young-whites/microcurrent-beauty-device-v10/docs/项目需求文档.md

# DJM-V10 微电流美容仪 - 项目需求文档

> **版本**: V4.1  
> **日期**: 2026-08-01  
> **适用平台**: STM32F103RCT6 / RT-Thread v5.1.0 / STM32 HAL

---

## 一、文档变更记录

| 版本 | 日期 | 作者 | 主要改动 |
|---|---|---|---|
| V1.0 | 2026-06-12 | — | 初始版本，NTC 温度传感器参考表从通讯协议文档迁入 |
| V2.0 | 2026-06-17 | — | 基于源码分析大幅扩充：新增硬件平台、软件架构、通信协议、功能模块、波形系统、安全机制、数据模型、接口定义、非功能需求 |
| V2.1 | 2026-07-08 | — | 同步代码变更：新增 ntc_sensor/temp_pid/nnc6521_waveform_config 模块，更新文件结构，移除已实现的 TODO 项，更新温度控制和波形切换状态 |
| V2.2 | 2026-07-09 | — | 修正加热控制引脚：小手柄 PC10（非 PC12），大手柄 PC11 |
| V3.0 | 2026-07-09 | — | 新增电源管理系统、BSP 驱动层（LED/KEY/BEEP/HARD）、macTask 任务层，重构系统架构与全局标志位 |
| V3.1 | 2026-07-09 | — | 拆分 protocol.c 为 protocol.c（协议驱动）+ protocol_act.c（动作处理），更新接口定义与目录结构 |
| V3.2 | 2026-07-09 | — | 手柄切换改为互斥模式：切换时清零其他手柄参数，关闭所有输出 |
| V3.3 | 2026-07-13 | — | 电源控制逻辑重构：按键改为短按开机/短按关机请求（去掉2s/4s长按），关机需上位机确认（10s超时不关机）；54V boost与治疗启停联动；加热器/水泵协议→硬件联动；LED_Name_Green→LED_Name_Start |
| V3.5 | 2026-07-14 | — | 新增温度周期上报功能（0x0B）、PID 参数自整定功能（0x0C）；温度编码改为 temp*10 int16 大端序 |
| V3.6 | 2026-07-14 | — | 新增「电刺激模块完整流程」和「温控模块完整流程」章节，含初始化、启动、运行、停止全流程图及寄存器说明 |
| V3.7 | 2026-07-14 | — | 泵控制改为 DAC7311 调压控制（0~5V），新增泵控完整流程、DAC7311 驱动规格、VOFA+ PID 调试输出说明 |
| V3.9 | 2026-07-23 | — | 温度控制从直接温度值改为百分比(0~100)，映射20~41°C；电流档位映射表线性化 |
| V4.0 | 2026-07-31 | — | 微电流输出改为全局功能：电流控制(0x02)删除 handle_id 参数；手柄切换(0x01)保留电流/波形参数；手柄功能矩阵更新；电流档位范围从 0~80 改为 0~10（查表获取实际 μA）；NNC6521 仅使用 CHIP_2 CH0 作为全局微电流输出；54V boost 使用 LGS6302EP-2 (PB1) 作为全局电流供电 |
| V4.1 | 2026-08-01 | — | 明确电流输出全局行为：切换手柄时电流/波形输出不停止（仅受开始/暂停治疗控制）；档位=0 时停止波形输出；A/B/C 加热与泵控互斥规则不变 |

---

## 二、项目概要

- **项目名称**: DJM-V10 微电流美容仪
- **项目路径**: `I:\Github-young-whites\microcurrent-beauty-device-v10`
- **代码路径**: `I:\Github-young-whites\microcurrent-beauty-device-v10\workItem-djm-v10-LTS`
- **设备地址**: `0x6066`（高字节 0x60，低字节 0x66）
- **固件版本**: V1.0（主版本 0x01，次版本 0x00）
- **功能概述**: 一款支持 3 个手柄的微电流美容仪，通过 Android 设备控制，支持 9 种微电流波形、温度加热、泵驱动等功能

---

## 三、硬件平台

### 3.1 MCU 规格

| 参数 | 值 |
|---|-----|
| 芯片型号 | STM32F103RCT6 |
| 内核 | ARM Cortex-M3 |
| 封装 | LQFP64 |
| 主频 | 72MHz（HSE + PLL x9） |
| Flash | 256KB |
| RAM | 48KB |
| 开发工具链 | GCC（STM32CubeIDE / Makefile） |
| HAL 库版本 | STM32Cube FW_F1 V1.8.7 |

### 3.2 时钟配置

| 时钟域 | 频率 |
|---|---|
| SYSCLK | 72 MHz |
| AHB (HCLK) | 72 MHz |
| APB1 | 36 MHz（HCLK/2） |
| APB2 | 72 MHz |
| APB1 Timer | 72 MHz |
| APB2 Timer | 72 MHz |
| ADC | 12 MHz（APB2/6） |

### 3.3 外设分配

| 外设 | 功能 | 引脚 |
|---|---|---|
| USART1 | Android 设备通信（9600bps, 8N1） | PA9(TX) / PA10(RX) |
| USART2 | Debug 调试日志（115200bps, 8N1） | PA2(TX) / PA3(RX) |
| ADC1_CH10 | 大手柄 NTC 温度采集 | PC0 |
| ADC1_CH11 | 小手柄 NTC 温度采集 | PC1 |
| GPIO Output | 蜂鸣器（BEEP） | PA7 |
| GPIO Output | 小手柄加热控制 | PC10 |
| GPIO Output | 大手柄加热控制 | PC11 |

### 3.4 NNC6521 双芯片引脚映射

本项目使用两颗 NNC6521 微电流刺激芯片，通过软件 SPI（GPIO Bit-Bang）驱动。

| 功能 | Chip 1（NNC6521_1） | Chip 2（NNC6521_2） |
|---|---|---|
| MOSI | PC9 | PB13 |
| CSN | PC8 | PB12 |
| SCLK | PC7 | PB11 |
| MISO | PA8 | PB14 |
| CHIP_EN | PA12 | PC6 |
| INTB（中断） | PA11 | PB15 |

**SPI 时序**: CPOL=0, CPHA=0, MSB First  
**写协议**: 4 字节 `[addr, cmd(0x80/0xC0), data, 0x00]`  
**读协议**: 3 字节 `[addr, cmd(0x00/0x40), dummy]` → 返回数据  
**cmd 含义**: `0x80` = 普通寄存器写, `0xC0` = 波形寄存器写, `0x00` = 普通寄存器读, `0x40` = 波形寄存器读  
**位操作时序**: MOSI 建立后 4x NOP (~55ns)，SCLK 高电平 8x NOP，SCLK 低电平 4x NOP  
**CHIP_EN 复位**: 低电平 ≥1ms → 高电平 ≥5ms

---

## 四、软件架构

### 4.1 RT-Thread 内核配置

| 配置项 | 值 |
|---|-----|
| RT-Thread 版本 | v5.1.0 (0x50100) |
| 线程优先级范围 | 32 级 |
| 系统 Tick 频率 | 1000 Hz（1ms） |
| 最大线程名长度 | 8 字符 |
| 内存管理 | 小内存管理（small_mem） |
| IPC 机制 | 信号量、互斥量、事件、邮箱、消息队列 |
| 设备框架 | 串口驱动（Serial V1） |
| 终端 Shell | MSH（FinSH） |
| idle 线程栈 | 256 字节 |
| timer 线程栈 | 512 字节，优先级 4 |

### 4.2 模块层次结构

```
┌──────────────────────────────────────────────────┐
│                   main.c                          │
│  HAL_Init → SystemClock_Config → MX_GPIO_Init    │
│  → MX_USART1/2_Init → MX_ADC1_Init               │
├──────────────────────────────────────────────────┤
│              macSYS（系统层）                      │
│  bsp_sys.h      → 全局头文件聚合                   │
│  bsp_typedef.h  → 全局数据结构（Record, Flag）     │
│  rtt_system_work → 10ms 周期定时器框架             │
├──────────────────────────────────────────────────┤
│              macBSP（驱动层）                       │
│  protocol.h/.c          → UART 协议帧收发与解码    │
│  protocol_act.h/.c      → 命令分发与动作处理       │
│  nnc6521.h              → NNC6521 驱动 API 声明    │
│  nnc6521_reg.h          → NNC6521 寄存器定义       │
│  nnc6521_spi.c          → 软件 SPI 驱动            │
│  nnc6521_drv.c          → NNC6521 高级驱动         │
│  nnc6521_waveform.c     → 预定义波形数据           │
│  nnc6521_waveform_config → 9 种波形配置与应用      │
│  ntc_sensor.h/.c        → NTC 温度采集与转换       │
│  temp_pid.h/.c          → PID 温度控制器           │
├──────────────────────────────────────────────────┤
│         RT-Thread Kernel + HAL Library             │
└──────────────────────────────────────────────────┘
```

### 4.3 线程与定时器

| 名称 | 类型 | 优先级 | 栈大小 | 周期 | 功能 |
|---|---|---|---|---|---|
| main | 线程 | 10 | 2048 | — | CubeMX 主循环 + 模块初始化 |
| power_task | 线程 | 15 | 512 | 20ms | 电源管理状态机（开机/关机） |
| proto_decode | 线程 | 10 | 2048 | — | UART1 协议解码线程 |
| LED_Thread | 线程 | 9 | 4096 | 10ms | LED 驱动扫描（呼吸/闪烁） |
| tshell (FinSH) | 线程 | 20 | 4096 | — | MSH 调试终端 |
| sysTimer | 软件定时器 | 4 | — | 1ms | 系统定时器：分频触发 1ms/10ms/50ms/500ms/1s 回调 |
| keyTimer | 软件定时器 | — | — | 10ms | 按键扫描定时器（消抖+事件检测） |
| beepTimer | 软件定时器 | — | — | 1ms | 蜂鸣器驱动定时器（鸣叫模式） |
| proto_rx_sem | 信号量 | — | — | — | UART1 接收中断唤醒解码线程 |

### 4.4 自动初始化

| 模块 | 初始化函数 | 触发级别 | 说明 |
|---|---|---|---|
| 系统定时器 | `sysTimer_Init()` | `INIT_APP_EXPORT` | 1ms 周期定时器 |
| 协议模块 | `protocol_init()` | `INIT_APP_EXPORT` | UART1 + 解码线程 |
| 按键定时器 | `keyTimer_Init()` | `INIT_APP_EXPORT` | 10ms 按键扫描 |
| 蜂鸣器定时器 | `beepTimer_Init()` | `INIT_APP_EXPORT` | 1ms 蜂鸣器驱动 |
| LED 线程 | `LED_Thread_Init()` | `INIT_APP_EXPORT` | 10ms LED 扫描 |
| 电源管理 | `power_task_init()` | `main()` 手动调用 | 在 NNC6521 初始化之后 |

---

## 五、通信协议

### 5.1 帧格式

```
+--------+--------+------+--------+--------+------+-------+------+-------+-------+
| HEAD1  | HEAD2  | LEN  | ADDR_H | ADDR_L | TYPE | STATE | FUNC | PARAMS| CRC16 |
| 0x55   | 0xAA   | var  | 0x60   | 0x66   | var  | var   | var  | var   | 2B    |
+--------+--------+------+--------+--------+------+-------+------+-------+-------+
```

| 字段 | 长度 | 说明 |
|---|---|---|
| HEAD1 | 1B | 固定 0x55 |
| HEAD2 | 1B | 固定 0xAA |
| LEN | 1B | 从 LEN 字段本身到 PARAMS 末尾的字节数（不含 HEAD1/HEAD2，不含 CRC） |
| ADDR_H | 1B | 设备地址高字节（0x60） |
| ADDR_L | 1B | 设备地址低字节（0x66） |
| TYPE | 1B | 帧类型：0x44=动作命令，0x45=参数查询 |
| STATE | 1B | 帧状态：0x02=主机请求(ASK)，0x01=设备应答(ACK) |
| FUNC | 1B | 功能码（0x01~0x0A） |
| PARAMS | NB | 功能参数（长度由 LEN 决定） |
| CRC16 | 2B | CRC16-MODBUS，计算范围为 LEN ~ PARAMS 末尾 |

### 5.2 CRC16-MODBUS 算法

- 初始值: `0xFFFF`
- 多项式: `0xA001`（反转）
- 计算范围: LEN 字段到 PARAMS 最后一个字节

### 5.3 解码状态机

```
IDLE → HEAD2 → LENGTH → ADDR_H → ADDR_L → PAYLOAD → CRC_H → CRC_L
  ↑                                                             │
  └─────────────────── 校验失败 / 正常完成 ──────────────────────┘
```

### 5.4 串口缓冲区配置

| 参数 | 值 |
|---|-----|
| 接收环形缓冲区 | 512 字节 |
| 发送缓冲区 | 64 字节 |
| 最大帧长度 | 64 字节 |
| 命令解码缓冲区 | 32 字节 |
| UART 接收缓冲区 | 1024 字节（rt_device buf） |

---

## 六、功能需求（分模块）

### 6.1 手柄切换模块（功能码 0x01）

**功能描述**: 切换当前活动手柄。

| 手柄 ID | 手柄名称 | 功能 |
|---|---|---|
| 0x0A | 手柄 A | 仅加热（微电流为全局功能） |
| 0x0B | 手柄 B | 仅加热（微电流为全局功能） |
| 0x0C | 手柄 C | 仅泵（微电流为全局功能） |
| — | 全局 | 微电流输出，上电即存在，所有界面可调 |

**请求参数**:
| 字段 | 长度 | 说明 |
|---|---|---|
| handle_id | 1B | 目标手柄 ID（0x0A/0x0B/0x0C） |

**应答参数**:
| 字段 | 长度 | 说明 |
|---|---|---|
| handle_id | 1B | 已切换到的手柄 ID |

**行为**:
1. **电流/波形输出不停止**：切换手柄不影响微电流输出，电流和波形为全局功能，仅受开始/暂停治疗（0x05）和档位=0 控制
2. 关闭所有加热输出（大手柄/小手柄）
3. 关闭气泵
4. 仅清零手柄的加热/泵参数（目标温度、泵转速），**保留**电流值和波形参数（电流/波形为全局功能）
5. 重置手柄的 PID 温控目标为 0
6. 更新全局 `current_handle` 字段，`is_running` 置 0
7. 校验 handle_id 合法性，非法则返回错误码 0x01
8. 微电流 boost (PB1) 为全局供电，切换手柄时不停止微电流输出（由治疗启停控制）
9. 关闭所有加热器和气泵硬件（加热和泵控为手柄独立功能，互斥）

### 6.2 电流控制模块（功能码 0x02）

**功能描述**: 设置微电流输出档位（全局功能，与手柄无关）。

**请求参数**:
| 字段 | 长度 | 说明 |
|---|---|---|
| current_level | 1B | 电流档位（0~10，0=关闭，查表获取实际 μA） |

**应答参数**:
| 字段 | 长度 | 说明 |
|---|---|---|
| current_level | 1B | 设置的档位值 |

**行为**:
1. 保存到全局 `current_level` 字段
2. 立即更新 NNC6521 输出
3. 固件 clamp 逻辑：若档位 < 波形最小电流，输出波形最小电流；若档位 > 波形最大电流，输出波形最大电流
4. **全局功能**：切换手柄时保留不清零
5. **档位=0 时停止波形输出**：current_level=0 时禁用 AWG，等效于暂停电流输出

### 6.3 温度控制模块（功能码 0x03）

**功能描述**: 设置手柄加热目标温度，通过 PID 算法自动调节加热功率。

**请求参数**:
| 字段 | 长度 | 说明 |
|---|---|---|
| temperature | 1B | 温度百分比（0~100，0=关闭加热，1~100=百分比，映射到 20~41℃） |
| handle_id | 1B | 目标手柄 ID（仅支持 0x0A 和 0x0B） |

**应答参数**:
| 字段 | 长度 | 说明 |
|---|---|---|
| temperature | 1B | 设置的温度百分比值 |
| handle_id | 1B | 目标手柄 ID |

**手柄-温控映射**:
| 手柄 | PID 实例 | 加热器 | 说明 |
|---|---|---|---|
| A (0x0A) | TEMP_PID_SMALL | 小手柄加热器 (PC10) | 小手柄温控 |
| B (0x0B) | TEMP_PID_LARGE | 大手柄加热器 (PC11) | 大手柄温控 |
| C (0x0C) | 无 | 无 | 不支持加热，返回错误 |

**行为**:
1. 温度百分比范围限制: 0~100（0=关闭，1~100=百分比，映射到 20~41℃）
2. 映射公式：`temp = 20.0 + (percent - 1) × 21.0 / 99.0`
2. 仅手柄 A 和 B 支持加热（手柄 C 返回错误）
3. 温度=0 时关闭加热，>0 时启用 PID 控温
4. **温控互斥**: 设置一个手柄的温度时，自动关闭另一个手柄的 PID 控制器
5. 调用 `temp_pid_set_target()` 设置目标温度，PID 控制器自动调节加热占空比
6. 温控完整流程:
   ```
   上位机发温度指令 → handle_temp_ctrl() → temp_pid_set_target(ch, 映射后的温度)
                                                 ↓
   10ms 定时器 → ntc_sensor_update()（ADC 读取 + 滤波 + 查表 → 温度值）
              → temp_pid_tick()（每 100ms：PID 计算 → 软件 PWM → GPIO 控制）
   ```
7. 安全保护:
   - 过热 45°C 强制关断
   - 传感器故障检测（连续 10 次异常）
   - 积分抗饱和（I_MAX=80, I_MIN=-10）
   - 死区 0.3°C（避免继电器抖动）
   - 超温保护（超过目标 1°C 强制输出 0，积分衰减 5%）

### 6.4 泵控制模块（功能码 0x04）

**功能描述**: 通过 DAC7311 调压控制手柄 C 的泵转速。

**请求参数**:
| 字段 | 长度 | 说明 |
|---|---|---|
| speed | 1B | 泵转速百分比（0~100，0=停止） |

**应答参数**:
| 字段 | 长度 | 说明 |
|---|---|---|
| speed | 1B | 设置的转速百分比 |

**硬件接口**:
| 组件 | 说明 |
|---|---|
| DAC7311 | 14-bit SPI DAC，输出 0~5V |
| PB7 | DAC7311_SYNC（片选，低电平有效） |
| PB8 | DAC7311_SCLK（时钟） |
| PB9 | DAC7311_DIN（数据） |

**DAC7311 驱动规格**:
- 分辨率：14-bit（0~16383，满量程 0x3FFF）
- 输出电压：VOUT = VREF × D / 16384（VREF = VDD = 5V）
- SPI 协议：Mode 0（CPOL=0, CPHA=0），16-bit 帧，MSB 先传
- 帧格式：[M1 M0 D13 D12 ... D1 D0 R R]，M=00 表示正常工作
- 帧组装：frame = (mode << 14) | (value << 2)

**泵控电压区间**:
| 电压区间 | 功能 | 说明 |
|---|---|---|
| 0.0V ~ 0.5V | 死区 | 泵不转 |
| 0.6V ~ 4.5V | 调速区间 | 线性调速 |
| 4.6V ~ 5.0V | 满载恒速区间 | 泵全速运行 |

**上位机百分比 → 电压映射**:
| 上位机指令 | 输出电压 | 说明 |
|---|---|---|
| 0% | 0.0V | 关泵 |
| 1%~90% | 0.6V ~ 4.5V | 调速区间（线性插值） |
| 91%~100% | 4.6V ~ 5.0V | 满载恒速区间（线性插值） |

**行为**:
1. 泵仅适用于手柄 C（索引 2）
2. 转速范围: 0~100%
3. 通过 DAC7311 输出模拟电压控制泵转速
4. 收到泵速命令后联动硬件：`dac7311_set_pump_speed(speed)`
5. 速度=0 时输出 0V（泵停止）
6. 切手柄或关机时自动关闭泵：`dac7311_set_pump_speed(0)`

**泵控完整流程**:
````
上位机发泵速指令 [0x04, 50]（50%）
        ↓
handle_pump_ctrl()
   - 校验 speed ≤ 100
   - 保存 pump_speed = 50
   - dac7311_set_pump_speed(50)
     → 50% 在 1%~90% 区间（调速区间）
     → ratio = (50-1)/(90-1) = 0.551
     → V = 0.6 + 0.551 × (4.5-0.6) = 2.75V
     → D = 2.75/5.0 × 16383 = 9010
     → SPI 帧：(0x00<<14) | (9010<<2) = 0x8C88
   - 返回 ACK [0x32]
        ↓
切手柄 / 关机
   → dac7311_set_pump_speed(0) → 输出 0V → 泵停止
```

### 6.5 开始/暂停模块（功能码 0x05）

**功能描述**: 控制治疗过程的开始和暂停。

**请求参数**:
| 字段 | 长度 | 说明 |
|------|------|------|
| action | 1B | 0x00=暂停，0x01=开始 |

**应答参数**:
| 字段 | 长度 | 说明 |
|------|------|------|
| action | 1B | 执行的动作 |

**行为**:
- **开始 (0x01)**:
  1. 使能对应手柄的 54V boost（Handle A/B → PB0, Handle C → PB1）
  2. 延时 10ms 等待 boost 稳定（软启动）
  3. 设置 `is_running = 1`
  4. 调用 `handle_apply_output()` 按当前全局电流值输出波形
- **暂停 (0x00)**:
  1. 调用 `handle_stop_output()` 停止 NNC6521 波形输出
  2. 关闭对应手柄的 54V boost
  3. 设置 `is_running = 0`

### 6.6 OTA 升级模块（功能码 0x06）

**功能描述**: 远程固件升级（**预留功能，当前未实现**）。

- 收到请求后返回 ACK
- 实际升级流程待后续开发

### 6.7 老化模式模块（功能码 0x07）

**功能描述**: 工厂老化测试模式。

**请求参数**:
| 字段 | 长度 | 说明 |
|------|------|------|
| action | 1B | 0x00=退出老化，0x01=进入老化 |

**应答参数**:
| 字段 | 长度 | 说明 |
|------|------|------|
| action | 1B | 执行的动作 |

**行为**:
1. 进入老化模式: 停止当前治疗，设置 `aging_mode = 1`
2. 退出老化模式: 设置 `aging_mode = 0`
3. **TODO**: 实际老化测试序列尚未实现

### 6.8 版本读取模块（功能码 0x08）

**功能描述**: 读取固件版本号。

**请求参数**: 无

**应答参数**:
| 字段 | 长度 | 说明 |
|------|------|------|
| version_major | 1B | 主版本号（当前 0x01） |
| version_minor | 1B | 次版本号（当前 0x00） |

### 6.9 波形选择模块（功能码 0x09）

**功能描述**: 切换微电流波形类型。

**请求参数**:
| 字段 | 长度 | 说明 |
|------|------|------|
| waveform_id | 1B | 波形 ID（1~9） |

**应答参数**:
| 字段 | 长度 | 说明 |
|------|------|------|
| waveform_id | 1B | 已选择的波形 ID |

**行为**:
1. 波形 ID 范围: 1~9，超出返回错误码 0x01
2. 波形切换为全局功能，无手柄绑定
3. 若当前正在运行治疗（is_running=1），切换波形后立即应用新波形到 NNC6521
4. 若当前未运行（is_running=0），仅保存波形 ID，下次开始治疗时生效
5. 调用 `waveform_apply()` 将波形配置写入 NNC6521 芯片

### 6.10 关机请求/确认模块（功能码 0x0A）

**功能描述**: 设备向上位机发送关机请求，等待上位机确认或拒绝。

**设备→上位机（关机请求）**:
| 字段 | 长度 | 说明 |
|------|------|------|
| para[0] | 1B | 0x00（固定，表示关机请求） |

**上位机→设备（确认/拒绝）**:
| 字段 | 长度 | 说明 |
|------|------|------|
| para[0] | 1B | 0x01=确认关机，0x00=拒绝关机 |

**行为**:
1. 设备在 ON 状态下短按电源按钮，发送关机请求（state=ACK, para=0x00）
2. 上位机收到后弹窗让用户选择
3. 选择"是"：上位机发送确认帧（state=ASK, para=0x01），设备执行完整关机序列
4. 选择"否"：上位机发送拒绝帧（state=ASK, para=0x00），设备回到 ON 状态
5. 10s 超时未收到回复：设备自动回到 ON 状态，不关机
6. 开机不需要请求，短按直接开机

### 6.11 温度周期上报模块（功能码 0x0B）

**功能描述**: 设备周期性向上位机上报当前手柄温度。

**帧方向**: 设备→上位机（主动上报，无需上位机请求）

**帧格式**:
| 字段 | 值 | 说明 |
|------|-----|------|
| HEAD | 55 AA | 帧头 |
| LEN | 0x06 | 长度 |
| ADDR | 60 66 | 设备地址 |
| TYPE | 0x01 | 设备应答 |
| STATE | 0x01 | ACK |
| FUNC | 0x0B | 温度上报 |
| handle_id | 1B | 当前活动手柄 ID |
| temp_high | 1B | 温度高字节（temp×10 的 int16 大端序） |
| temp_low | 1B | 温度低字节 |
| CRC16 | 2B | CRC16-MODBUS |

**温度编码**: `temp_encoded = (int16_t)(temperature × 10)`，大端序拆分为 2 字节
- 示例：37.5°C → 375 → 0x0177 → temp_high=0x01, temp_low=0x77
- 范围：-3276.8°C ~ +3276.7°C

**行为**:
1. 治疗开始时启动 2 秒周期定时器
2. 治疗暂停、切换手柄、关机时停止定时器
3. 仅在 is_running=1 时上报
4. NTC 映射：Handle A → NTC_CH_SMALL (PC1)，Handle B → NTC_CH_LARGE (PC0)
5. Handle C 无温度传感器，不上报

### 6.12 PID 参数自整定模块（功能码 0x0C）

**功能描述**: 通过继电反馈法自动整定 PID 参数。

**请求参数**:
| 字段 | 长度 | 说明 |
|------|------|------|
| target_temp | 1B | 目标温度（0~41°C） |

**应答参数（启动时）**:
| 字段 | 长度 | 说明 |
|------|------|------|
| status | 1B | 0x00 = 自整定已启动 |
| kp~kd | 6B | 全部为 0（尚未计算） |

**应答参数（完成时）**:
| 字段 | 长度 | 说明 |
|------|------|------|
| status | 1B | 0x01 = 自整定完成 |
| kp_high | 1B | Kp 高字节（int16×100 大端序） |
| kp_low | 1B | Kp 低字节 |
| ki_high | 1B | Ki 高字节 |
| ki_low | 1B | Ki 低字节 |
| kd_high | 1B | Kd 高字节 |
| kd_low | 1B | Kd 低字节 |

**应答参数（错误时）**:
| 字段 | 长度 | 说明 |
|------|------|------|
| status | 1B | 0x02 = 自整定失败 |
| params | 6B | 全部为 0 |

**算法原理**:
1. 继电反馈法（Relay Feedback）：bang-bang 控制产生等幅振荡
2. 加热器以 100% 加热至 target + 2°C，然后以 0% 降温至 target - 2°C
3. 重复 6 个完整周期
4. 测量振荡周期 Tu 和幅度 Au
5. Ziegler-Nichols 公式：Ku = 4d/(π×a)，Kp=0.6Ku，Ki=2Kp/Tu，Kd=Kp×Tu/8

**安全保护**:
- 过热 45°C 强制中止
- 超时 20 分钟自动中止
- 自整定过程中 PID 安全检查仍然生效

**行为**:
1. 收到命令后启动自整定流程
2. 自整定期间 PID 切换为 bang-bang 控制模式
3. 完成后自动应用新的 PID 参数
4. 通过协议通知上位机结果

---

## 七、波形系统

### 7.1 预定义波形列表

| ID | 名称 | 电流范围 | 频率 | 脉宽 | 波形类型 | 描述 |
|----|------|---------|------|------|---------|------|
| 1 | 劲感律动 | 0~10 档位 | 50 Hz | 300 μs | 对称方波 | 强力对称双相方波 |
| 2 | 活力律动 | 0~10 档位 | 50 Hz (burst 10 Hz) | 300 μs | 突发训练 | 突发脉冲串 |
| 3 | 轻柔律动 | 0~10 档位 | 35 Hz | 300 μs | 对称方波 | 温和对称双相方波 |
| 4 | 深润柔护 | 0~10 档位 | 40~50 Hz | 4 kHz 载波 | 平衡方波 | 4kHz载波深层柔护 |
| 5 | 包裹柔护 | 0~10 档位 | 30~40 Hz | 2~4 kHz | 正弦波 | 2~4kHz正弦波包裹 |
| 6 | 脉动柔护 | 0~10 档位 | 2~10 Hz | 4 kHz 载波 | 平衡正弦 | 4kHz载波脉动柔护 |
| 7 | 平顺舒缓 | 0~10 档位 | 80~100 Hz | 400 μs | 三角波 | 平衡三角波舒缓 |
| 8 | 胀感舒缓 | 0~10 档位 | 5 Hz | 450 μs | 低频正弦 | 低频正弦波舒缓 |
| 9 | 静谧收尾 | 0~10 档位 | 10 Hz | 低频正弦 | 正弦波 | 低频正弦波收尾 |

### 7.2 电流映射规则

电流档位范围 0~10（0=关闭），固件自动 clamp 到各波形的有效电流范围：

```
if current_level < min_current: actual_current = min_current
if current_level > max_current: actual_current = max_current
else: actual_current = current_level
```

| 波形 ID | min_current | max_current |
|---------|------------|------------|
| 1 | 0 | 10 |
| 2 | 0 | 10 |
| 3 | 0 | 10 |
| 4 | 0 | 10 |
| 5 | 0 | 10 |
| 6 | 0 | 10 |
| 7 | 0 | 10 |
| 8 | 0 | 10 |
| 9 | 0 | 10 |

### 7.3 波形生成方式

NNC6521 支持三种波形生成方式：

1. **预加载波形 (Preloaded)**: 芯片内置的正弦/脉冲/三角波，通过寄存器选择
2. **自定义波形 (Customized SPI)**: 通过 SPI 写入归一化浮点数组，由芯片 DAC 输出
3. **幅度调制 (Amplitude Modulation)**: 包络线 + 载波的调制输出

### 7.4 波形数据采样点

| 数据类型 | 采样点数 | 用途 |
|---------|---------|------|
| `normalized_sine_waveform_16` | 16 | 低精度正弦 |
| `normalized_sine_waveform_64` | 64 | 标准正弦（含半波拆分） |
| `normalized_sine_waveform_128` | 128 | 高精度正弦（含半波拆分） |
| `normalized_triangle_waveform_64` | 64 | 标准三角波（含半波拆分） |
| `normalized_triangle_waveform_128` | 128 | 高精度三角波（含半波拆分） |
| `normalized_pulse_waveform_128` | 128 | 脉冲波 |
| `normalized_user_waveform_128` | 128 | 自定义用户波形（指数衰减包络） |

### 7.5 波形点数选择规则

| 波形 ID | 采样点数 | 说明 |
|---------|---------|------|
| 4, 5, 6 | 128 | 高频/复杂波形使用更多采样点 |
| 其他 | 64 | 标准波形 |

---

## 八、手柄系统

### 8.1 手柄配置

| 手柄 | ID | 功能 | ADC 通道 | 加热控制引脚 | 泵控制 |
|------|----|------|---------|------------|--------|
| 手柄 A | 0x0A | 仅加热 | CH10 (PC0) | PC11 | — |
| 手柄 B | 0x0B | 仅加热 | CH11 (PC1) | PC10 | — |
| 手柄 C | 0x0C | 仅泵 | — | — | 通过 DAC7311 |
| — | — | 微电流（全局） | — | — | — |

> **注意**：微电流输出为全局功能（仅使用 NNC6521-2 CHIP_2 CH0 通道），上电即存在，所有手柄界面均可控制。54V boost 使用 LGS6302EP-2 (PB1)。切换手柄时仅清零加热/泵参数，保留电流和波形参数。

### 8.1.1 NNC6521 通道映射

| 手柄 | NNC6521 芯片 | 输出通道 | 54V Boost | 说明 |
|------|-------------|----------|-----------|------|
| 全局 | CHIP_2 | CH0 | PB1 (LGS6302EP-2) | 全局微电流输出，上电即存在 |
| A | — | — | — | 仅加热功能 |
| B | — | — | — | 仅加热功能 |
| C | — | — | — | 仅泵功能 |

- 仅使用 NNC6521-2 (CHIP_2) 的 CH0 通道作为全局微电流输出
- 不与任何手柄绑定，上电即初始化，随时可用
- 54V boost 使用 LGS6302EP-2 (PB1)，原为手柄 C 接口，现改为全局电流输出供电
- 电流输出时自动使能 boost（由治疗开始/暂停控制），切换手柄时 boost 不关闭

### 8.2 手柄参数结构

每个手柄独立维护以下参数：

```c
typedef struct {
    uint8_t temperature;        // 温度百分比 (0~100, 0=关闭, 1~100映射到20~41℃)
    uint8_t pump_speed;         // 泵转速 (0~100%)
} handle_params_t;
```

### 8.3 默认状态

- 默认活动手柄: 手柄 A
- 默认波形: Waveform 1 (Power Smooth)
- 所有手柄温度/泵参数默认为 0
- 电流档位默认为 0（全局变量）

---

## 九、电源管理系统

### 9.1 硬件接口

| 功能 | GPIO | 说明 |
|------|------|------|
| 12V 系统电源 | PA4 | 高电平使能，低电平关闭 |
| 电源按钮 | PA5 | 默认高电平，按下低电平（低有效） |
| 系统指示灯 | PA6 | 高电平亮，低电平灭（Start LED） |
| 蜂鸣器 | PA7 | 高电平响，低电平停 |
| 54V 升压 1 | PB0 | LGS6302EP-1 使能（高有效）（预留，不再用于微电流输出） |
| 54V 升压 2 | PB1 | LGS6302EP-2 使能（高有效），全局微电流输出供电 |
| 气泵 | PB10 | 高电平使能，低电平关闭 |
| 小手柄加热 | PC10 | PID 软件 PWM 输出 |
| 大手柄加热 | PC11 | PID 软件 PWM 输出 |

### 9.2 电源状态机

```
┌──────────┐  Flag.power_boot_request=1  ┌──────────┐
│  OFF     │ ─────────────────────────→  │ BOOTING  │
│ (待机)   │                             │ (开机中)  │
└──────────┘                             └────┬─────┘
     ↑                                        │ power_boot_sequence()
     │ power_do_shutdown()                    ↓
     │                                  ┌──────────┐
┌──────────┐  Flag.power_shutdown_      │   ON     │
│ SHUTTING │ ←  confirmed=1 ────────── │ (运行中)  │
│  DOWN    │                            └────┬─────┘
└──────────┘                                 │ Flag.power_shutdown_request=1
     ↑                                       ↓
     │                               ┌──────────────┐
     └──── confirmed=1 ──────────── │ WAIT_CONFIRM  │
                                     │ (等待确认)    │
                                     └──────┬───────┘
                                            │ denied=1 或 10s超时
                                            └───→ 回到 ON
```

### 9.3 开机流程

触发条件：`KEY_Scan()` 检测到 `KEY_Evt_Press` 事件（系统处于 OFF 状态）→ 设置 `Flag.power_boot_request = 1`

执行序列（`power_boot_sequence()`）：
1. `LED_On(LED_Name_Start)` — PA6 指示灯常亮
2. `BEEP_SetCycleDuty(1000, 1000)` + `BEEP_Blink(1, 0, 0)` — PA7 蜂鸣器响 1s（非阻塞）
3. `bsp_power_enable(1)` — PA4 12V 系统电源使能
4. **不使能 54V 升压**（仅在电刺激输出时开启）
5. 状态切换为 `POWER_STATE_ON`

### 9.4 关机流程

触发条件：`KEY_Scan()` 检测到 `KEY_Evt_Press` 事件（系统处于 ON 状态）→ 设置 `Flag.power_shutdown_request = 1`

执行序列：
1. 发送关机请求帧（func=0x0A, para=0x00）给上位机
2. 状态切换为 `POWER_STATE_WAIT_CONFIRM`
3. 等待上位机回复：
   - 收到确认（para=0x01）→ `Flag.power_shutdown_confirmed = 1` → 执行关机
   - 收到拒绝（para=0x00）→ `Flag.power_shutdown_denied = 1` → 回到 ON 状态
   - 10s 超时无回复 → 自动回到 ON 状态，不关机
4. 确认后执行关机序列（`power_do_shutdown()`）：
   a. `protocol_stop_waveform()` — 停止所有波形输出
   b. `bsp_heater_large_set(0)` + `bsp_heater_small_set(0)` — 关闭加热
   c. `bsp_pump_set(0)` — 关闭气泵
   d. `bsp_boost_1_enable(0)` + `bsp_boost_2_enable(0)` — 关闭 54V 升压
   e. `bsp_power_enable(0)` — 关闭 12V 电源
   f. `BEEP_Blink(1, 0, 0)` + 延时 1s — 蜂鸣器响一声
   g. `LED_Off(LED_Name_Start)` — 关闭指示灯
   h. 状态切换为 `POWER_STATE_OFF`

**注意**：
- 开机不需要上位机确认，短按直接开机
- 关机必须上位机确认，单片机不会自行关机
- 5s 超时强制关机已移除
- 4s 长按强制关机已移除

### 9.5 关机请求/确认协议

| 方向 | 帧内容 | 说明 |
|------|--------|------|
| 设备→上位机 | `55 AA 06 60 66 44 01 0A 00 [crcH] [crcL]` | 关机请求（func=0x0A, state=ACK, para=0x00） |
| 上位机→设备 | `55 AA 06 60 66 44 02 0A 01 [crcH] [crcL]` | 关机确认（func=0x0A, state=ASK, para=0x01） |
| 上位机→设备 | `55 AA 06 60 66 44 02 0A 00 [crcH] [crcL]` | 关机拒绝（func=0x0A, state=ASK, para=0x00） |

---

## 十、温度控制系统

### 10.1 NTC 温度传感器规格

| 参数 | 值 |
|------|-----|
| 标称电阻 | 100kΩ @ 25℃ |
| B 值 | 3950K（25/50℃） |
| 电阻精度 | ±1% |
| B 值精度 | ±1% |

### 10.2 ADC 采集方式

使用 RT-Thread ADC 设备框架（`rt_adc_read`），替代 HAL ADC 直接调用。

| 通道 | 引脚 | 用途 |
|------|------|------|
| ADC1_CH10 | PC0 | 小手柄 NTC 温度（TEMP_PID_SMALL） |
| ADC1_CH11 | PC1 | 大手柄 NTC 温度（TEMP_PID_LARGE） |

### 10.3 温度转换方法

采用**查表法 + 线性插值**（`NTC_USE_LOOKUP_TABLE=1`）：
- 176 点查找表，覆盖 -50°C ~ 125°C，步进 1°C
- ADC 值 → 分压公式算电阻 → 二分查找 → 线性插值 → 温度值
- 8 点滑动平均滤波消除 ADC 噪声
- 备选：B 参数公式（Steinhart-Hart 简化版），通过 `NTC_USE_LOOKUP_TABLE=0` 切换

### 10.4 PID 控温算法

**PID 参数**:
| 参数 | 值 | 说明 |
|------|-----|------|
| Kp | 8.0 | 比例增益 |
| Ki | 0.15 | 积分增益（每 100ms） |
| Kd | 3.0 | 微分增益 |
| 控制周期 | 100ms | PID 计算频率 |
| PWM 周期 | 1000ms | 10 个控制周期 |
| 死区 | 0.3°C | 避免继电器抖动 |
| 过热保护 | 45°C | 强制关断 |
| 积分限幅 | -10 ~ +80 | 抗饱和 |

**PID 公式（位置式 + 微分先行）**:
```
error = target - current
P = Kp × error
I += Ki × error  (抗饱和钳位)
D = Kd × (prev_measurement - current)  (微分先行避免设定值突变)
output = P + I + D  (钳位 0~100%)
```

**软件 PWM**:
- output=60% → duty=6/10
- tick 0~5: 加热器 ON
- tick 6~9: 加热器 OFF
- 周期 = 1000ms

### 10.5 温控完整流程

```
上位机发温度指令 [温度=37, 手柄=0x0A]
        ↓
① handle_temp_ctrl()
   - 校验：温度 ≤41，手柄有效，C 手柄拒绝
   - 互斥：关闭另一个手柄的 PID
   - 调用 temp_pid_set_target(A, 37.0)
        ↓
② temp_pid_set_target()
   - 钳位范围 0~41°C
   - 目标变化 >2°C 时重置积分项
   - enabled = 1
   - 目标=0 时直接关加热器
        ↓
③ 10ms 定时器循环调用：
   ┌─ ntc_sensor_update()
   │   - ADC 读取 CH10/CH11
   │   - 8 点滑动平均滤波
   │   - 查表 + 线性插值 → 温度值
   │
   └─ temp_pid_tick()
       └─ 每 100ms（10 次分频）：
           ├─ pid_compute()
           │   - 读当前温度
           │   - 安全检查（过热/传感器故障）
           │   - error = 目标 - 当前
           │   - |error| < 0.3°C → 死区，不调节
           │   - P = Kp × error
           │   - I += Ki × error（抗饱和 ±80）
           │   - D = Kd × (上次温度 - 当前温度)
           │   - 输出 = P + I + D，钳位 0~100
           │   - 超温 >1°C → 输出=0，积分衰减 5%
           │
           └─ pwm_update()
               - output=60% → duty=6/10
               - tick 0~5: 加热器 ON
               - tick 6~9: 加热器 OFF
               - 周期 = 1000ms
```

### 10.6 安全保护机制

| 保护功能 | 阈值 | 动作 |
|----------|------|------|
| 过热保护 | 45°C | 强制关断加热器，禁用 PID |
| 传感器故障 | 连续 10 次异常 | 关断加热器，禁用 PID |
| 积分抗饱和 | I_MAX=80, I_MIN=-10 | 防止积分项过大 |
| 死区 | 0.3°C | 避免在目标附近抖动 |
| 超温保护 | 超过目标 1°C | 输出=0，积分衰减 5% |
| 传感器范围 | -30°C ~ 100°C | 超出范围视为故障 |

### 10.7 加热控制引脚

| 手柄 | PID 实例 | 控制引脚 | GPIO |
|------|----------|---------|------|
| 手柄 A | TEMP_PID_SMALL | 小手柄加热 | PC10 |
| 手柄 B | TEMP_PID_LARGE | 大手柄加热 | PC11 |

### 10.8 初始化序列

```c
MX_ADC1_Init();          // CubeMX ADC 硬件初始化
ntc_sensor_init();       // NTC 传感器模块初始化（RT-Thread ADC 框架）
temp_pid_init();         // PID 控温模块初始化
```

---

## 十一、NNC6521 驱动层

### 11.1 芯片初始化流程

```
1. nnc6521_gpio_init()         → 初始化所有 GPIO 引脚
2. nnc6521_init(chip_id)       → 上电序列:
   a. CHIP_EN = LOW（复位）
   b. 延时 ~10ms
   c. CHIP_EN = HIGH（使能）
   d. 延时 ~10ms
   e. 写 PMU 寄存器: 复位波形发生器
   f. 配置时钟: PCLK 分频 = 1（2MHz）
   g. 全局驱动使能
```

### 11.2 波形发生器配置流程

```
1. 禁用目标通道 AWG
2. 使能模拟通道 (ANA_ENABLE_REG)
3. 写入配置寄存器组:
   - 采样点数 (POINT_CONFIG)
   - 配置寄存器 (CONFIG_REG0): rest/negative/silent/sourceB/multi_electrode/continue
   - 静默时间 (SILENT_CLK): 24-bit
   - 正半波间隔 (HALF_WAVE_CLK_PNT): 16-bit
   - 负半波间隔 (NEG_HALF_WAVE_CLK_PNT): 16-bit
   - 驱动电流寄存器 2 (DRIVE_REG_CTRL2)
   - 死区时间 (REST_CLK): 16-bit
   - 中断配置 (INT_NUM_WAVE, INT_REG01~03)
4. 若为 SPI 波形:
   a. 通过 OTP 校准数据计算电流
   b. 生成缩放波形数组 (16-bit → 8-bit)
   c. 逐点写入波形数据到 Waveform RAM
5. 配置交替模式寄存器
6. 使能 AWG
```

### 11.3 电流校准系统

- 校准数据存储在 NNC6521 OTP 内存中
- 25 个校准点（范围 3~25）
- CH1 校准基地址: `0x00`
- CH2 校准基地址: `0x32`
- 校准流程: 读取 OTP Dref → 计算 Ival = (Ireq × 1000) / Dref → 限制最大 4096

### 11.4 安全检测

#### 11.4.1 导联脱落检测 (LOD - Lead-Off Detection)

- 检测模式: 高电平检测
- 检测通道: CH1 + CH2 同时（LO_ALL）
- 寄存器组: `0x30~0x3B`（LEAD_OFF_xxx）
- 中断使能位: `LEAD_OFF_INT.lead_off_int_en`
- 配置参数: 阈值（16-bit）、延迟、目标值

#### 11.4.2 短路检测 (SCD - Short-Circuit Detection)

- 双通道独立检测
- 通过 DAC 阈值比较器实现
- 寄存器组: `ANA_INT_SIMx_xxx`, `ANA_INT_CHx_INT_NUMBER`
- 中断清零: 写 `ANA_INTR_SIM_CL = 0x03`

---

## 十二、全局数据模型

### 12.1 设备全局状态

```c
typedef struct {
    uint8_t current_handle;             // 当前活动手柄 (HANDLE_A/B/C)
    uint8_t waveform_id;                // 当前波形选择 (1~9)
    uint8_t current_level;              // 电流档位 (0~10, 0=关闭, 全局功能，查表获取 μA)
    uint8_t is_running;                 // 治疗运行标志 (0=暂停, 1=运行)
    uint8_t aging_mode;                 // 工厂老化模式标志
    handle_params_t handle[3];          // 手柄 A/B/C 参数 (索引 0/1/2)
} device_state_t;
```

### 12.2 错误码定义

| 错误码 | 名称 | 说明 |
|--------|------|------|
| 0x00 | ERR_OK | 成功 |
| 0x01 | ERR_PARAM | 参数错误 |
| 0x02 | ERR_UNSUPPORTED | 不支持的功能码 |
| 0x03 | ERR_BUSY | 设备忙 |
| 0xFF | ERR_UNKNOWN | 未知错误 |

### 12.3 系统记录结构

```c
typedef struct {
    rt_uint8_t   Empty;           // 空值
    rt_uint16_t  kprintf_cnt;     // kprintf 打印序列号
    rt_uint32_t  ulog_cnt;        // ulog 打印序列号
} RecordStruct;
```

### 12.4 系统标志结构

```c
typedef struct {
    /* Legacy flags */
    rt_uint8_t   air_rate_set;           // 潮气达标率设置标志

    /* Power management flags (set by KEY_Scan, read by power_task) */
    volatile rt_uint8_t   power_boot_request;       // 1 = 按键短按触发开机
    volatile rt_uint8_t   power_shutdown_request;   // 1 = 短按请求关机（ON状态下）
    volatile rt_uint8_t   power_shutdown_confirmed; // 1 = 上位机确认关机
    volatile rt_uint8_t   power_shutdown_denied;    // 1 = 上位机拒绝关机
} FlagStruct;
```

**标志位数据流**:
```
bsp_key.c KEY_Scan()  →  Flag.power_boot_request = 1（OFF状态下短按）
                        Flag.power_shutdown_request = 1（ON状态下短按）

power_task.c          ←  轮询 Flag.power_xxx → 执行开机/发送关机请求

protocol_act.c        →  Flag.power_shutdown_confirmed = 1（收到上位机确认 para=0x01）
                        Flag.power_shutdown_denied = 1（收到上位机拒绝 para=0x00）
```

---

## 十三、接口定义

### 13.1 协议模块接口（protocol.c — 纯协议驱动）

| 函数 | 说明 |
|------|------|
| `int protocol_init(void)` | 初始化 UART1 协议模块（硬件 + 线程 + 信号量） |
| `uint16_t protocol_crc16_modbus(const uint8_t *data, uint8_t len)` | CRC16-MODBUS 计算 |
| `void protocol_send_ack(uint8_t func, const uint8_t *params, uint8_t param_len)` | 发送 ACK 应答帧 |
| `void protocol_send_error(uint8_t func, uint8_t err_code)` | 发送错误应答帧 |
| `int protocol_handle_index(uint8_t handle_id)` | 手柄 ID → 索引转换 (0x0A→0, 0x0B→1, 0x0C→2) |
| `void protocol_update_current_output(void)` | 更新全局 NNC6521 电流输出（无手柄参数） |

### 13.2 协议动作模块接口（protocol_act.c — 命令处理与动作）

| 函数 | 说明 |
|------|------|
| `void protocol_dispatch(uint8_t *buf, uint8_t cmd_len)` | 帧分发：根据 func 路由到对应处理函数 |
| `void protocol_update_current_output(void)` | 更新全局 NNC6521 电流输出 |
| `void protocol_start_waveform(void)` | 启动波形输出 |
| `void protocol_stop_waveform(void)` | 停止波形输出 |
| `uint16_t protocol_clamp_current(uint8_t waveform_id, uint8_t current_level)` | 电流档位 clamp 到波形范围 |

### 13.3 NNC6521 驱动接口

| 函数 | 说明 |
|------|------|
| `void nnc6521_gpio_init(void)` | 初始化双芯片所有 GPIO |
| `void nnc6521_init(uint8_t chip_id)` | 芯片上电初始化序列 |
| `void nnc6521_spi_write(uint8_t chip_id, uint8_t addr, uint8_t data, uint8_t is_wave)` | SPI 写寄存器 |
| `uint8_t nnc6521_spi_read(uint8_t chip_id, uint8_t addr, uint8_t is_wave)` | SPI 读寄存器 |
| `uint8_t nnc6521_spi_otp_read(uint8_t chip_id, uint8_t addr)` | 读 OTP 内存 |
| `void nnc6521_awg_enable_disable(uint8_t chip_id, uint8_t AWG_ChannelNum, uint8_t Enable_Disable)` | 波形发生器使能/禁用 |
| `void nnc6521_preloaded_waveform(...)` | 预加载波形输出 |
| `void nnc6521_customized_waveform(...)` | 自定义波形输出 |
| `void nnc6521_amplitude_modulation(...)` | 幅度调制输出 |
| `void nnc6521_lod_init(...)` | 导联脱落检测初始化 |
| `void nnc6521_scd_init(...)` | 短路检测初始化 |
| `void nnc6521_clear_lod_int(uint8_t chip_id)` | 清除 LOD 中断标志 |
| `void nnc6521_clear_scd_int(uint8_t chip_id)` | 清除 SCD 中断标志 |
| `void nnc6521_wavegen_config(...)` | 波形发生器寄存器配置 |
| `void nnc6521_customized_amplitude(...)` | 更新波形幅度（中断上下文用） |
| `void nnc6521_customized_amplitude_addr(...)` | 更新指定地址范围的波形幅度 |

### 13.4 便捷宏

| 宏 | 说明 |
|-----|------|
| `nnc6521_write_reg(cid, addr, data)` | 写普通寄存器 |
| `nnc6521_read_reg(cid, addr)` | 读普通寄存器 |
| `nnc6521_write_wave_reg(cid, addr, data)` | 写波形寄存器 |
| `nnc6521_read_wave_reg(cid, addr)` | 读波形寄存器 |

---

## 十四、NTC 温度传感器参考表

### 14.1 温度-电阻对照表

| 温度(℃) | Rmax(kΩ) | Rnor(kΩ) | Rmin(kΩ) |
|---------|----------|----------|----------|
| -40 | 3588.69 | 3429.74 | 3277.51 |
| -35 | 2566.88 | 2461.35 | 2359.91 |
| -30 | 1858.69 | 1787.98 | 1719.78 |
| -25 | 1361.53 | 1313.78 | 1267.57 |
| -20 | 1008.27 | 975.80 | 944.29 |
| -15 | 754.38 | 732.19 | 710.58 |
| -10 | 569.93 | 554.70 | 539.83 |
| -5 | 434.55 | 424.08 | 413.82 |
| 0 | 334.23 | 327.02 | 319.94 |
| 5 | 259.19 | 254.24 | 249.36 |
| 10 | 202.58 | 199.20 | 195.85 |
| 15 | 159.52 | 157.23 | 154.95 |
| 20 | 126.50 | 124.97 | 123.45 |
| 25 | 101.00 | 100.00 | 99.00 |
| 30 | 81.51 | 80.53 | 79.55 |
| 35 | 66.18 | 65.24 | 64.31 |
| 37 | 60.98 | 60.07 | 59.17 |
| 40 | 54.04 | 53.16 | 52.30 |
| 41 | 51.92 | 51.07 | 50.22 |
| 45 | 44.36 | 43.56 | 42.77 |
| 50 | 36.62 | 35.88 | 35.16 |
| 55 | 30.37 | 29.71 | 29.06 |
| 60 | 25.32 | 24.72 | 24.13 |
| 65 | 21.20 | 20.66 | 20.13 |
| 70 | 17.83 | 17.35 | 16.87 |
| 75 | 15.06 | 14.63 | 14.20 |
| 80 | 12.77 | 12.38 | 12.01 |
| 85 | 10.87 | 10.53 | 10.19 |
| 90 | 9.29 | 8.98 | 8.68 |
| 95 | 7.97 | 7.69 | 7.42 |
| 100 | 6.86 | 6.61 | 6.37 |
| 105 | 5.92 | 5.70 | 5.48 |
| 110 | 5.13 | 4.93 | 4.74 |
| 115 | 4.46 | 4.28 | 4.11 |
| 120 | 3.89 | 3.73 | 3.57 |
| 125 | 3.40 | 3.25 | 3.11 |
| 130 | 2.98 | 2.85 | 2.72 |
| 135 | 2.62 | 2.50 | 2.39 |
| 140 | 2.31 | 2.20 | 2.10 |
| 145 | 2.04 | 1.95 | 1.85 |
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

---

## 十五、非功能需求

### 15.1 实时性要求

| 指标 | 要求 |
|------|------|
| 系统 Tick 分辨率 | 1 ms |
| 协议解码延迟 | < 10 ms（从接收完整帧到发送应答） |
| 波形切换响应 | < 50 ms |
| 定时器回调精度 | 1 ms（sysTimer） |

### 15.2 可靠性要求

| 指标 | 要求 |
|------|------|
| 串口 CRC 校验 | 每帧强制 CRC16-MODBUS 校验 |
| 环形缓冲区保护 | 互斥量保护，防止并发读写竞争 |
| 发送互斥 | 临界区 + 互斥量双重保护，防止帧交错 |
| 异常恢复 | 解码状态机在任何非法字节时自动回到 IDLE 状态 |

### 15.3 内存使用

| 区域 | 大小 |
|------|------|
| idle 线程栈 | 256 字节 |
| timer 线程栈 | 512 字节 |
| main 线程栈 | 2048 字节 |
| proto_decode 线程栈 | 2048 字节 |
| tshell 线程栈 | 4096 字节 |
| UART RX 环形缓冲区 | 512 字节 |
| UART TX 缓冲区 | 64 字节 |
| 命令解码缓冲区 | 32 字节 |
| Heap 大小 | 0x200 (512B, 由 CubeMX 配置) |

### 15.4 安全性要求

| 措施 | 说明 |
|------|------|
| 导联脱落检测 (LOD) | NNC6521 硬件支持，检测手柄电极脱落 |
| 短路检测 (SCD) | NNC6521 硬件支持，检测输出短路 |
| 温度上限保护 | 加热温度限制在 41℃ 以下 |
| 电流档位限制 | 0~10（全局），clamp 到波形范围，无越界风险 |
| 波形切换安全 | 全局功能，运行中切换立即生效，未运行时保存待生效；切换手柄不影响电流输出 |

---

## 十五-A、电刺激模块完整流程

### 启动初始化（main.c）

```c
MX_GPIO_Init();                    // CubeMX GPIO 初始化
MX_ADC1_Init();                    // ADC 硬件初始化
ntc_sensor_init();                 // NTC 传感器（RT-Thread ADC 框架）
temp_pid_init();                   // PID 控温模块
nnc6521_gpio_init();               // NNC6521 SPI 引脚初始化
nnc6521_init(NNC6521_CHIP_1);      // 芯片 1：CHIP_EN 复位 → PMU → 时钟 → 全局驱动
nnc6521_init(NNC6521_CHIP_2);      // 芯片 2：同上
nnc6521_analog_enable(CHIP_2, CH0); // 使能全局微电流输出通道（VDAC+COMP+DRIVER）
power_task_init();                 // 电源管理任务
```

### 治疗启动流程

```
上位机发切换手柄指令 [0x01, 0x0B]（切换到手柄 B）
        ↓
① handle_switch(0x0B)
   - 电流/波形输出不停止（全局功能，仅受治疗启停和档位控制）
   - 关闭所有加热器（PID 重置）
   - 关闭气泵
   - 仅清零手柄的加热/泵参数（温度、泵速），保留电流和波形参数
   - current_handle = 0x0B, is_running = 0
   - 返回 ACK
        ↓
上位机电流控制指令 [0x02, 0x05]（设置档位 5）
        ↓
② handle_current_ctrl(5)
   - 钳位到波形范围（如波形1: 0~10 → 5）
   - 保存 current_level = 5（全局）
   - 立即更新 NNC6521 输出
   - waveform_apply(CHIP_2, CH0, waveform_id, 5)
   - 返回 ACK
        ↓
上位机选择波形指令 [0x09, 0x03]（选择波形 3）
        ↓
③ handle_waveform_sel(3)
   - 更新 waveform_id = 3
   - 按新波形范围重算 current_percent
   - 如果正在运行：直接调用 handle_apply_output() 更新波形
   - 返回 ACK
        ↓
上位机开始治疗指令 [0x05, 0x01]
        ↓
④ handle_start_pause(1)
   - 使能 54V boost（全局电流输出 → boost_2 PB1）
   - 延时 10ms 等待 boost 稳定
   - is_running = 1
   - handle_apply_output(handle_idx=1)
     → waveform_apply(CHIP_2, CH0, 3, current_level)
       → nnc6521_wavegen_config()：禁用 AWG → 配置寄存器 → 使能 AWG
   - 启动温度上报定时器（2s 周期）
   - 返回 ACK
        ↓
治疗运行中...
   - NNC6521 持续输出波形
   - 10ms 定时器：NTC 温度采集 + PID 控温
   - 2s 定时器：温度上报
        ↓
上位机暂停治疗指令 [0x05, 0x00]
        ↓
⑤ handle_start_pause(0)
   - 禁用 AWG
   - 关闭 54V boost
   - is_running = 0
   - 停止温度上报定时器
   - 返回 ACK
```

### 电刺激模块关键寄存器

| 寄存器 | 地址 | 功能 | 初始化值 |
|--------|------|------|----------|
| PMU_REG | 0x01 | 电源管理（复位/睡眠） | 0x00（正常模式） |
| CLK_CTRL | 0x02 | PCLK 分频 | 0x00（÷1, 2MHz） |
| WAVEGEN_GLOBAL | 0x03 | 全局驱动使能 | 0x01（使能） |
| ANA_ENABLE_REG_1 | 0x41 | CH1 模拟前端使能 | |=0x1F（VDAC+COMP+IDAC+CSAMP+AMP） |
| ANA_ENABLE_REG_2 | 0x42 | CH2 模拟前端使能 | |=0x1F（同上） |
| WG_DRV_CTRL_REG0 | +0x01 | 波形发生器控制 | enable_wavegen=1, waveform_select=类型 |
| WG_DRV_CONFIG_REG0 | +0x00 | 波形配置 | rest/negative/silent/sourceB/multi/continue |

---

## 十五-B、温控模块完整流程

### 启动初始化（main.c）

```c
MX_ADC1_Init();         // CubeMX ADC1 硬件初始化（CH10 PC0, CH11 PC1）
ntc_sensor_init();       // NTC 传感器模块初始化
                         //   → rt_device_find("adc1")
                         //   → rt_adc_enable(ch10)
                         //   → rt_adc_enable(ch11)
                         //   → 清零滤波缓冲区
temp_pid_init();         // PID 控温模块初始化
                         //   → Kp=8.0, Ki=0.15, Kd=3.0
                         //   → 清零所有 PID 状态
                         //   → 关闭所有加热器
```

### 温控完整流程

```
上位机发温度指令 [0x03, 0x25, 0x0A]（设置 37°C，手柄 A）
        ↓
① handle_temp_ctrl()
   - 校验：温度 ≤41，手柄有效，C 手柄拒绝
   - 互斥：关闭手柄 B 的 PID（temp_pid_set_target(B, 0)）
   - 调用 temp_pid_set_target(SMALL, 37.0)
        ↓
② temp_pid_set_target()
   - 钳位 0~41°C
   - 目标变化 >2°C → 重置积分项
   - enabled = 1
   - 目标=0 → 直接关加热器
        ↓
③ 10ms 定时器循环（sysTimer 回调）
   ┌─ ntc_sensor_update()
   │   - rt_adc_read(adc_dev, CH10) → 大手柄 NTC 原始值
   │   - rt_adc_read(adc_dev, CH11) → 小手柄 NTC 原始值
   │   - 8 点滑动平均滤波
   │   - 查表 + 线性插值 → 温度值
   │
   └─ temp_pid_tick()
       └─ 每 100ms（10 次分频）：
           ├─ pid_compute()
           │   - 读当前温度
           │   - 安全检查（过热 45°C/传感器故障）
           │   - error = 37.0 - 当前温度
           │   - |error| < 0.3°C → 死区，不调节
           │   - P = 8.0 × error
           │   - I += 0.15 × error（抗饱和 -10~+80）
           │   - D = 3.0 × (上次温度 - 当前温度)
           │   - 输出 = P + I + D（钳位 0~100）
           │   - 超温 >1°C → 输出=0，积分衰减 5%
           │
           └─ pwm_update()
               - output=60% → duty=6/10
               - tick 0~5: 加热器 ON (PC10)
               - tick 6~9: 加热器 OFF
               - 周期 = 1000ms
```

### 温度上报流程

```
治疗开始 → handle_start_pause(1)
        ↓
protocol_temp_report_start(handle_id)
   → 创建 2s 周期定时器
   → 启动定时器
        ↓
每 2 秒触发回调 temp_report_timer_cb()
   → 读取当前手柄温度
   → 编码：temp × 10 → int16 → 大端序拆分
   → 构建帧：55 AA 06 60 66 44 01 0B [handle] [tempH] [tempL] [CRC]
   → 通过 UART1 发送
        ↓
治疗暂停/切手柄/关机 → protocol_temp_report_stop()
   → 停止定时器
```

### PID 自整定流程

```
上位机发自整定指令 [0x0C, 0x25]（目标 37°C）
        ↓
① handle_pid_autotune()
   → temp_pid_autotune_start(pid_idx, 37.0)
   → 关闭正常 PID 控制
   → 初始化自整定状态
   → 立即开启加热器（100%）
   → 返回启动 ACK [0x00, 0,0,0,0,0,0]
        ↓
② temp_pid_tick() 中处理自整定逻辑
   ┌─ 温度上升至 37 + 2 = 39°C
   │   → 关闭加热器（0%）
   │   → 记录高温峰值
   │
   └─ 温度下降至 37 - 2 = 35°C
       → 开启加热器（100%）
       → 记录低温谷值
       → 记录周期时间
       → cycle_count++
        ↓
③ 达到 6 个周期
   → 计算平均周期 Tu = period_sum / 6
   → 计算振荡幅度 a = (temp_high - temp_low) / 2
   → Ku = 4 × 50 / (π × a)
   → Kp = 0.6 × Ku
   → Ki = 2 × Kp / Tu（per-second → per-100ms 转换）
   → Kd = Kp × Tu / 8
   → 应用新参数
   → 恢复正常 PID 模式
   → 返回完成 ACK [0x01, kpH, kpL, kiH, kiL, kdH, kdL]
        ↓
异常处理
   - 超温 45°C → 强制中止，返回 [0x02, ...]
   - 超时 20 分钟 → 自动中止，返回 [0x02, ...]
```

### 手柄-温控映射

| 手柄 | PID 实例 | NTC 通道 | 加热器引脚 | Boost |
|------|----------|----------|-----------|-------|
| A (0x0A) | TEMP_PID_SMALL | CH11 (PC1) | PC10 | PB0 |
| B (0x0B) | TEMP_PID_LARGE | CH10 (PC0) | PC11 | PB0 |
| C (0x0C) | 无 | 无 | 无 | PB1 |

**温控互斥**：同一时间只有一个手柄的 PID 可以运行。

---

## 十六、TODO 待实现项

以下功能在代码中标记为 `TODO`，尚未实现：

| 位置 | 功能 | 说明 |
|------|------|------|
| `protocol_act.c` | OTA 升级序列 | 远程固件升级完整流程（预留，收到请求仅返回 ACK） |
| `protocol_act.c` | 老化测试序列 | 进入老化模式后的自动测试逻辑（预留，仅切换标志位） |

---

## 十七、目录结构

```
workItem-djm-v10/
├── applications/
│   ├── main.c                          # 主入口（模块初始化 + power_task_init）
│   ├── macBSP/                         # 板级驱动层
│   │   ├── Inc/
│   │   │   ├── bsp_hard.h              # GPIO 硬件抽象层头文件
│   │   │   ├── bsp_led.h               # LED 驱动头文件
│   │   │   ├── bsp_key.h               # 按键驱动头文件
│   │   │   ├── bsp_beep.h              # 蜂鸣器驱动头文件
│   │   │   ├── protocol.h              # 协议驱动头文件（帧格式、常量、结构体）
│   │   │   ├── protocol_act.h           # 协议动作头文件（命令分发、波形控制）
│   │   │   ├── nnc6521.h               # NNC6521 驱动头文件
│   │   │   ├── nnc6521_reg.h           # NNC6521 寄存器定义
│   │   │   ├── nnc6521_waveform_config.h # 波形配置头文件
│   │   │   ├── ntc_sensor.h            # NTC 温度传感器头文件
│   │   │   └── temp_pid.h              # PID 温控头文件
│   │   └── Src/
│   │       ├── bsp_hard.c              # GPIO 操作封装（电源/升压/泵/加热）
│   │       ├── bsp_led.c               # LED 驱动（On/Off/Toggle/Grad/Blink）
│   │       ├── bsp_key.c               # 按键驱动（消抖/短按事件 + KEY_Scan分发开机/关机请求）
│   │       ├── bsp_beep.c              # 蜂鸣器驱动（On/Off/Blink 模式）
│   │       ├── protocol.c              # 协议驱动（UART、CRC、帧收发、解码）
│   │       ├── protocol_act.c           # 协议动作（命令处理、波形控制、帧分发）
│   │       ├── nnc6521_drv.c           # NNC6521 高级驱动
│   │       ├── nnc6521_spi.c           # 软件 SPI 驱动
│   │       ├── nnc6521_waveform.c      # 预定义波形数据
│   │       ├── nnc6521_waveform_config.c # 波形配置与 waveform_apply()
│   │       ├── ntc_sensor.c            # NTC 温度采集与转换
│   │       └── temp_pid.c              # PID 温度控制算法
│   ├── macSYS/                         # 系统层
│   │   ├── Inc/
│   │   │   ├── bsp_sys.h               # 全局头文件聚合
│   │   │   ├── bsp_typedef.h           # 全局数据结构（Record, Flag）
│   │   │   ├── macSYS.h                # 兼容头文件
│   │   │   └── rtt_system_work.h       # 系统定时器接口
│   │   └── Src/
│   │       ├── bsp_sys.c               # 系统源文件
│   │       ├── bsp_typedef.c           # 全局变量初始化
│   │       └── rtt_system_work.c       # 10ms 周期定时器框架
│   └── macTask/                        # 任务层
│       ├── Inc/
│       │   └── power_task.h            # 电源管理任务头文件
│       └── Src/
│           └── power_task.c            # 电源管理状态机（开机/关机流程）
├── cubemx/                             # STM32CubeMX 工程
│   ├── cubemx.ioc                      # CubeMX 配置文件
│   ├── Inc/
│   │   └── main.h                      # GPIO 引脚定义
│   ├── Src/                            # HAL 初始化代码
│   └── Drivers/                        # HAL 库 & CMSIS
├── rtconfig.h                          # RT-Thread 内核配置
└── docs/
    └── 项目需求文档.md                   # 本文档
```

---

*—— Clerk 检索完毕*
