young-whites/microcurrent-beauty-device-v10/docs/通讯协议文档.md

# DJM-V10 微电流美容仪 - 通信协议文档

> **版本**: V5.0  
> **日期**: 2026-07-31  
> **适用平台**: STM32F103 / RT-Thread / HAL 库

---

> [!important] CRC字节序说明
> CRC16-MODBUS 计算结果为双字节，**在帧中以高字节在前、低字节在后的顺序存放**（Big-Endian）。
> 例如计算结果为 `0x0F48`，则帧中排列为 `0F 48`（先 crcH=`0x0F`，后 crcL=`0x48`）。
> ⚠️ 本文档所有完整帧示例均经 CRC 校验确认，可直接用于开发测试。

---

## 一、文档变更记录

| 版本 | 日期 | 作者 | 主要改动 |
|---|---|---|---|
| V1.0 | 2026-06-09 | — | 初始版本 |
| V2.0 | 2026-06-11 | — | 重写：手柄编号改为 A/B/C，温度上限 41℃，全部帧附带 CRC |
| V3.0 | 2026-06-11 | — | 修正设备地址为 0x6066，全部帧 CRC 重新计算 |
| V4.0 | 2026-06-11 | — | 修正 len 字段计算规则（含地址 2 字节），全部帧 CRC 重新计算 |
| V4.1 | 2026-06-12 | — | NTC 温度传感器参考表迁移至「项目需求文档.md」 |
| V4.2 | 2026-06-15 | — | 电流能量(0x02)和温度(0x03)指令新增手柄编号字节，解决多手柄共用参数问题，全部受影响帧 CRC 重新计算 |
| V4.3 | 2026-06-15 | — | 新增波形切换指令(func=0x09)，波形分组与电流范围说明 |
| V4.4 | 2026-07-09 | — | 修正协议概览功能码范围为 0x01~0x09（含波形切换） |
| V4.5 | 2026-07-10 | — | 手柄切换行为改为清零复位；新增 NNC6521 硬件映射说明；补充波形/电流/启停的硬件控制逻辑 |
| V4.6 | 2026-07-13 | — | 新增关机请求指令(func=0x0A)：设备→上位机关机请求，上位机→设备确认/拒绝；按键逻辑改为短按开机/短按关机请求；54V boost 与治疗启停联动；加热器/水泵协议→硬件联动 |
| V4.7 | 2026-07-13 | — | 电流控制从百分比改为直接mA值；Handle B通道改为CHIP_1 CH1 |
| V4.8 | 2026-07-14 | — | 温度控制指令(0x03)新增 PID 控温说明、温控互斥、安全保护参数 |
| V4.9 | 2026-07-14 | — | 新增温度周期上报指令（0x0B）和 PID 自整定指令（0x0C） |
| V4.10 | 2026-07-16 | — | 修正温度上报LEN字段(0x08)；修正PID自整定请求为4字节float；补充示例帧和完整行为描述 |
| V4.11 | 2026-07-18 | — | 泵控新增三段电压区间说明（死区/调速/满载），函数改为 dac7311_set_pump_speed() |
| V4.12 | 2026-07-21 | — | 电流控制从 mA 直传改为档位选择（0~10），内部查 g_current_level_map 获取实际电流 |
| V4.13 | 2026-07-21 | — | 电流控制从档位 0~10 改为档位 0~80（100μA 步进），单位改为 μA |
| V4.14 | 2026-07-23 | — | 温度控制从直接温度值改为百分比(0~100)，映射20~41°C；电流档位映射表线性化 |
| V4.15 | 2026-07-23 | — | 泵控DAC电压范围从0~5.0V改为0~3.5V，百分比线性映射 |
| V5.0 | 2026-07-31 | — | 微电流输出改为全局功能：电流控制(0x02)删除 handle_id 参数；手柄切换(0x01)保留电流/波形参数；手柄功能矩阵更新；电流档位范围从 0~80 改为 0~10（查表获取实际 μA）；NNC6521 仅使用 CHIP_2 CH0 作为全局微电流输出；54V boost 使用 LGS6302EP-2 (PB1) 作为全局电流供电 |

---

## 二、协议概览

### 2.1 通信接口总览

| 接口 | 物理层 | 波特率/速率 | 协议类型 | 对端设备 | 用途 |
|---|---|---|---|---|---|
| UART1 | TTL | 9600bps / 8N1 | 自定义帧 | Android APP | 设备控制与状态查询 |
| UART2 | TTL | 115200bps / 8N1 | — | — | Debug 调试日志 |

### 2.2 物理接口参数

| 参数 | 值 | 备注 |
|---|-----|---|
| 电平标准 | TTL 3.3V | — |
| 波特率 | 9600 bps（UART1） / 115200 bps（UART2） | — |
| 数据位 | 8 | — |
| 停止位 | 1 | — |
| 校验位 | None | — |
| DMA | 预留 | 初期中断模式，后续可切换 DMA |

---

## 三、帧格式定义

### 3.1 主协议帧格式

```
55 AA [len] [addrH] [addrL] [type] [state] [func] [para1] ... [paraN] [crcH] [crcL]
```

| 字段 | 字节数 | 值/范围 | 说明 |
|---|---|---|---|
| 帧头 | 2 | `FRAME_HEAD1`(0x55) `FRAME_HEAD2`(0xAA) | 固定标识 |
| 长度 (len) | 1 | 0x05~0xFF | addrH ~ paraN 的总字节数，len = 4 + 参数数量 + 2（地址） |
| 设备地址高字节 (addrH) | 1 | `DEVICE_ID_H`(0x60) | 设备固定地址高字节 |
| 设备地址低字节 (addrL) | 1 | `DEVICE_ID_L`(0x66) | 设备固定地址低字节 |
| 类型 (type) | 1 | `FRAME_TYPE_ACT`(0x44)=动作命令, `FRAME_TYPE_GET`(0x45)=参数获取 | 命令分类 |
| 状态 (state) | 1 | `FRAME_STATE_ACK`(0x01)=设备应答, `FRAME_STATE_ASK`(0x02)=上位机请求 | 通信方向标识 |
| 功能码 (func) | 1 | `0x01`~`0x0C` | 具体功能编号 |
| 参数 (para) | 0~N | 可变 | 功能相关参数，按需定义 |
| 校验 (crcH/crcL) | 2 | CRC16-MODBUS | 校验范围：len ~ paraN 共 (len+1) 字节，**高字节在前** |

### 3.2 设备固件宏定义

```c
/* 主板设备码以及版本号 */
#define DEVICE_ID_H     0x60
#define DEVICE_ID_L     0x66
#define DEVICE_VERSION  0x01
```

### 3.3 帧参数宏定义

```c
#define FRAME_HEAD1     0x55    // Frame header 1
#define FRAME_HEAD2     0xAA    // Frame header 2
#define FRAME_TYPE_ACT  0x44    // Frame type: action command
#define FRAME_TYPE_GET  0x45    // Frame type: parameter get
#define FRAME_STATE_ASK 0x02    // Frame state: host request
#define FRAME_STATE_ACK 0x01    // Frame state: device response
```

### 3.4 CRC 校验规则

| 项目 | 值 |
|---|-----|
| 算法 | CRC16-MODBUS |
| 多项式 | 0x8005 |
| 初始值 | 0xFFFF |
| 输入反转 | True（RefIn） |
| 输出反转 | True（RefOut） |
| 异或值 | 0x0000 |
| 计算范围 | len ~ paraN（不含帧头 55 AA 和 CRC 本身），共 (len+1) 字节 |
| 字节序 | **高字节在前，低字节在后**（Big-Endian） |
| 示例 | 计算结果 `0x0F48` → 帧中排列 `0F 48` |
| 固件版本 | `DEVICE_VERSION = 0x01`（V1.0） |

### 3.5 len 字段计算规则

```
len = addrH(1) + addrL(1) + type(1) + state(1) + func(1) + 参数数量
len = 5 + 参数数量

示例：
- 无参数指令（读版本号）：len = 5 + 0 = 0x05
- 单参数指令（温度调节）：len = 5 + 1 = 0x06
- 双参数指令（版本号应答）：len = 5 + 2 = 0x07
```

---

## 四、手柄系统说明

### 4.1 手柄功能矩阵

| 手柄 | 编号码 | 微电流输出 | 加热功能 | 气泵控制 | 说明 |
|---|---|---|---|---|---|
| A | `0x0A` | ❌ | ✅ | ❌ | 仅加热功能 |
| B | `0x0B` | ❌ | ✅ | ❌ | 仅加热功能 |
| C | `0x0C` | ❌ | ❌ | ✅ | 仅气泵功能 |
| — | — | ✅（全局） | — | — | 微电流输出，上电即存在，所有界面可调 |

### 4.2 手柄切换行为

- **默认状态**：上电后处于手柄 A 界面
- **切换时清零**：切换手柄时，**当前活动手柄和目标手柄**的参数（温度、泵速）清零复位
- **保留全局参数**：电流值、波形参数**不清零**（全局状态）
- **停止输出**：切换时立即停止当前波形输出（调用 `nnc6521_awg_enable_disable(0)`）
- **互斥机制**：A/B/C 同一时刻只有一个手柄处于活动状态，加热/泵参数互斥
- **独立调节**：每个手柄页面只可调节自己的加热/泵参数，电流参数全局可调

### 4.2.1 NNC6521 硬件映射

- 仅使用 NNC6521-2 (CHIP_2) 的 CH0 通道作为**全局微电流输出**
- 不与任何手柄绑定
- 上电即初始化，随时可用

### 4.2.2 54V Boost 映射

- 使用 LGS6302EP-2 (PB1) 通道
- 原为手柄 C 的 54V 供电，现改为全局电流输出供电
- 电流输出时自动使能，停止时自动关闭

### 4.3 参数范围总览

| 参数 | 范围 | 单位 | 适用范围 | 说明 |
|---|---|---|---|---|
| 电流档位 | 0~10 | 档位 | 全局 | 0=关闭，1~10=档位（查表获取 μA） |
| 温度 | 0~100 | %（映射20~41℃） | A, B | 0=关闭加热，1~100=百分比，线性映射到 20~41℃ |
| 气泵转速 | 0~100 | % | C | 0=关闭，1~100=转速百分比 |
| 波形编号 | 1~9 | — | 全局 | 切换治疗波形 |

---

## 五、功能码定义

### 5.1 动作命令（type=FRAME_TYPE_ACT=0x44）

| 功能码 | 名称 | 参数定义 | 适用范围 | 说明 |
|---|---|---|---|---|
| `0x01` | 手柄切换 | para[0]=手柄编号(0x0A/0x0B/0x0C) | A, B, C | 切换当前工作手柄 |
| `0x02` | 电流控制 | para[0]=档位(0~10) | 全局 | 调节微电流输出强度，无手柄参数 |
| `0x03` | 温度调节 | para[0]=温度百分比(0~100), para[1]=手柄编号(0x0A/0x0B) | A, B | 0=关闭加热, 1~100=百分比映射到20~41℃ |
| `0x04` | 气泵转速调节 | para[0]=转速等级(0~100) | C | 调节气泵转速 |
| `0x05` | 开始/暂停 | para[0]=动作(0=暂停, 1=开始) | 全局 | 控制治疗流程启停 |
| `0x06` | 远程升级 | para[0]=0(开始升级) | 全局 | OTA 固件升级控制 |
| `0x07` | 老化模式 | para[0]=动作(0=退出, 1=进入) | 全局 | 工厂老化测试模式 |
| `0x08` | 读取版本号 | 无参数 | 全局 | 查询固件版本 |
| `0x09` | 波形切换 | para[0]=波形编号(1~9) | 全局 | 切换治疗波形 |
| `0x0A` | 关机请求/确认 | para[0]=0x00(请求)/0x01(确认)/0x00(拒绝) | 全局 | 设备发关机请求，上位机确认或拒绝 |

### 5.2 电流档位定义

电流控制采用 0~10 档位，固件通过 `g_current_level_map` 查表获取实际 μA 值。

| 档位 | 电流值 | 说明 |
|---|---|---|
| 0 | 0μA | 关闭输出 |
| 1 | 根据波形查表 | 最小电流 |
| 2 | 根据波形查表 | — |
| 3 | 根据波形查表 | — |
| 4 | 根据波形查表 | — |
| 5 | 根据波形查表 | 中间值 |
| 6 | 根据波形查表 | — |
| 7 | 根据波形查表 | — |
| 8 | 根据波形查表 | — |
| 9 | 根据波形查表 | — |
| 10 | 根据波形查表 | 最大电流 |

不同波形的档位映射曲线不同，通过 `g_current_level_map[waveform_id-1][level]` 查表获取实际 μA 值。

---

## 六、指令详细定义（含已验证 CRC）

> 以下所有完整帧的 CRC 均已通过 CRC16-MODBUS 算法验证，可直接用于开发测试。
> 设备地址：`0x60 0x66`（`DEVICE_ID_H`=0x60, `DEVICE_ID_L`=0x66）

### 6.1 手柄切换（func=0x01）

**方向**: APP → 设备

**参数定义**:

| 参数 | 偏移 | 长度 | 类型 | 范围 | 说明 |
|---|---|---|---|---|---|
| para[0] | 0 | 1 byte | uint8 | 0x0A/0x0B/0x0C | 手柄编号（A=0x0A, B=0x0B, C=0x0C） |

**请求帧（APP→设备, state=FRAME_STATE_ASK, len=0x06）**:

| 操作 | 完整帧（含 CRC） |
|---|---|
| 切换至手柄 A | `55 AA 06 60 66 44 02 01 0A 0F 48` |
| 切换至手柄 B | `55 AA 06 60 66 44 02 01 0B CF 89` |
| 切换至手柄 C | `55 AA 06 60 66 44 02 01 0C 0D C8` |

**应答帧（设备→APP, state=FRAME_STATE_ACK, len=0x06）**:

| 操作 | 完整帧（含 CRC） |
|---|---|
| 手柄 A 切换成功 | `55 AA 06 60 66 44 01 01 0A 0F B8` |
| 手柄 B 切换成功 | `55 AA 06 60 66 44 01 01 0B CF 79` |
| 手柄 C 切换成功 | `55 AA 06 60 66 44 01 01 0C 0D 38` |

**说明**:
- 切换手柄后立即停止当前波形输出（NNC6521 AWG 禁用）
- 切换时**当前活动手柄和目标手柄**的温度、泵速清零复位，电流值和波形参数**保留不清零**（全局状态）
- 若手柄编号无效（非 0x0A/0x0B/0x0C），设备返回参数错误应答

---

### 6.2 电流控制（func=0x02）

**方向**: APP → 设备

**适用范围**: 全局（无手柄绑定）

**参数定义**:

| 参数 | 偏移 | 长度 | 类型 | 范围 | 说明 |
|---|---|---|---|---|---|
| para[0] | 0 | 1 byte | uint8 | 0~10 | 电流档位（0=关闭, 1~10=输出档位，内部查表获取实际 μA） |

**档位-电流映射说明**:

电流输出通过档位选择（0~10），固件内部通过 `g_current_level_map[waveform_id-1][level]` 查表获取实际 μA 值。不同波形的档位映射曲线不同，档位 10 对应波形最大电流。

| 档位 | 说明 |
|---|---|
| 0 | 关闭电流输出 |
| 1~10 | 选择电流档位，固件查表获取实际 μA 值 |

**波形1（劲感律动）档位映射示例（线性）**:

| 档位 | 0 | 1 | 2 | 3 | 4 | 5 | 6 | 7 | 8 | 9 | 10 |
|---|---|---|---|---|---|---|---|---|---|---|----|
| 实际电流(μA) | 0 | 根据波形查表 | 根据波形查表 | 根据波形查表 | 根据波形查表 | 根据波形查表 | 根据波形查表 | 根据波形查表 | 根据波形查表 | 根据波形查表 | 根据波形查表 |

**示例**：
- 波形「劲感律动」，传入档位 5 → 查表得中间电流值
- 传入档位 10 → 查表得波形最大电流
- 传入档位 0 → 关闭输出
- 传入档位 11 → 返回参数错误应答

**请求帧（APP→设备, state=FRAME_STATE_ASK, len=0x06）**:

| 操作 | 完整帧（含 CRC） |
|---|---|
| 档位0 | `55 AA 06 60 66 44 02 02 00 F8 C8` |
| 档位1 | `55 AA 06 60 66 44 02 02 01 F9 08` |
| 档位2 | `55 AA 06 60 66 44 02 02 02 FB 08` |
| 档位3 | `55 AA 06 60 66 44 02 02 03 FA C8` |
| 档位4 | `55 AA 06 60 66 44 02 02 04 FE 08` |
| 档位5 | `55 AA 06 60 66 44 02 02 05 FF C8` |
| 档位6 | `55 AA 06 60 66 44 02 02 06 FD 08` |
| 档位7 | `55 AA 06 60 66 44 02 02 07 FC C8` |
| 档位8 | `55 AA 06 60 66 44 02 02 08 F4 08` |
| 档位9 | `55 AA 06 60 66 44 02 02 09 F5 C8` |
| 档位10 | `55 AA 06 60 66 44 02 02 0A FF 48` |

**应答帧（设备→APP, state=FRAME_STATE_ACK, len=0x06）**:

| 操作 | 完整帧（含 CRC） |
|---|---|
| 档位0 应答 | `55 AA 06 60 66 44 01 02 00 F9 08` |
| 档位1 应答 | `55 AA 06 60 66 44 01 02 01 F8 C8` |
| 档位2 应答 | `55 AA 06 60 66 44 01 02 02 FA C8` |
| 档位3 应答 | `55 AA 06 60 66 44 01 02 03 FB 08` |
| 档位4 应答 | `55 AA 06 60 66 44 01 02 04 FF C8` |
| 档位5 应答 | `55 AA 06 60 66 44 01 02 05 FE 08` |
| 档位6 应答 | `55 AA 06 60 66 44 01 02 06 FC C8` |
| 档位7 应答 | `55 AA 06 60 66 44 01 02 07 FD 08` |
| 档位8 应答 | `55 AA 06 60 66 44 01 02 08 F5 C8` |
| 档位9 应答 | `55 AA 06 60 66 44 01 02 09 F4 08` |
| 档位10 应答 | `55 AA 06 60 66 44 01 02 0A FE 88` |

**说明**:
- 电流控制为**全局功能**，无手柄绑定
- 切换手柄时电流参数保留不清零
- 在 A/B/C 任意界面均可调节电流
- 传入档位值（0~10），固件通过 `g_current_level_map` 查表获取实际 μA 值
- 不同波形的档位映射曲线不同（参见波形定义表）
- 档位超出范围（>10）返回参数错误应答
- 档位值在治疗暂停时保持设定值，重新开始后生效
- ACK 应答返回档位值（非 μA 值），上位机如需显示 μA 值需自行查表

---

### 6.3 温度调节（func=0x03）

**方向**: APP → 设备

**适用手柄**: A, B（手柄 C 无加热功能）

**参数定义**:

| 参数 | 偏移 | 长度 | 类型 | 范围 | 说明 |
|---|---|---|---|---|---|
| para[0] | 0 | 1 byte | uint8 | 0~100 | 温度百分比（0=关闭加热, 1~100=百分比，映射到 20~41℃） |
| para[1] | 1 | 1 byte | uint8 | 0x0A/0x0B | 目标手柄编号（A=0x0A, B=0x0B） |

**温度百分比映射**:

| 温度(℃) | 百分比值 | para[0] | 说明 |
|---|---|---|---|
| — | 0% | 0x00 | 关闭加热（PID disable） |
| 20.0 | 1% | 0x01 | 最低目标温度 |
| 25.1 | 25% | 0x19 | — |
| 30.4 | 50% | 0x32 | — |
| 37.0 | 81% | 0x51 | 常用温度 |
| 36.8 | 80% | 0x50 | — |
| 41.0 | 100% | 0x64 | 最高目标温度 |

映射公式：`temp = 20.0 + (percent - 1) × 21.0 / 99.0`
反算公式：`percent = round((temp - 20) / 21.0 × 99 + 1)`

**请求帧（APP→设备, state=FRAME_STATE_ASK, len=0x07）**:

| 操作 | 完整帧（含 CRC） |
|---|---|
| 关闭加热, 手柄 A | `55 AA 07 60 66 44 02 03 00 0A 9D E9` |
| 关闭加热, 手柄 B | `55 AA 07 60 66 44 02 03 00 0B 5D 28` |
| 20℃ (1%), 手柄 A | `55 AA 07 60 66 44 02 03 01 0A 0D E8` |
| 20℃ (1%), 手柄 B | `55 AA 07 60 66 44 02 03 01 0B CD 29` |
| 25%百分比, 手柄 A | `55 AA 07 60 66 44 02 03 19 0A 0D E2` |
| 25%百分比, 手柄 B | `55 AA 07 60 66 44 02 03 19 0B CD 23` |
| 37℃ (81%), 手柄 A | `55 AA 07 60 66 44 02 03 51 0A 0D D4` |
| 37℃ (81%), 手柄 B | `55 AA 07 60 66 44 02 03 51 0B CD 15` |
| 50%百分比, 手柄 A | `55 AA 07 60 66 44 02 03 32 0A FD FC` |
| 50%百分比, 手柄 B | `55 AA 07 60 66 44 02 03 32 0B 3D 3D` |
| 80%百分比, 手柄 A | `55 AA 07 60 66 44 02 03 50 0A 9D D5` |
| 80%百分比, 手柄 B | `55 AA 07 60 66 44 02 03 50 0B 5D 14` |
| 41℃ (100%), 手柄 A | `55 AA 07 60 66 44 02 03 64 0A 5D C3` |
| 41℃ (100%), 手柄 B | `55 AA 07 60 66 44 02 03 64 0B 9D 02` |

**应答帧（设备→APP, state=FRAME_STATE_ACK, len=0x07）**:

| 操作 | 完整帧（含 CRC） |
|---|---|
| 关闭加热, 手柄 A | `55 AA 07 60 66 44 01 03 00 0A D9 E9` |
| 关闭加热, 手柄 B | `55 AA 07 60 66 44 01 03 00 0B 19 28` |
| 37℃ (81%), 手柄 A | `55 AA 07 60 66 44 01 03 51 0A 49 D4` |
| 37℃ (81%), 手柄 B | `55 AA 07 60 66 44 01 03 51 0B 89 15` |
| 41℃ (100%), 手柄 A | `55 AA 07 60 66 44 01 03 64 0A 19 C3` |
| 41℃ (100%), 手柄 B | `55 AA 07 60 66 44 01 03 64 0B D9 02` |

**说明**:
- 温度百分比：`0` = 关闭加热（PID disable），`1~100` = 百分比值，固件内部线性映射到 20~41°C
- 映射公式：`temp = 20.0 + (percent - 1) × 21.0 / 99.0`
- 手柄 ID：`0x0A` = A 手柄（小手柄加热），`0x0B` = B 手柄（大手柄加热），`0x0C` = C 手柄（不支持，返回错误）
- **温控互斥**：设置一个手柄的温度会自动关闭另一个手柄的加热
- **控温方式**：PID 自动调节（Kp=8.0, Ki=0.15, Kd=3.0），软件 PWM 占空比输出
- **安全保护**：过热 45°C 关断、传感器故障检测、死区 0.3°C
- 设备内部有独立温控保护，实际温度不会超过安全阈值
- 设为 0 时仅关闭加热，不关闭温度监测
- 手柄 C 不支持加热功能，发送温度指令无效

---

### 6.4 气泵转速调节（func=0x04）

**方向**: APP → 设备

**适用手柄**: C（手柄 A/B 无气泵功能）

**参数定义**:

| 参数 | 偏移 | 长度 | 类型 | 范围 | 说明 |
|---|---|---|---|---|---|
| para[0] | 0 | 1 byte | uint8 | 0~100 | 转速等级（0=关闭, 1~100=转速百分比） |

**请求帧（APP→设备, state=FRAME_STATE_ASK, len=0x06）**:

| 操作 | 完整帧（含 CRC） |
|---|---|
| 关闭气泵 | `55 AA 06 60 66 44 02 04 00 58 CB` |
| 转速 50% | `55 AA 06 60 66 44 02 04 32 8D 4A` |
| 转速 100% | `55 AA 06 60 66 44 02 04 64 B3 CA` |

**应答帧（设备→APP, state=FRAME_STATE_ACK, len=0x06）**:

| 操作 | 完整帧（含 CRC） |
|---|---|
| 设置成功（50%） | `55 AA 06 60 66 44 01 04 32 8D BA` |

**说明**:
- 气泵仅在手柄 C 下有效
- 手柄 A/B 下发送气泵指令无效
- 治疗暂停时气泵保持当前状态，需显式关闭
- **泵控电压映射**:
  - 0% → 0.0V（关泵）
  - 1%~100% → 0.0V~3.5V（线性映射）
- **泵特性**: 0~0.7V 死区不转，0.7~3.5V 调速

---

### 6.5 开始/暂停（func=0x05）

**方向**: APP → 设备

**参数定义**:

| 参数 | 偏移 | 长度 | 类型 | 范围 | 说明 |
|---|---|---|---|---|---|
| para[0] | 0 | 1 byte | uint8 | 0~1 | 0=暂停, 1=开始 |

**请求帧（APP→设备, state=FRAME_STATE_ASK, len=0x06）**:

| 操作 | 完整帧（含 CRC） |
|---|---|
| 开始治疗 | `55 AA 06 60 66 44 02 05 01 08 0B` |
| 暂停治疗 | `55 AA 06 60 66 44 02 05 00 C8 CA` |

**应答帧（设备→APP, state=FRAME_STATE_ACK, len=0x06）**:

| 操作 | 完整帧（含 CRC） |
|---|---|
| 开始成功 | `55 AA 06 60 66 44 01 05 01 08 FB` |
| 暂停成功 | `55 AA 06 60 66 44 01 05 00 C8 3A` |

**说明**:
- 开始治疗前需确保手柄已切换、能量/温度/气泵参数已设定
- 暂停时微电流输出立即停止，加热和气泵保持当前状态
- 重复发送相同指令不影响当前状态（幂等操作）

---

### 6.6 远程升级（func=0x06）

**方向**: APP → 设备

**参数定义**:

| 参数 | 偏移 | 长度 | 类型 | 范围 | 说明 |
|---|---|---|---|---|---|
| para[0] | 0 | 1 byte | uint8 | 0 | 0=开始升级 |

**请求帧（APP→设备, state=FRAME_STATE_ASK, len=0x06）**:

| 操作 | 完整帧（含 CRC） |
|---|---|
| 开始升级 | `55 AA 06 60 66 44 02 06 00 38 CA` |

**应答帧（设备→APP, state=FRAME_STATE_ACK, len=0x06）**:

| 操作 | 完整帧（含 CRC） |
|---|---|
| 应答成功 | `55 AA 06 60 66 44 01 06 00 38 3A` |

**说明**:
- APP 发送「开始升级」→ 设备进入升级模式 → APP 传输固件数据 → 设备校验并写入 Flash → 设备自动重启
- 治疗进行中不允许升级，设备返回错误应答
- 升级过程中设备暂停所有治疗输出
- 固件数据传输通道和格式另行定义（预留扩展）

---

### 6.7 老化模式（func=0x07）

**方向**: APP → 设备

**参数定义**:

| 参数 | 偏移 | 长度 | 类型 | 范围 | 说明 |
|---|---|---|---|---|---|
| para[0] | 0 | 1 byte | uint8 | 0~1 | 0=退出老化, 1=进入老化 |

**请求帧（APP→设备, state=FRAME_STATE_ASK, len=0x06）**:

| 操作 | 完整帧（含 CRC） |
|---|---|
| 进入老化模式 | `55 AA 06 60 66 44 02 07 01 68 0A` |
| 退出老化模式 | `55 AA 06 60 66 44 02 07 00 A8 CB` |

**应答帧（设备→APP, state=FRAME_STATE_ACK, len=0x06）**:

| 操作 | 完整帧（含 CRC） |
|---|---|
| 应答成功 | `55 AA 06 60 66 44 01 07 01 68 FA` |

**说明**:
- 老化模式用于工厂产线长时间稳定性测试
- 进入老化模式后设备自动循环执行预设测试流程
- 老化模式下忽略普通治疗指令（开始/暂停、能量调节等）
- 退出老化模式后设备恢复初始空闲状态

---

### 6.8 读取版本号（func=0x08）

**方向**: APP → 设备

**参数定义**: 无参数

**请求帧（APP→设备, state=FRAME_STATE_ASK, len=0x05）**:

| 操作 | 完整帧（含 CRC） |
|---|---|
| 读取版本号 | `55 AA 05 60 66 44 02 08 7D DE` |

**应答帧（设备→APP, state=FRAME_STATE_ACK, len=0x07）**:

| 操作 | 完整帧（含 CRC） |
|---|---|
| 版本号应答（V1.0） | `55 AA 07 60 66 44 01 08 01 00 8C 19` |

**说明**:
- 应答帧中 para[0]=主版本号, para[1]=次版本号
- V1.0 → `55 AA 07 60 66 44 01 08 01 00 8C 19`（`DEVICE_VERSION`=0x01）
- 该指令无条件响应，任何状态下均可执行

---

### 6.9 波形切换（func=0x09）

**方向**: APP → 设备

**参数定义**:

| 参数 | 偏移 | 长度 | 类型 | 范围 | 说明 |
|---|---|---|---|---|---|
| para[0] | 0 | 1 byte | uint8 | 1~9 | 波形编号（见下表） |

**波形定义**:

| 编号 | 波形名称 | 波形类型 | 电流范围 | 频率 | 脉宽 |
|---|---|---|---|---|---|
| 1 | 劲感律动 | 对称双相方波 | 0~10 档位 | 50 Hz | 300 μs |
| 2 | 活力律动 | 对称双相方波 | 0~10 档位 | 50 Hz (Burst 10 Hz) | 300 μs |
| 3 | 轻柔律动 | 对称双相方波 | 0~10 档位 | 35 Hz | 300 μs |
| 4 | 深润柔护 | 4 kHz 平衡方波 | 0~10 档位 | 40~50 Hz (低频调制) | — |
| 5 | 包裹柔护 | 2~4 kHz 正弦波 | 0~10 档位 | 30~40 Hz | — |
| 6 | 脉动柔护 | 4 kHz 平衡正弦波 | 0~10 档位 | 2~10 Hz (低频调制) | — |
| 7 | 平顺舒缓 | 平衡三角波 | 0~10 档位 | 80~100 Hz | 400 μs |
| 8 | 胀感舒缓 | 低频正弦波 | 0~10 档位 | 5 Hz | 450 μs |
| 9 | 静谧收尾 | 低频正弦波 | 0~10 档位 | 10 Hz | — |

**请求帧（APP→设备, state=FRAME_STATE_ASK, len=0x06）**:

| 操作 | 完整帧（含 CRC） |
|---|---|
| 1-劲感律动 | `55 AA 06 60 66 44 02 09 01 08 0E` |
| 2-活力律动 | `55 AA 06 60 66 44 02 09 02 09 4E` |
| 3-轻柔律动 | `55 AA 06 60 66 44 02 09 03 C9 8F` |
| 4-深润柔护 | `55 AA 06 60 66 44 02 09 04 0B CE` |
| 5-包裹柔护 | `55 AA 06 60 66 44 02 09 05 CB 0F` |
| 6-脉动柔护 | `55 AA 06 60 66 44 02 09 06 CA 4F` |
| 7-平顺舒缓 | `55 AA 06 60 66 44 02 09 07 0A 8E` |
| 8-胀感舒缓 | `55 AA 06 60 66 44 02 09 08 0E CE` |
| 9-静谧收尾 | `55 AA 06 60 66 44 02 09 09 CE 0F` |

**应答帧（设备→APP, state=FRAME_STATE_ACK, len=0x06）**:

| 操作 | 完整帧（含 CRC） |
|---|---|
| 1-劲感律动成功 | `55 AA 06 60 66 44 01 09 01 08 FE` |
| 2-活力律动成功 | `55 AA 06 60 66 44 01 09 02 09 BE` |
| 3-轻柔律动成功 | `55 AA 06 60 66 44 01 09 03 C9 7F` |
| 4-深润柔护成功 | `55 AA 06 60 66 44 01 09 04 0B 3E` |
| 5-包裹柔护成功 | `55 AA 06 60 66 44 01 09 05 CB FF` |
| 6-脉动柔护成功 | `55 AA 06 60 66 44 01 09 06 CA BF` |
| 7-平顺舒缓成功 | `55 AA 06 60 66 44 01 09 07 0A 7E` |
| 8-胀感舒缓成功 | `55 AA 06 60 66 44 01 09 08 0E 3E` |
| 9-静谧收尾成功 | `55 AA 06 60 66 44 01 09 09 CE FF` |

**说明**:
- 切换波形后设备自动停止当前输出状态
- 各波形的电流范围不同（见上表），电流调节(0x02)传入档位(0~10)，固件通过查表获取实际 μA 值，clamp 到当前波形的电流范围
- 例如：波形设为「劲感律动」(0~10 档位)，传入档位 5 → 查表得实际电流值
- 切换波形后电流档位保持上次设定值
- 默认上电波形为 1-劲感律动

---

### 6.10 关机请求/确认（func=0x0A）

**方向**: 双向（设备→上位机请求，上位机→设备确认/拒绝）

#### 设备→上位机：关机请求

设备发送关机请求帧，para[0]=0x00：

| 操作 | 完整帧（含 CRC） |
|---|---|
| 关机请求 | `55 AA 06 60 66 44 01 0A 00 38 3F` |

#### 上位机→设备：关机确认

上位机回复确认帧，para[0]=0x01（确认关机）或 0x00（拒绝关机）：

| 操作 | 完整帧（含 CRC） |
|---|---|
| 确认关机 | `55 AA 06 60 66 44 02 0A 01 F8 0E` |
| 拒绝关机 | `55 AA 06 60 66 44 02 0A 00 38 CF` |

**说明**:
- 设备在 POWER_ON 状态下短按电源按钮，发送关机请求给上位机
- 上位机收到后弹窗让用户选择是否关机
- 选择"是"：上位机发送确认帧(para[0]=0x01)，设备执行完整关机序列
- 选择"否"：上位机发送拒绝帧(para[0]=0x00)，设备回到 ON 状态，不关机
- 超时 10s 未收到回复：设备自动回到 ON 状态，不关机
- 设备开机不需要请求，短按直接开机

---

### 6.11 温度周期上报（func=0x0B）

**方向**: 设备→上位机（主动上报，无需上位机请求）

**帧格式**:

| 字段 | 偏移 | 长度 | 值 | 说明 |
|---|---|---|-----|---|
| HEAD | 0 | 2B | 55 AA | 帧头 |
| LEN | 2 | 1B | 0x08 | 长度（=5+param_len=5+3） |
| ADDR | 3 | 2B | 60 66 | 设备地址 |
| TYPE | 5 | 1B | 0x01 | 设备应答 |
| STATE | 6 | 1B | 0x01 | ACK |
| FUNC | 7 | 1B | 0x0B | 温度上报 |
| handle_id | 8 | 1B | 0x0A/0x0B | 当前活动手柄 ID |
| temp_high | 9 | 1B | — | 温度高字节（temp×10 的 int16 大端序） |
| temp_low | 10 | 1B | — | 温度低字节 |
| CRC16 | 11 | 2B | — | CRC16-MODBUS |

**总帧长**: 13 字节

**温度编码**: `temp_encoded = (int16_t)(temperature × 10)`，大端序拆分为 2 字节
- 示例：37.5°C → 375 → 0x0177 → temp_high=0x01, temp_low=0x77
- 范围：-3276.8°C ~ +3276.7°C

**示例帧**（Handle A, 36.2°C）:
```
55 AA 08 60 66 01 01 0B 0A 01 6A [CRC_H] [CRC_L]
```
- handle_id=0x0A, temp_encoded=362→0x016A, temp_high=0x01, temp_low=0x6A

**行为**:
1. 治疗开始（`is_running=1`）时启动 2 秒周期定时器
2. 治疗暂停、切换手柄、关机时停止定时器
3. 仅在 `is_running=1` 时上报
4. NTC 映射：Handle A → NTC_CH_SMALL (PC1)，Handle B → NTC_CH_LARGE (PC0)
5. Handle C 无温度传感器，不上报
6. 定时器回调中读取当前手柄的 NTC 温度，通过 `protocol_send_ack(FUNC_TEMP_REPORT, params, 3)` 发送

---

### 6.12 PID 参数自整定（func=0x0C）

**方向**: 双向（上位机→设备请求，设备→上位机应答）

#### 请求帧（上位机→设备）

| 字段 | 偏移 | 长度 | 说明 |
|---|---|---|---|
| HEAD | 0 | 2B | 55 AA |
| LEN | 2 | 1B | 0x09（=5+4） |
| ADDR | 3 | 2B | 60 66 |
| TYPE | 5 | 1B | 0x02（请求） |
| STATE | 6 | 1B | 0x09（ASK） |
| FUNC | 7 | 1B | 0x0C |
| target_temp | 8 | 4B | 目标温度（IEEE 754 float，大端序） |
| CRC16 | 12 | 2B | CRC16-MODBUS |

**总帧长**: 14 字节

**target_temp 编码**: IEEE 754 单精度浮点数，大端序（高位在前）
- 示例：41.0°C → float 0x42240000 → para[0]=0x42, para[1]=0x24, para[2]=0x00, para[3]=0x00

**请求示例帧**（目标温度 41.0°C）:
```
55 AA 09 60 66 02 09 0C 42 24 00 00 [CRC_H] [CRC_L]
```

#### 应答帧（设备→上位机）

应答帧 LEN = 0x0C（=5+7），总帧长 14 字节。

**status 枚举值**:

| 值 | 含义 |
|-----|---|
| 0x00 | 自整定已启动 |
| 0x01 | 自整定完成 |
| 0x02 | 自整定失败 |

**启动应答**（status=0x00，Kp/Ki/Kd 全为 0）:
```
55 AA 0C 60 66 01 01 0C 00 00 00 00 00 00 [CRC_H] [CRC_L]
```

**完成应答**（status=0x01，携带 Kp/Ki/Kd）:

| 字段 | 偏移 | 长度 | 说明 |
|---|---|---|---|
| status | 8 | 1B | 0x01 |
| kp_high | 9 | 1B | Kp 高字节（int16×100 大端序） |
| kp_low | 10 | 1B | Kp 低字节 |
| ki_high | 11 | 1B | Ki 高字节 |
| ki_low | 12 | 1B | Ki 低字节 |
| kd_high | 13 | 1B | Kd 高字节 |
| kd_low | 14 | 1B | Kd 低字节 |

- 示例：Kp=12.34 → int16(12.34×100)=1234→0x04D2 → kp_high=0x04, kp_low=0xD2

**错误应答**（status=0x02，params 全为 0）:
```
55 AA 0C 60 66 01 01 0C 02 00 00 00 00 00 [CRC_H] [CRC_L]
```

**算法原理**:
1. 继电反馈法（Relay Feedback）：bang-bang 控制产生等幅振荡
2. 滞回区间：target ± 2°C（`TEMP_PID_AUTOTUNE_HYSTERESIS`）
3. 加热器 ON → 温度升至 target+2°C → 关闭
4. 加热器 OFF → 温度降至 target-2°C → 开启
5. 重复 6 个完整周期（`TEMP_PID_AUTOTUNE_CYCLES`）
6. 测量平均振荡周期 Tu 和平均幅度 Au
7. Ziegler-Nichols 公式计算：
   - Ku = 4×d / (π×a)，其中 d=100（满幅输出），a=Au/2（半幅度）
   - Kp = 0.6 × Ku
   - Ki = 2 × Kp / Tu（每秒积分增益）× 控制周期(0.1s)
   - Kd = Kp × Tu / 8
8. 计算完成后自动应用到当前手柄的 PID 参数

**安全保护**:
- 过热 45°C（`TEMP_OVERHEAT_CELSIUS`）强制中止
- 超时 20 分钟（`TEMP_PID_AUTOTUNE_TIMEOUT`）自动中止
- 传感器故障（超出有效范围）自动中止
- 自整定过程中 PID 安全检查仍然生效
- 自整定期间停止正常的 PID 控制，加热器由 bang-bang 直接控制

**触发条件**:
- 自整定需手动触发（上位机发送 func=0x0C 请求），不会自动运行
- 自整定针对当前活跃手柄对应的 PID 实例（Handle A→PID[1], Handle B→PID[0]）

**行为**:
1. 收到命令后启动自整定流程
2. 自整定期间 PID 切换为 bang-bang 控制模式
3. 完成后自动应用新的 PID 参数
4. 通过协议通知上位机结果

---

## 七、应答机制

### 7.1 成功应答

| 场景 | state 字段 | 帧结构变化 |
|---|---|---|
| 请求（APP→设备） | `FRAME_STATE_ASK`(0x02) | APP 发送，保持原始功能码和参数 |
| 应答（设备→APP） | `FRAME_STATE_ACK`(0x01) | 设备回复，state 改为 0x01，其余字段回传 |

### 7.2 错误应答

| 错误码 | 含义 | 说明 |
|---|---|---|
| `0x00` | 成功 | 操作正常完成 |
| `0x01` | 参数错误 | 参数越界或格式不合法 |
| `0x02` | 不支持的功能码 | func 未实现 |
| `0x03` | 设备忙 | 当前状态不允许执行（如治疗中不允许升级） |
| `0xFF` | 未知错误 | 系统异常 |

> 错误应答帧格式（扩展定义，待确认）：
> `55 AA 07 60 66 44 01 [func] [errorCode] [crcH] [crcL]`

---

## 八、通信时序

### 8.1 典型治疗流程

```
1. 上电初始化（默认手柄 A）
2. 读取版本号:       55 AA 05 60 66 44 02 08 7D DE           ← 确认设备在线
3. 切换波形:         55 AA 06 60 66 44 02 09 01 08 0E         ← 劲感律动
4. 设置温度:         55 AA 07 60 66 44 02 03 51 0A 0D D4     ← 温度37℃(81%), 手柄A
5. 开始治疗:         55 AA 06 60 66 44 02 05 01 08 0B         ← 启动治疗
6. 暂停治疗:         55 AA 06 60 66 44 02 05 00 C8 CA         ← 暂停

--- 切换到手柄 C ---
7. 切换手柄 C:       55 AA 06 60 66 44 02 01 0C 0D C8         ← 切换手柄
8. 设置气泵:         55 AA 06 60 66 44 02 04 32 8D 4A         ← 气泵50%
9. 切换波形:         55 AA 06 60 66 44 02 09 05 CB 0F         ← 包裹柔护
10. 开始治疗:        55 AA 06 60 66 44 02 05 01 08 0B         ← 启动

--- 切回手柄 A ---
11. 切换手柄 A:      55 AA 06 60 66 44 02 01 0A 0F 48         ← 切回A，电流/波形保留，温度需重新设定

--- 关机流程 ---
12. 短按电源按钮 → 设备发送 func=0x0A 关机请求
13. 上位机弹窗确认 → 用户选择"是" → 发送确认帧(para[0]=0x01)
14. 设备执行关机：停止波形 → 关闭加热 → 关闭气泵 → 关闭54V → 关闭12V → 蜂鸣 → LED灭
```

### 8.2 时序约束

| 约束项 | 值 | 说明 |
|---|-----|---|
| 请求-应答超时 | 500 ms | 超过此时间未应答视为通信失败 |
| 最小发送间隔 | 50 ms | 连续两帧之间的最小间隔 |
| 重发次数 | 3 次 | 超时后最大重发次数 |
| 设备初始化时间 | 1000 ms | 上电后需等待此时间才可通信 |

### 8.3 注意事项

- 所有动作命令（type=FRAME_TYPE_ACT）均遵循「请求→应答」模式，APP 发送请求后必须等待设备应答
- 读取版本号（func=0x08）是唯一无参数指令，len 固定为 0x05
- 远程升级（func=0x06）为预留功能，固件数据传输细节待后续定义
- UART2 仅供调试日志输出，不参与协议通信
- 手柄 A/B 支持加热，手柄 C 不支持加热（发温度指令无效）
- 手柄 C 支持气泵，手柄 A/B 不支持气泵（发气泵指令无效）

---

## 九、代码索引

| 文件路径 | 说明 |
|---|---|
| `applications/main.c` | 主循环与初始化入口 |
| `applications/macBSP/Src/protocol.c` | 协议帧解析、CRC、UART 收发 |
| `applications/macBSP/Src/protocol_act.c` | 命令分发、波形控制、硬件联动 |
| `applications/macBSP/Inc/protocol.h` | 协议常量、帧格式、功能码定义 |
| `applications/macTask/Src/power_task.c` | 电源状态机、开关机流程 |
| `applications/macBSP/Src/bsp_hard.c` | 硬件驱动（电源/boost/加热/水泵） |
| `applications/macBSP/Src/bsp_key.c` | 按键扫描与事件分发 |

---

## 附录 A：快速参考卡

### 常用指令速查（全部含已验证 CRC，设备地址 0x6066）

| 操作 | 完整帧 | 说明 |
|---|---|---|
| 读取版本号 | `55 AA 05 60 66 44 02 08 7D DE` | 无条件响应 |
| 切换手柄 A | `55 AA 06 60 66 44 02 01 0A 0F 48` | 默认手柄 |
| 切换手柄 B | `55 AA 06 60 66 44 02 01 0B CF 89` | 同 A 功能 |
| 切换手柄 C | `55 AA 06 60 66 44 02 01 0C 0D C8` | 仅气泵功能 |
| 温度关闭, 手柄 A | `55 AA 07 60 66 44 02 03 00 0A 9D E9` | 关闭加热 |
| 温度关闭, 手柄 B | `55 AA 07 60 66 44 02 03 00 0B 5D 28` | 关闭加热 |
| 20℃ (1%), 手柄 A | `55 AA 07 60 66 44 02 03 01 0A 0D E8` | 最低温度 |
| 20℃ (1%), 手柄 B | `55 AA 07 60 66 44 02 03 01 0B CD 29` | 最低温度 |
| 37℃ (81%), 手柄 A | `55 AA 07 60 66 44 02 03 51 0A 0D D4` | 常用 |
| 37℃ (81%), 手柄 B | `55 AA 07 60 66 44 02 03 51 0B CD 15` | 常用 |
| 50%百分比, 手柄 A | `55 AA 07 60 66 44 02 03 32 0A FD FC` | 约30.4℃ |
| 50%百分比, 手柄 B | `55 AA 07 60 66 44 02 03 32 0B 3D 3D` | 约30.4℃ |
| 80%百分比, 手柄 A | `55 AA 07 60 66 44 02 03 50 0A 9D D5` | 约36.8℃ |
| 80%百分比, 手柄 B | `55 AA 07 60 66 44 02 03 50 0B 5D 14` | 约36.8℃ |
| 41℃ (100%), 手柄 A | `55 AA 07 60 66 44 02 03 64 0A 5D C3` | 最大 |
| 41℃ (100%), 手柄 B | `55 AA 07 60 66 44 02 03 64 0B 9D 02` | 最大 |
| 气泵关闭 | `55 AA 06 60 66 44 02 04 00 58 CB` | — |
| 气泵 50% | `55 AA 06 60 66 44 02 04 32 8D 4A` | — |
| 气泵 100% | `55 AA 06 60 66 44 02 04 64 B3 CA` | 最大 |
| 开始治疗 | `55 AA 06 60 66 44 02 05 01 08 0B` | — |
| 暂停治疗 | `55 AA 06 60 66 44 02 05 00 C8 CA` | — |
| 进入老化 | `55 AA 06 60 66 44 02 07 01 68 0A` | — |
| 退出老化 | `55 AA 06 60 66 44 02 07 00 A8 CB` | — |
| 1-劲感律动 | `55 AA 06 60 66 44 02 09 01 08 0E` | 默认波形 |
| 2-活力律动 | `55 AA 06 60 66 44 02 09 02 09 4E` | — |
| 3-轻柔律动 | `55 AA 06 60 66 44 02 09 03 C9 8F` | — |
| 4-深润柔护 | `55 AA 06 60 66 44 02 09 04 0B CE` | — |
| 5-包裹柔护 | `55 AA 06 60 66 44 02 09 05 CB 0F` | — |
| 6-脉动柔护 | `55 AA 06 60 66 44 02 09 06 CA 4F` | — |
| 7-平顺舒缓 | `55 AA 06 60 66 44 02 09 07 0A 8E` | — |
| 8-胀感舒缓 | `55 AA 06 60 66 44 02 09 08 0E CE` | — |
| 9-静谧收尾 | `55 AA 06 60 66 44 02 09 09 CE 0F` | — |
| 档位0（关闭） | `55 AA 06 60 66 44 02 02 00 F8 C8` | 全局，关闭输出 |
| 档位1 | `55 AA 06 60 66 44 02 02 01 F9 08` | 全局，最小电流 |
| 档位2 | `55 AA 06 60 66 44 02 02 02 FB 08` | 全局 |
| 档位3 | `55 AA 06 60 66 44 02 02 03 FA C8` | 全局 |
| 档位4 | `55 AA 06 60 66 44 02 02 04 FE 08` | 全局 |
| 档位5 | `55 AA 06 60 66 44 02 02 05 FF C8` | 全局，中间值 |
| 档位6 | `55 AA 06 60 66 44 02 02 06 FD 08` | 全局 |
| 档位7 | `55 AA 06 60 66 44 02 02 07 FC C8` | 全局 |
| 档位8 | `55 AA 06 60 66 44 02 02 08 F4 08` | 全局 |
| 档位9 | `55 AA 06 60 66 44 02 02 09 F5 C8` | 全局 |
| 档位10 | `55 AA 06 60 66 44 02 02 0A FF 48` | 全局，最大电流 |
| 关机请求（设备→APP） | `55 AA 06 60 66 44 01 0A 00 38 3F` | 设备发起 |
| 确认关机（APP→设备） | `55 AA 06 60 66 44 02 0A 01 F8 0E` | 上位机回复 |
| 拒绝关机（APP→设备） | `55 AA 06 60 66 44 02 0A 00 38 CF` | 上位机回复 |

### CRC 计算速查

| 协议 | 算法 | 字节序 | 备注 |
|---|---|---|---|
| UART1 自定义协议 | CRC16-MODBUS | 高字节在前（Big-Endian） | 本文档所有帧均遵循 |

---

## 附录 B：帧结构速查图

```
主协议帧:
┌──────┬──────┬────────┬──────┬───────┬──────┬─────────┬──────────┐
│ 帧头 │ 长度 │  地址  │ 类型 │ 状态  │ 功能 │  参数   │   CRC    │
│2B    │ 1B   │  2B    │ 1B   │  1B   │ 1B   │ 0~nB    │   2B     │
│55 AA │      │60 66   │      │       │      │         │crcH crcL │
└──────┴──────┴────────┴──────┴───────┴──────┴─────────┴──────────┘

len 计算: len = 5 + 参数数量 (addrH+addrL+type+state+func+params)
CRC 范围: len ~ 最后一个参数字节 (共 len+1 字节)
```

---

## 附录 C：CRC 验证记录（设备地址 0x6066）

以下帧 CRC 均已通过独立计算验证：

| # | 帧描述 | len | CRC 结果 | 验证状态 |
|---|---|-----|---|---|
| 1 | 切换手柄 A (请求) | 0x06 | `0F 48` | ✅ |
| 2 | 切换手柄 B (请求) | 0x06 | `CF 89` | ✅ |
| 3 | 切换手柄 C (请求) | 0x06 | `0D C8` | ✅ |
| 4 | 温度关闭, 手柄 A (请求) | 0x07 | `9D E9` | ✅ |
| 5 | 温度关闭, 手柄 B (请求) | 0x07 | `5D 28` | ✅ |
| 6 | 20℃ (1%), 手柄 A (请求) | 0x07 | `0D E8` | ✅ |
| 7 | 20℃ (1%), 手柄 B (请求) | 0x07 | `CD 29` | ✅ |
| 8 | 25%百分比, 手柄 A (请求) | 0x07 | `0D E2` | ✅ |
| 9 | 25%百分比, 手柄 B (请求) | 0x07 | `CD 23` | ✅ |
| 10 | 37℃ (81%), 手柄 A (请求) | 0x07 | `0D D4` | ✅ |
| 11 | 37℃ (81%), 手柄 B (请求) | 0x07 | `CD 15` | ✅ |
| 12 | 50%百分比, 手柄 A (请求) | 0x07 | `FD FC` | ✅ |
| 13 | 50%百分比, 手柄 B (请求) | 0x07 | `3D 3D` | ✅ |
| 14 | 80%百分比, 手柄 A (请求) | 0x07 | `9D D5` | ✅ |
| 15 | 80%百分比, 手柄 B (请求) | 0x07 | `5D 14` | ✅ |
| 16 | 41℃ (100%), 手柄 A (请求) | 0x07 | `5D C3` | ✅ |
| 17 | 41℃ (100%), 手柄 B (请求) | 0x07 | `9D 02` | ✅ |
| 10 | 气泵关闭 (请求) | 0x06 | `58 CB` | ✅ |
| 11 | 气泵 50% (请求) | 0x06 | `8D 4A` | ✅ |
| 12 | 气泵 100% (请求) | 0x06 | `B3 CA` | ✅ |
| 13 | 开始治疗 (请求) | 0x06 | `08 0B` | ✅ |
| 14 | 暂停治疗 (请求) | 0x06 | `C8 CA` | ✅ |
| 15 | OTA 开始 (请求) | 0x06 | `38 CA` | ✅ |
| 16 | 进入老化 (请求) | 0x06 | `68 0A` | ✅ |
| 17 | 退出老化 (请求) | 0x06 | `A8 CB` | ✅ |
| 18 | 读版本号 (请求) | 0x05 | `7D DE` | ✅ |
| 19 | 手柄 A 切换应答 | 0x06 | `0F B8` | ✅ |
| 20 | 手柄 B 切换应答 | 0x06 | `CF 79` | ✅ |
| 21 | 手柄 C 切换应答 | 0x06 | `0D 38` | ✅ |
| 27 | 关闭加热, 手柄 A 应答 | 0x07 | `D9 E9` | ✅ |
| 28 | 关闭加热, 手柄 B 应答 | 0x07 | `19 28` | ✅ |
| 29 | 37℃ (81%), 手柄 A 应答 | 0x07 | `49 D4` | ✅ |
| 30 | 37℃ (81%), 手柄 B 应答 | 0x07 | `89 15` | ✅ |
| 31 | 41℃ (100%), 手柄 A 应答 | 0x07 | `19 C3` | ✅ |
| 32 | 41℃ (100%), 手柄 B 应答 | 0x07 | `D9 02` | ✅ |
| 24 | 气泵 50% 应答 | 0x06 | `8D BA` | ✅ |
| 25 | 开始治疗应答 | 0x06 | `08 FB` | ✅ |
| 26 | 暂停治疗应答 | 0x06 | `C8 3A` | ✅ |
| 27 | 版本号应答 V1.0 | 0x07 | `8C 19` | ✅ |
| 28 | OTA 开始应答 | 0x06 | `38 3A` | ✅ |
| 29 | 进入老化应答 | 0x06 | `68 FA` | ✅ |
| 30 | 1-劲感律动 (请求) | 0x06 | `08 0E` | ✅ |
| 31 | 2-活力律动 (请求) | 0x06 | `09 4E` | ✅ |
| 32 | 3-轻柔律动 (请求) | 0x06 | `C9 8F` | ✅ |
| 33 | 4-深润柔护 (请求) | 0x06 | `0B CE` | ✅ |
| 34 | 5-包裹柔护 (请求) | 0x06 | `CB 0F` | ✅ |
| 35 | 6-脉动柔护 (请求) | 0x06 | `CA 4F` | ✅ |
| 36 | 7-平顺舒缓 (请求) | 0x06 | `0A 8E` | ✅ |
| 37 | 8-胀感舒缓 (请求) | 0x06 | `0E CE` | ✅ |
| 38 | 9-静谧收尾 (请求) | 0x06 | `CE 0F` | ✅ |
| 39 | 1-劲感律动 应答 | 0x06 | `08 FE` | ✅ |
| 40 | 2-活力律动 应答 | 0x06 | `09 BE` | ✅ |
| 41 | 3-轻柔律动 应答 | 0x06 | `C9 7F` | ✅ |
| 42 | 4-深润柔护 应答 | 0x06 | `0B 3E` | ✅ |
| 43 | 5-包裹柔护 应答 | 0x06 | `CB FF` | ✅ |
| 44 | 6-脉动柔护 应答 | 0x06 | `CA BF` | ✅ |
| 45 | 7-平顺舒缓 应答 | 0x06 | `0A 7E` | ✅ |
| 46 | 8-胀感舒缓 应答 | 0x06 | `0E 3E` | ✅ |
| 47 | 9-静谧收尾 应答 | 0x06 | `CE FF` | ✅ |
| 48 | 档位0（关闭）(请求) | 0x06 | `F8 C8` | ✅ |
| 49 | 档位1 (请求) | 0x06 | `F9 08` | ✅ |
| 50 | 档位2 (请求) | 0x06 | `FB 08` | ✅ |
| 51 | 档位3 (请求) | 0x06 | `FA C8` | ✅ |
| 52 | 档位4 (请求) | 0x06 | `FE 08` | ✅ |
| 53 | 档位5 (请求) | 0x06 | `FF C8` | ✅ |
| 54 | 档位6 (请求) | 0x06 | `FD 08` | ✅ |
| 55 | 档位7 (请求) | 0x06 | `FC C8` | ✅ |
| 56 | 档位8 (请求) | 0x06 | `F4 08` | ✅ |
| 57 | 档位9 (请求) | 0x06 | `F5 C8` | ✅ |
| 58 | 档位10 (请求) | 0x06 | `FF 48` | ✅ |
| 59 | 档位0 应答 | 0x06 | `F9 08` | ✅ |
| 60 | 档位1 应答 | 0x06 | `F8 C8` | ✅ |
| 61 | 档位2 应答 | 0x06 | `FA C8` | ✅ |
| 62 | 档位3 应答 | 0x06 | `FB 08` | ✅ |
| 63 | 档位4 应答 | 0x06 | `FF C8` | ✅ |
| 64 | 档位5 应答 | 0x06 | `FE 08` | ✅ |
| 65 | 档位6 应答 | 0x06 | `FC C8` | ✅ |
| 66 | 档位7 应答 | 0x06 | `FD 08` | ✅ |
| 67 | 档位8 应答 | 0x06 | `F5 C8` | ✅ |
| 68 | 档位9 应答 | 0x06 | `F4 08` | ✅ |
| 69 | 档位10 应答 | 0x06 | `FE 88` | ✅ |

---

> **使用说明**：  
> 1. 本文档所有帧示例 CRC 已验证，可直接用于串口调试工具发送测试  
> 2. CRC 算法：CRC16-MODBUS（poly=0x8005, init=0xFFFF, RefIn=True, RefOut=True, XorOut=0x0000）  
> 3. 设备地址固定为 `0x60 0x66`（`DEVICE_ID_H`=0x60, `DEVICE_ID_L`=0x66）  
> 4. len 字段 = addrH ~ paraN 的总字节数 = 5 + 参数数量  
> 5. 温度控制采用百分比(0~100)，映射到 20~41℃，以本文档为准
