young-whites/microcurrent-beauty-device-v10/docs/我的项目概要.md

项目路径：I:\Github-young-whites\microcurrent-beauty-device-v10
项目代码路径：I:\Github-young-whites\microcurrent-beauty-device-v10\workItem-djm-v10-LTS
文件保存路径：I:\Github-young-whites\microcurrent-beauty-device-v10\docs

通讯协议：参照K:\WorkItem-djm-GL-01_Ver1.0这个路径下的通讯协议的格式和框架搭建本项目的通讯框架
指令包括：
1. 手柄切换指令:            0x01
2. 电流能量调节指令:        0x02
3. 温度调节指令：           0x03
4. 气泵转速调节指令：       0x04
5. 开始暂停指令：           0x05
6. 远程升级指令：           0x06
7. 老化模式指令：           0x07
8. 读取版本号指令：         0x08
9. 波形切换指令：           0x09
10. 关机请求/确认指令:      0x0A

/* 主板设备码以及版本号 */
#define DEVICE_ID_H     0x60
#define DEVICE_ID_L     0x66
#define DEVICE_VERSION  0x01
#define       FRAME_HEAD1                                        (0x55)      // 帧头1
#define       FRAME_HEAD2                                        (0xAA)      // 帧头2
#define       FRAME_TYPE_ACT                                     (0x44)      // 帧类型:动作命令
#define       FRAME_TYPE_GET                                     (0x45)      // 帧类型:参数获取
#define       FRAME_STATE_ASK                                    (0x02)      // 帧状态:上位请求
#define       FRAME_STATE_ACK                                    (0x01)      // 帧状态:下位应答

一共有3个手柄，区分为 A、B、C 三个手柄，其中 A手柄 具有的功能是 加热和微电流输出，B手柄同A手柄的功能，C手柄有微电流和泵控制的功能。
此处在协议层要进行区分： 也就是说 
切换成A手柄的指令：55 AA 06 60 66 44 02 01 0A 0F 48
切换成B手柄的指令：55 AA 06 60 66 44 02 01 0B CF 89
切换成C手柄的指令：55 AA 06 60 66 44 02 01 0C 0D C8

默认状态下处于手柄A的界面下，此时可以调节电流能量值，范围是(0~100)，以及温度调节
三个手柄的功能是互斥的，当切换到某手柄时，其他两个手柄的功能全部停止，相关参数清零。
例如：切换到手柄B时，手柄A和C的输出停止，电流/温度/泵参数全部清零。
切换回某手柄时，需要重新设置参数。手柄的温度调节采用百分比(0~100)，映射到20~41摄氏度。

NTC温度传感器的B值表是：

Resistance         100k Ohms at 25deg. C
Resistance Tolerance     + / -1%
B Value             3950K at 25/50 deg. C
B Value Tolerance         + / - 1%

Temp.
(deg. C)	Rmax
(k Ohms)	Rnor
(k Ohms)	Rmin
(k Ohms)

深圳市伟恒电子有限公司							
R25=100KΩ 精度:±1%                    B25/50=3950K 精度:±1%							
温度(℃)		电阻(KΩ)		温度(℃)		电阻(KΩ)	
	最小值	中心值	最大值		最小值	中心值	最大值
-50	6809.250 	6878.030 	6946.810 	38	57.019 	57.595 	58.171 
-49	6346.504 	6410.610 	6474.716 	39	54.744 	55.297 	55.850 
-48	5917.517 	5977.290 	6037.063 	40	52.573 	53.104 	53.635 
-47	5519.715 	5575.470 	5631.225 	41	50.500 	51.010 	51.520 
-46	5150.703 	5202.730 	5254.757 	42	48.519 	49.009 	49.499 
-45	4808.272 	4856.840 	4905.408 	43	46.627 	47.098 	47.569 
-44	4490.402 	4535.760 	4581.118 	44	44.819 	45.272 	45.725 
-43	4195.234 	4237.610 	4279.986 	45	43.091 	43.526 	43.961 
-42	3921.044 	3960.650 	4000.257 	46	41.438 	41.857 	42.276 
-41	3666.257 	3703.290 	3740.323 	47	39.858 	40.261 	40.664 
-40	3429.410 	3464.050 	3498.691 	48	38.348 	38.735 	39.122 
-39	3209.164 	3241.580 	3273.996 	49	36.901 	37.274 	37.647 
-38	3004.274 	3034.620 	3064.966 	50	35.521 	35.880 	36.239 
-37	2813.600 	2842.020 	2870.440 	51	34.194 	34.539 	34.884 
-36	2636.093 	2662.720 	2689.347 	52	32.925 	33.258 	33.591 
-35	2470.783 	2495.740 	2520.697 	53	31.711 	32.031 	32.351 
-34	2316.768 	2340.170 	2363.572 	54	30.547 	30.856 	31.165 
-33	2173.228 	2195.180 	2217.132 	55	29.433 	29.730 	30.027 
-32	2039.400 	2060.000 	2080.600 	56	28.365 	28.652 	28.939 
-31	1914.581 	1933.920 	1953.259 	57	27.342 	27.618 	27.894 
-30	1798.117 	1816.280 	1834.443 	58	26.360 	26.626 	26.892 
-29	1689.405 	1706.470 	1723.535 	59	25.419 	25.676 	25.933 
-28	1587.901 	1603.940 	1619.979 	60	24.516 	24.764 	25.012 
-27	1493.078 	1508.160 	1523.242 	61	23.651 	23.890 	24.129 
-26	1404.473 	1418.660 	1432.847 	62	22.820 	23.051 	23.282 
-25	1321.650 	1335.000 	1348.350 	63	22.023 	22.245 	22.467 
-24	1244.183 	1256.750 	1269.318 	64	21.257 	21.472 	21.687 
-23	1171.715 	1183.550 	1195.386 	65	20.523 	20.730 	20.937 
-22	1103.900 	1115.050 	1126.201 	66	19.817 	20.017 	20.217 
-21	1040.401 	1050.910 	1061.419 	67	19.139 	19.332 	19.525 
-20	980.933 	990.841 	1000.749 	68	18.487 	18.674 	18.861 
-19	925.212 	934.558 	943.904 	69	17.862 	18.042 	18.222 
-18	872.987 	881.805 	890.623 	70	17.260 	17.434 	17.608 
-17	824.018 	832.341 	840.664 	71	16.682 	16.850 	17.019 
-16	778.086 	785.945 	793.804 	72	16.126 	16.289 	16.452 
-15	734.986 	742.410 	749.834 	73	15.592 	15.749 	15.906 
-14	694.529 	701.544 	708.559 	74	15.077 	15.229 	15.381 
-13	656.538 	663.170 	669.802 	75	14.583 	14.730 	14.877 
-12	620.852 	627.123 	633.394 	76	14.107 	14.249 	14.391 
-11	587.317 	593.249 	599.181 	77	13.648 	13.786 	13.924 
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

硬件接口：

串口1：用于与Android设备通信，波特率9600
串口2：用于Debug，波特率115200

第一个NNC6521的硬件接口：
PC9 : NNC6521 MOSI
PC8 : NNC6521 CSN
PC7 : NNC6521 SCLK
PA12: NNC6521 CHIP_EN
PA11: NNC6521 INTB
PA8 : NNC6521 MISO

第二个NNC6521的硬件接口：
PB13: NNC6521 MOSI
PB12: NNC6521 CSN
PB11: NNC6521 SCLK
PC6 : NNC6521 CHIP_EN
PB15: NNC6521 INTB
PB14: NNC6521 MISO

系统电源板电源(12V) 接口： PA4 (高电平开启，低电平关闭)
电源开关按钮检测接口： 	   PA5 (默认情况下是高电平，当按钮按下后会检测到低电平持续1s认为按钮稳定按下开机，松开后该接口会恢复默认的高电平状态)
系统开关指示灯接口：       PA6 (高电平开启，低电平关闭)
蜂鸣器接口：               PA7 (高电平开启，低电平关闭)

LGS6302EP-1使能引脚(54V升压电源)： PB0 (高电平使能，低电平失能)，这个是给NNC6521-1这个芯片供电的
LGS6302EP-2使能引脚(54V升压电源)： PB1 (高电平使能，低电平失能)，这个是给NNC6521-2这个芯片供电的

NNC6521 通道映射：
手柄A -> NNC6521-1(CHIP_1) 的 CH0 通道，54V供电来自LGS6302EP-1(PB0)
手柄B -> NNC6521-1(CHIP_1) 的 CH1 通道，54V供电来自LGS6302EP-1(PB0)
手柄C -> NNC6521-2(CHIP_2) 的 CH0 通道，54V供电来自LGS6302EP-2(PB1)

DAC模块：使用的DAC7311IDCKR芯片
PB7:    DAC7311_SYNC
PB8:    DAC7311_SCLK
PB9:    DAC7311_DIN

DAC的输出在(0~5V，实测是线性输出的)

DAC7311 帧格式：
  Bit: 15 14 │ 13 12 11 10 9 8 7 6 5 4 3 2 │ 1 0
       M1 M0 │ D13 D12 D11 ... D1 D0        │ R R
       模式   │ 14-bit 有效数据 (value<<2)    │ 保留

泵控电压映射（上位机 0~100% → DAC 电压）：
  0%       → 0.0V（关泵）
  1%~90%   → 0.6V~4.5V（调速区间，线性）
  91%~100% → 4.6V~5.0V（满载恒速区间，线性）

泵特性：
  0~0.5V：不转（死区）
  0.6~4.5V：调速区间
  4.6~5.0V：满载恒速

VACUUM_PUMP_CONTROL气泵接口： PB10 (这个是泵的电源使能引脚-高电平使能，低电平使能)

PC0： 大手柄的NTC的ADC检测引脚 (B手柄)
PC1： 小手柄的NTC的ADC检测引脚 (A手柄)

PC10： 小手柄的 PID-PWM 输出引脚 (没有使用定时器，就是普通的GPIO推挽输出模式)
PC11： 大手柄的 PID-PWM 输出引脚 (没有使用定时器，就是普通的GPIO推挽输出模式)

大致的操作流程：

开机流程：电源开关按钮按下(PA5)，系统开关指示灯（PA6）常亮，蜂鸣器响1s，系统电源板电源(12V) 供电使能，不使能LGS6302EP(54V升压电源，这个只在需要电刺激输出时才使能)
关机流程：电源开关按钮短按(PA5)，单片机向上位机发送关机请求指令(func=0x0A, para[0]=0x00)，上位机弹窗让用户选择是否关机。如果用户选择"是"，上位机向单片机发送确认指令(func=0x0A, para[0]=0x01)，单片机收到后执行关机：关断54V升压电源(LGS6302EP)、关断气泵使能电源(PB10)、关断加热输出(PC10/PC11)、关断系统电源板电源(12V, PA4)、蜂鸣器响1声(1s)、关闭系统开关指示灯(PA6)。如果用户选择"否"，上位机发送拒绝指令(func=0x0A, para[0]=0x00)，单片机回到正常工作状态。10s内未收到回复，单片机自动回到正常工作状态，不关机。
