young-whites/microcurrent-beauty-device-v10/docs/测试用例表.md

# DJM-V10 微电流美容仪 — 模块化功能测试用例表

> **版本**: V2.0  
> **日期**: 2026-07-09  
> **适用平台**: STM32F103RCT6 / RT-Thread v5.1.0  
> **测试工具**: UART1 (9600bps) 上位机 + UART2 (115200bps) Debug 日志 + 万用表 + 示波器  
> **说明**: 勾选框可在飞书/GitHub/Obsidian 中直接点击勾选

---

## 测试环境

| 项目 | 说明 |
|---|---|
| 上位机 | Android APP 或 PC 串口工具（发送协议帧） |
| Debug 口 | UART2 (115200bps) 观察日志输出 |
| 测量工具 | 万用表（电压/电流/电阻）、示波器（波形/频率/脉宽）、温度计 |
| 供电 | 12V 系统电源（PA4 高电平使能） |
| NTC 模拟 | 精密电阻箱（模拟 NTC 阻值）或实际 NTC 探头 + 加热源 |

---

## 关键说明

- **加热 GPIO**: 小手柄 → PC10，大手柄 → PC11（非 PC12）
- **54V 升压**: 开机时不使能，仅在电刺激输出时开启
- **关机流程**: 单片机短按电源按钮发送关机请求(func=0x0A, para[0]=0x00)给上位机，上位机确认(para[0]=0x01)后执行关机；10s 超时未回复则不关机，自动回到 ON 状态
- **气泵控制**: PB10 简单开/关控制（高电平=使能，低电平=关闭），无 PWM 调速
- **测试编号格式**: `P{阶段}-{序号}`（如 `P1-01`、`P2-01`）

---

## 阶段一：电源与开机流程

电源管理和开关机流程测试。

### 1.1 开机流程

- [ ] **P1-01** 按钮检测：PA5 低电平持续 ≥1s → 系统检测到稳定按下
- [ ] **P1-02** 指示灯亮起：开机后 → PA6 输出高电平 → LED 常亮
- [ ] **P1-03** 蜂鸣器鸣叫：开机后 → PA7 输出高电平 1s → 蜂鸣器响 1s 后停止
- [ ] **P1-04** 12V 电源使能：开机后 → PA4 输出高电平 → 12V 电源接通
- [ ] **P1-05** 54V 升压不开机：开机后 → PB0=低, PB1=低 → 54V 升压未使能
- [ ] **P1-06** 开机时序验证：按钮 → LED → 蜂鸣器 1s → 12V 使能 → 通过 Debug 日志验证时序

### 1.2 关机流程

- [ ] **P1-07** 关机请求发送：短按 PA5（在系统 ON 状态下）→ 单片机通过 UART1 发送 func=0x0A 关机请求（para[0]=0x00）
- [ ] **P1-08** 上位机确认接收：上位机回复 func=0x0A, para[0]=0x01 → 单片机执行完整关机序列
- [ ] **P1-09** 关机输出切断：收到 ACK → 关闭 54V 升压(PB0/PB1=低)、关闭气泵(PB10=低)
- [ ] **P1-10** 关机 12V 切断：输出关闭后 → PA4=低 → 12V 电源断开
- [ ] **P1-11** 关机蜂鸣器：断电后 → PA7 高电平 1s → 蜂鸣器响一声
- [ ] **P1-12** 关闭指示灯：蜂鸣器结束后 → PA6=低 → LED 熄灭
- [ ] **P1-13** 关机超时处理：上位机 10s 内未回复 → 单片机不关机，自动回到 ON 状态
- [ ] **P1-14** 治疗中关机：运行状态 → 短按 → 发送关机请求 → 上位机确认 → 验证输出先停止再断电

### 1.3 GPIO 独立验证

- [ ] **P1-15** PA4 (12V 使能)：置高 → 12V 通；置低 → 12V 断
- [ ] **P1-16** PA5 (按钮)：默认高电平；按下 → 低电平；松开 → 高电平
- [ ] **P1-17** PA6 (LED)：置高 → 亮；置低 → 灭
- [ ] **P1-18** PA7 (蜂鸣器)：置高 → 响；置低 → 停
- [ ] **P1-19** PB0 (54V 升压 1)：置高 → LGS6302EP-1 使能；低 → 关闭
- [ ] **P1-20** PB1 (54V 升压 2)：置高 → LGS6302EP-2 使能；低 → 关闭

---

## 阶段二：基础外设调试

简单外设模块驱动验证。

### 2.1 LED 驱动 (bsp_led.c)

- [ ] **P2-01** LED 常亮：调用 `LED_On(LED_Name_Start)` → PA6 高电平，LED 亮
- [ ] **P2-02** LED 常灭：调用 `LED_Off(LED_Name_Start)` → PA6 低电平，LED 灭
- [ ] **P2-03** LED 翻转：调用 `LED_Toggle(LED_Name_Start)` → 每次调用电平翻转
- [ ] **P2-04** LED 呼吸渐变：调用 `LED_Grad(LED_Name_Start)` → LED 亮度渐变
- [ ] **P2-05** LED 闪烁：调用 `LED_Blink(LED_Name_Start, ...)` → LED 按配置频率闪烁

### 2.2 蜂鸣器驱动 (bsp_beep.c)

- [ ] **P2-06** 蜂鸣器长鸣：调用 `BEEP_On()` → PA7 高电平，蜂鸣器响
- [ ] **P2-07** 蜂鸣器关闭：调用 `BEEP_Off()` → PA7 低电平，蜂鸣器停
- [ ] **P2-08** 蜂鸣器间歇鸣叫：调用 `BEEP_Blink(cry, mute, repeat)` → 蜂鸣器间歇响

### 2.3 按键驱动 (bsp_key.c)

- [ ] **P2-09** 按键按下检测：按下按钮 → 事件检测到，Debug 日志输出按下
- [ ] **P2-10** 按键松开检测：松开按钮 → 事件检测到，Debug 日志输出松开

- [ ] **P2-13** 按键消抖：快速连按 → 无误触发，检测稳定

### 2.4 系统定时器 (rtt_system_work.c)

- [ ] **P2-14** 定时器初始化：上电后 Debug 日志输出 `sysTimer initialize succeed`
- [ ] **P2-15** 1ms 回调：观察 Debug 计数 → 1ms 回调以 1000Hz 频率触发
- [ ] **P2-16** 10ms 回调：观察 Debug 计数 → 10ms 回调以 100Hz 频率触发
- [ ] **P2-17** 50ms 回调：观察 Debug 计数 → 50ms 回调以 20Hz 频率触发
- [ ] **P2-18** 500ms 回调：观察 Debug 计数 → 500ms 回调以 2Hz 频率触发
- [ ] **P2-19** 1s 回调：观察 Debug 计数 → 1s 回调以 1Hz 频率触发
- [ ] **P2-20** 定时精度：运行 10s，对比回调计数与预期值 → 误差 < 1%

---

## 阶段三：调试串口 (UART2)

Debug 串口验证。

- [x] **P3-01** UART2 TX 输出：连接 UART2 TX (PA2) 到 PC → 串口工具以 115200bps 收到数据
- [x] **P3-02** UART2 RX 输入：向 UART2 RX (PA3) 发送字符 → MCU 正确接收
- [x] **P3-03** rt_kprintf 输出：调用 `rt_kprintf("test\n")` → UART2 输出正常
- [x] **P3-04** FinSH/MSH Shell：在 UART2 终端按回车 → MSH 提示符 `msh >` 出现
- [x] **P3-05** MSH 命令执行：输入 `list_thread` → 线程列表正确打印
- [x] **P3-06** MSH 命令 `list_device`：输入 `list_device` → 设备列表正确打印
- [x] **P3-07** MSH 命令 `list_timer`：输入 `list_timer` → 定时器列表正确打印
- [x] **P3-08** Debug 日志格式：日志包含模块标签、时间戳、消息内容

---

## 阶段四：通讯协议 (UART1)

协议帧解析和指令功能测试。

### 4.1 帧解析与校验

- [x] **P4-01** 正常帧解析：发送 `55 AA 05 60 66 44 02 08 7D DE` → 设备正确解析，返回版本号 ACK
- [ ] **P4-02** CRC 错误检测：修改 CRC 字节 → 设备丢弃该帧，不返回 ACK
- [ ] **P4-03** 帧头错误：发送 `56 AA ...` → 设备丢弃，状态机回到 IDLE
- [ ] **P4-04** 地址错误：修改设备地址字节 → 设备丢弃，不响应
- [ ] **P4-05** 超长帧处理：发送 >64 字节帧 → 设备丢弃，不崩溃
- [ ] **P4-06** 超短帧处理：发送不完整帧（仅帧头）→ 设备丢弃，状态机超时复位
- [ ] **P4-07** 连续帧发送：快速连续发送 10 帧不同指令 → 全部正确解析和应答，无丢帧
- [ ] **P4-08** 环形缓冲区满载：大量数据灌入 UART RX → 缓冲区满时丢弃新数据，不溢出

### 4.2 CRC16-MODBUS 验证

- [ ] **P4-09** CRC 计算正确性：输入 `05 60 66 44 02 08` → CRC = `7D DE`
- [ ] **P4-10** CRC 字节序：已知 CRC `0x0F48` → 帧中排列为 `0F 48`（高字节在前）

### 4.3 版本读取 (func=0x08)

- [ ] **P4-11** 正常读取版本：发送 `55 AA 05 60 66 44 02 08 7D DE` → ACK 返回 `01 00`（V1.0）
- [ ] **P4-12** 任意状态可响应：在暂停/运行/老化模式下分别发送 → 均正常返回版本号

### 4.4 手柄切换 (func=0x01)

- [ ] **P4-13** 切换至手柄 A：发送 `55 AA 06 60 66 44 02 01 0A 0F 48` → ACK 返回 `0A`
- [ ] **P4-14** 切换至手柄 B：发送 `55 AA 06 60 66 44 02 01 0B CF 89` → ACK 返回 `0B`
- [ ] **P4-15** 切换至手柄 C：发送 `55 AA 06 60 66 44 02 01 0C 0D C8` → ACK 返回 `0C`
- [ ] **P4-16** 无效手柄 ID：发送 `func=0x01, para=0x0D` → 返回参数错误（err=0x01）
- [ ] **P4-17** 切换时互斥清零：A 手柄运行中切换到 B → A/C 的波形停止、加热关闭、气泵关闭、所有手柄参数清零
- [ ] **P4-18** 参数清零验证：A 设 50mA 电流 → 切 B → 切回 A → A 的电流值为 0mA（需重新设置）
- [ ] **P4-19** 默认手柄：上电后读取当前手柄 → 默认为手柄 A

### 4.5 电流控制 (func=0x02)

- [ ] **P4-20** 设置电流 0mA（手柄 A）：发送 `55 AA 07 60 66 44 02 02 00 0A 5D B8` → ACK，波形停止输出
- [ ] **P4-21** 设置电流 30mA（手柄 A）：发送 `55 AA 07 60 66 44 02 02 1E 0A FD B1` → ACK，输出电流 30mA（若波形范围包含）
- [ ] **P4-22** 设置电流 50mA（手柄 A）：发送 `55 AA 07 60 66 44 02 02 32 0A 3D AD` → ACK，输出电流 50mA
- [ ] **P4-23** 电流值独立性：A 设 50mA，B 设 30mA → 两参数独立保存互不影响
- [ ] **P4-24** 跨手柄设置：当前为 A，发送设置 B 的电流 30mA → B 参数保存，A 输出不变
- [ ] **P4-25** 超范围值：发送 current_ma=101 → 返回参数错误
- [ ] **P4-26** 波形切换后电流保持：设 50mA → 切换波形 → 读取电流 → 仍为 50mA（clamp 到新波形范围）

### 4.6 温度调节 (func=0x03)

- [ ] **P4-27** 设置温度 37℃（手柄 A）：发送 `55 AA 07 60 66 44 02 03 51 0A 0D D4` → ACK
- [ ] **P4-28** 设置温度 41℃（手柄 A）：发送 `55 AA 07 60 66 44 02 03 64 0A 5D C3` → ACK
- [ ] **P4-29** 关闭加热（温度=0）：发送 `55 AA 07 60 66 44 02 03 00 0A 9D E9` → ACK，PID 禁用
- [ ] **P4-30** 温度百分比上限限制：发送 percent=101 → 自动限幅至 100（41℃）
- [ ] **P4-31** 手柄 C 不支持加热：当前为 C，发送温度指令 → 返回错误或无效
- [ ] **P4-32** 手柄 A/B 温度独立：A 设 37℃（percent=81），B 设 41℃（percent=100）→ 两参数独立保存

### 4.7 气泵控制 (func=0x04)

- [ ] **P4-33** 气泵关闭：发送 `55 AA 06 60 66 44 02 04 00 58 CB` → ACK，DAC 输出 0V
- [ ] **P4-34** 气泵 100%：发送 `55 AA 06 60 66 44 02 04 64 B3 CA` → ACK，DAC 输出 5.0V
- [ ] **P4-35** 手柄 A/B 下发气泵指令：当前手柄 A，发气泵指令 → 无效或返回错误
- [ ] **P4-33a** 气泵死区验证：发送 0% → DAC=0.0V，泵不转
- [ ] **P4-33b** 气泵调速区间：发送 50% → DAC≈2.75V（0.6~4.5V 线性插值）
- [ ] **P4-33c** 气泵满载区间：发送 95% → DAC≈4.75V（4.6~5.0V 线性插值）

### 4.8 开始/暂停 (func=0x05)

- [ ] **P4-36** 开始治疗：发送 `55 AA 06 60 66 44 02 05 01 08 0B` → ACK，is_running=1，波形输出
- [ ] **P4-37** 暂停治疗：发送 `55 AA 06 60 66 44 02 05 00 C8 CA` → ACK，is_running=0，波形停止
- [ ] **P4-38** 重复开始：连续发送两次开始 → 第二次不异常（幂等）
- [ ] **P4-39** 重复暂停：连续发送两次暂停 → 第二次不异常（幂等）
- [ ] **P4-40** 未设参数直接开始：上电后直接发开始指令 → 以默认参数（0mA 电流）启动
- [ ] **P4-41** 暂停后加热保持：运行中设 37℃ → 暂停 → 温控继续工作，加热不中断

### 4.9 波形切换 (func=0x09)

- [ ] **P4-42** 切换至波形 1：发送 `55 AA 06 60 66 44 02 09 01 08 0E` → ACK，波形 ID=1
- [ ] **P4-43** 切换至波形 9：发送 `55 AA 06 60 66 44 02 09 09 CE 0F` → ACK，波形 ID=9
- [ ] **P4-44** 遍历波形 1~9：依次发送波形 1 到 9 → 全部正确切换并 ACK
- [ ] **P4-45** 无效波形 ID (0)：发送 `func=0x09, para=0x00` → 返回参数错误
- [ ] **P4-46** 无效波形 ID (10)：发送 `func=0x09, para=0x0A` → 返回参数错误
- [ ] **P4-47** 切换时停止输出：波形 1 运行中切换到波形 3 → 旧波形立即停止
- [ ] **P4-48** 切换后电流保持：设 50mA → 切波形 → 读取 → 电流值仍为 50mA（clamp 到新波形范围）
- [ ] **P4-49** 默认波形：上电后读取当前波形 → 默认为波形 1（劲感律动）

### 4.10 关机请求/确认 (func=0x0A)

- [ ] **P4-50** 关机请求发送：短按电源按钮（ON 状态下）→ 单片机发送 func=0x0A 帧（para[0]=0x00）给上位机
- [ ] **P4-51** 上位机确认关机：上位机回复 func=0x0A, para[0]=0x01 → 单片机执行完整关机序列（停波形→关boost→关加热→关泵→关12V→蜂鸣→LED灭）
- [ ] **P4-52** 上位机未确认（超时）：10s 内无回复 → 单片机不关机，自动回到 ON 状态
- [ ] **P4-53** 治疗中关机：运行状态 → 短按发关机请求 → 上位机确认 → 输出停止 → 关boost → 关12V → 蜂鸣 → LED灭
- [ ] **P4-54** 上位机拒绝关机：上位机回复 func=0x0A, para[0]=0x00 → 单片机不关机，回到 ON 状态，设备继续工作

### 4.11 老化模式 (func=0x07)

- [ ] **P4-55** 进入老化模式：发送 `55 AA 06 60 66 44 02 07 01 68 0A` → ACK，aging_mode=1
- [ ] **P4-56** 退出老化模式：发送 `55 AA 06 60 66 44 02 07 00 A8 CB` → ACK，aging_mode=0
- [ ] **P4-57** 老化模式下忽略指令：进入老化后发开始/电流指令 → 不响应或返回设备忙

### 4.12 OTA 升级 (func=0x06)

- [ ] **P4-58** OTA 升级请求：发送 `55 AA 06 60 66 44 02 06 00 38 CA` → 返回 ACK
- [ ] **P4-59** 治疗中 OTA：运行状态 → 发送 OTA → 返回错误（设备忙）

---

## 阶段五：NTC 温度传感器

NTC 温度传感器模块验证。

- [ ] **P5-01** NTC 初始化：上电后 Debug 日志输出 `[NTC] Sensor module initialized, channels=2`
- [ ] **P5-02** ADC 悬空检测：不接 NTC → ADC 值接近 4095，温度显示极低
- [ ] **P5-03** ADC 短路检测：NTC 短接到 GND → ADC 值接近 0，温度显示极高
- [ ] **P5-04** 25℃基准点：NTC 接 100kΩ 精密电阻 → ADC ≈ 2048，温度 ≈ 25.0℃
- [ ] **P5-05** 查表法精度 0℃：电阻箱设 329.6kΩ → 温度 ≈ 0.0℃（误差 < 0.5℃）
- [ ] **P5-06** 查表法精度 37℃：电阻箱设 60.0kΩ → 温度 ≈ 37.0℃（误差 < 0.5℃）
- [ ] **P5-07** 查表法精度 41℃：电阻箱设 51.01kΩ → 温度 ≈ 41.0℃（误差 < 0.5℃）
- [ ] **P5-08** 滑动平均滤波：持续观察温度输出 → 无明显跳变，平滑过渡
- [ ] **P5-09** 传感器故障检测：断开 NTC 引线 → 连续异常后触发 sensor_fault 标志
- [ ] **P5-10** 双通道独立性：CH10 (PC0) 和 CH11 (PC1) → 各自独立读取，无串扰

---

## 阶段六：PID 温度控制

PID 温度控制器验证。

- [ ] **P6-01** PID 初始化：上电后 Debug 日志输出 Kp=8.0, Ki=0.150, Kd=3.0
- [ ] **P6-02** 升温控制：NTC 探头常温，设目标 37℃ → 加热开启，温度逐步上升至 37℃ 附近
- [ ] **P6-03** 稳态精度：温度稳定后观察 → 温度在 37±0.5℃ 范围内
- [ ] **P6-04** 死区控制：温度接近目标（误差 < 0.3℃）→ 加热不频繁开关
- [ ] **P6-05** 超温软保护：用加热源强制升温超过目标 1℃ → PID 输出归零，积分衰减
- [ ] **P6-06** 过热硬保护：强制升温超过 45℃ → PID 禁用，加热关闭，日志告警
- [ ] **P6-07** 目标变化积分重置：设 37℃ → 立即改 41℃ → 积分项清零，无超调
- [ ] **P6-08** 加热 GPIO 验证：PID 输出 > 0 时测量 PC10（小手柄）/ PC11（大手柄）→ 有 PWM 波形
- [ ] **P6-09** PWM 占空比：PID 输出 60% → PC10/PC11 高电平约 600ms / 1000ms 周期
- [ ] **P6-10** 双手柄独立 PID：手柄 A 加热 → 切换到手柄 B → A 加热停止，B 的 PID 独立运行

---

## 阶段七：DAC 模块 (DAC7311IDCKR)

DAC 电压输出验证。

- [ ] **P7-01** DAC 初始化：上电后 PB7(SYNC)/PB8(SCLK)/PB9(DIN) 配置正确
- [ ] **P7-02** DAC 输出 0V：写入 0x000 → DAC 输出 ≈ 0V（万用表测量）
- [ ] **P7-03** DAC 输出 2.5V：写入中间值 → DAC 输出 ≈ 2.5V
- [ ] **P7-04** DAC 输出 5V：写入 0xFFF → DAC 输出 ≈ 5V
- [ ] **P7-05** 线性度验证：逐步递增写入值 → 输出电压线性递增
- [ ] **P7-06** DAC 输出稳定性：固定值持续 60s → 输出电压漂移 < 10mV

---

## 阶段八：NNC6521 波形发生器

NNC6521 波形发生器芯片验证（需示波器）。

### 8.1 芯片初始化

- [ ] **P8-01** GPIO 初始化：上电后所有 SPI 引脚正确配置（MOSI/CSN/SCLK/EN 为输出，MISO/INTB 为输入）
- [ ] **P8-02** 芯片 1 上电序列：CHIP_EN(PA12): LOW → 延时 → HIGH，日志无报错
- [ ] **P8-03** 芯片 2 上电序列：CHIP_EN(PC6): LOW → 延时 → HIGH，日志无报错
- [ ] **P8-04** SPI 通信验证：读取已知寄存器 → 返回值符合预期（非全 0x00/0xFF）

### 8.2 波形输出（需示波器）

- [ ] **P8-05** 通道使能：调用 `nnc6521_analog_enable(CHIP_1, CH0)` → Handle A 模拟输出使能
- [ ] **P8-05b** 通道使能：调用 `nnc6521_analog_enable(CHIP_1, CH1)` → Handle B 模拟输出使能
- [ ] **P8-05c** 通道使能：调用 `nnc6521_analog_enable(CHIP_2, CH0)` → Handle C 模拟输出使能
- [ ] **P8-06** 预加载正弦波：调用 `preloaded_waveform(SINE, 64)` → 示波器可见正弦波
- [ ] **P8-07** 预加载方波：调用 `preloaded_waveform(PULSE, 64)` → 示波器可见方波
- [ ] **P8-08** 预加载三角波：调用 `preloaded_waveform(TRIANGLE, 64)` → 示波器可见三角波
- [ ] **P8-09** 自定义 SPI 波形：调用 `customized_waveform(128, sine_array)` → 示波器可见自定义波形
- [ ] **P8-10** 幅度调制：调用 `amplitude_modulation(64, env_array)` → 示波器可见 AM 波形
- [ ] **P8-11** AWG 禁用：调用 `awg_enable_disable(CH0, 0)` → 波形输出停止
- [ ] **P8-12** 双芯片三通道独立：Handle A(CHIP_1 CH0) 输出波形 1，Handle B(CHIP_1 CH1) 输出波形 3，Handle C(CHIP_2 CH0) 输出波形 5 → 三通道独立工作互不影响

### 8.3 安全检测

- [ ] **P8-13** LOD 初始化：调用 `nnc6521_lod_init()` → 寄存器正确配置
- [ ] **P8-14** SCD 初始化：调用 `nnc6521_scd_init()` → 寄存器正确配置
- [ ] **P8-15** LOD 中断清除：调用 `nnc6521_clear_lod_int()` → 中断标志清零
- [ ] **P8-16** SCD 中断清除：调用 `nnc6521_clear_scd_int()` → 中断标志清零

---

## 阶段九：集成场景测试

多模块联合的端到端场景验证。

- [ ] **P9-01** 完整治疗流程（手柄 A）：读版本 → 设波形1 → 设37℃(percent=81) → 设电流50mA → 开始 → 波形+加热同时工作
- [ ] **P9-02** 完整治疗流程（手柄 B）：切B → 设波形3 → 设41℃(percent=100) → 设电流60mA → 开始 → 验证B参数独立于A
- [ ] **P9-03** 完整治疗流程（手柄 C）：切C → 设波形5 → 设电流60mA → 设气泵开 → 开始 → 微电流+气泵同时工作
- [ ] **P9-04** 手柄切换全流程：A 运行 → 切B → B 设参数运行 → 切C → C 运行 → 切回A → A 参数为零需重新设置
- [ ] **P9-05** 治疗中切换波形：运行波形 1 → 切换到波形 5 → 旧波形停 → 新波形以当前电流 mA 值输出（clamp 到新波形范围）
- [ ] **P9-06** 温度+电流同时运行：设37℃(percent=81) + 50mA 电流 → 开始 → 加热和微电流同时工作
- [ ] **P9-07** 长时间稳定性：连续运行 30 分钟 → 无崩溃、无异常重启、温度稳定
- [ ] **P9-08** 掉电恢复：运行中断电 → 重新上电 → 恢复默认状态，无损坏
- [ ] **P9-09** 治疗中关机：完整治疗运行中 → 短按电源 → 关机请求 → 上位机确认 → 所有输出关闭 → 蜂鸣 → LED 灭
- [ ] **P9-10** 全波形遍历（手柄 A）：遍历波形 1~9 → 每个正常启停 → 电流映射验证

---

## 测试记录

| 轮次 | 日期 | 测试人 | 通过数 / 总数 | 备注 |
|---|---|---|---|---|
| | | | / | |

---

*— 测试用例表 V2.0 中文版 —*
