young-whites/microcurrent-beauty-device-v10/docs/嵌入式通讯协议文档范本.md

# [项目名称] - 通信协议文档

> **版本**: V1.0  
> **日期**: YYYY-MM-DD  
> **适用平台**: [芯片型号 / RTOS / 硬件平台]

---

## 一、文档变更记录

| 版本 | 日期 | 作者 | 主要改动 |
|---|---|---|---|
| V1.0 | YYYY-MM-DD | [作者] | 初始版本 |

---

## 二、协议概览

### 2.1 通信接口总览

| 接口 | 物理层 | 波特率/速率 | 协议类型 | 对端设备 | 用途 |
|---|---|---|---|---|---|
| UART1 | TTL/RS232/RS485 | XXXXbps / 8N1 | 自定义帧 | [上位机/APP] | 设备控制与状态上报 |
| UART2 | TTL | XXXXbps / 8N1 | [协议类型] | [设备] | [用途] |
| SPI1 | SPI | — | [驱动方式] | [外设型号] | [用途] |
| I2C1 | I2C | — | 寄存器 | [外设型号] | [用途] |
| CAN1 | CAN | XXXkbps | CAN 2.0 | [设备] | [用途] |

> 根据实际项目增删接口条目。

### 2.2 物理接口参数

| 参数 | 值 | 备注 |
|---|-----|---|
| 电平标准 | TTL 3.3V / 5V / RS232 / RS485 | — |
| 波特率 | XXXX bps | — |
| 数据位 | 8 | — |
| 停止位 | 1 | — |
| 校验位 | None / Even / Odd | — |
| DMA | 收发均使用 / 仅发送 / 关闭 | — |
| 收发控制引脚 | [GPIO PIN]（仅 RS485） | DE/RE 方向控制 |

---

## 三、帧格式定义

### 3.1 主协议帧格式（自定义）

```
[帧头] [len] [addrH] [addrL] [type] [state] [func] [para1] ... [paraN] [crcH] [crcL]
```

| 字段 | 字节数 | 值/范围 | 说明 |
|---|---|---|---|
| 帧头 | 2 | `[HEAD1] [HEAD2]` | 固定标识，按项目定义 |
| 长度 (len) | 1 | 0x05~0xFF | addrH ~ paraN 的总字节数，len = 5 + 参数数量 |
| 设备地址高字节 (addrH) | 1 | `DEVICE_ID_H` | 设备固定地址高字节 |
| 设备地址低字节 (addrL) | 1 | `DEVICE_ID_L` | 设备固定地址低字节 |
| 类型 (type) | 1 | `FRAME_TYPE_ACT`=动作, `FRAME_TYPE_GET`=查询 | 命令分类 |
| 状态 (state) | 1 | `FRAME_STATE_ACK`=应答, `FRAME_STATE_ASK`=请求 | 通信方向标识 |
| 功能码 (func) | 1 | `0x01`~`0xFF` | 具体功能编号 |
| 参数 (para) | 0~N | 可变 | 功能相关参数，按需定义 |
| 校验 (crcH/crcL) | 2 | CRC16-XXXX | 校验范围：len ~ paraN 共 (len+1) 字节，**高字节在前** |

> ⚠️ **len 字段计算要点**：len 包含地址 2 字节 + 类型 1 字节 + 状态 1 字节 + 功能码 1 字节 + 参数 N 字节 = 5 + N。
> - 无参数指令：len = 0x05
> - 单参数指令：len = 0x06
> - 双参数指令：len = 0x07

### 3.2 设备固件宏定义

```c
/* 主板设备码以及版本号 */
#define DEVICE_ID_H     0xXX
#define DEVICE_ID_L     0xXX
#define DEVICE_VERSION  0x01
```

### 3.3 帧参数宏定义

```c
#define FRAME_HEAD1     0xXX    // Frame header 1
#define FRAME_HEAD2     0xXX    // Frame header 2
#define FRAME_TYPE_ACT  0xXX    // Frame type: action command
#define FRAME_TYPE_GET  0xXX    // Frame type: parameter get
#define FRAME_STATE_ASK 0xXX    // Frame state: host request
#define FRAME_STATE_ACK 0xXX    // Frame state: device response
```

### 3.4 CRC 校验规则

| 项目 | 值 |
|---|-----|
| 算法 | CRC16-MODBUS / CRC16-CCITT / CRC16-X25（按需选择） |
| 多项式 | [0x8005 / 0x1021 / ...] |
| 初始值 | [0xFFFF / 0x0000 / ...] |
| 输入反转 | [True / False] |
| 输出反转 | [True / False] |
| 异或值 | [0x0000 / ...] |
| 计算范围 | len ~ paraN（不含帧头 55 AA 和 CRC 本身），共 (len+1) 字节 |
| 字节序 | **高字节在前 / 低字节在前**（必须明确约定） |
| 示例 | 计算结果 `0x1A75` → 帧中排列 `1A 75`（Big-Endian 示例） |

> ⚠️ 不同协议的 CRC 字节序可能不同（如标准 Modbus 为小端，自定义协议可能为大端），务必在文档中明确标注。

### 3.5 len 字段计算规则

```
len = addrH(1) + addrL(1) + type(1) + state(1) + func(1) + 参数数量
len = 5 + 参数数量

示例：
- 无参数指令（读版本号）：len = 5 + 0 = 0x05
- 单参数指令（能量调节）：len = 5 + 1 = 0x06
- 双参数指令（版本号应答）：len = 5 + 2 = 0x07
```

---

## 四、功能码定义

### 4.1 动作命令（type=FRAME_TYPE_ACT）

| 功能码 | 名称 | 参数定义 | 说明 |
|---|---|---|---|
| `0x01` | [功能名] | para[0]=[含义](范围) | [描述] |
| `0x02` | [功能名] | para[0]=[含义](范围), para[1]=[含义](范围) | [描述] |
| `0x03` | [功能名] | 无参数 | [描述] |
| ... | ... | ... | ... |

### 4.2 查询/参数命令（type=FRAME_TYPE_GET）

| 功能码 | 名称 | 参数定义 | 返回数据 | 说明 |
|---|---|---|---|---|
| `0x01` | 读取版本号 | 无 | [版本格式] | [描述] |
| `0x02` | 读取设备状态 | 无 | [状态格式] | [描述] |
| `0x03` | 设置参数 | para[0]=[含义] | 应答确认 | [描述] |
| ... | ... | ... | ... | ... |

---

## 五、指令详细定义

### 5.1 [功能名称]（func=0xXX）

**方向**: APP → 设备 / 设备 → APP / 双向

**参数定义**:

| 参数 | 偏移 | 长度 | 类型 | 范围 | 说明 |
|---|---|---|---|---|---|
| para[0] | 0 | 1 byte | uint8 | 0~255 | [含义] |
| para[1] | 1 | 2 bytes | uint16 BE | 0~65535 | [含义] |

**请求帧示例（APP→设备, state=FRAME_STATE_ASK, len=0x06）**:

```
[HEAD1] [HEAD2] 06 [addrH] [addrL] [TYPE_ACT] [STATE_ASK] 01 [para0] [crcH] [crcL]
│       │       │  └──地址──┘ │      │          │           │   └参数┘  └─CRC──┘
│       │       │             │      │          │           │
│       │       len           │      type       state       func
│       帧头                  addr
```

**应答帧示例（设备→APP, state=FRAME_STATE_ACK, len=0x06）**:

```
[HEAD1] [HEAD2] 06 [addrH] [addrL] [TYPE_ACT] [STATE_ACK] 01 [para0] [crcH] [crcL]
```

**说明**:
- [补充说明注意事项]

---

## 六、应答机制

### 6.1 成功应答

| 场景 | state 字段 | 帧结构变化 |
|---|---|---|
| 请求（上位机→设备） | `FRAME_STATE_ASK` | 保持原始功能码和参数 |
| 应答（设备→上位机） | `FRAME_STATE_ACK` | state 改为 ACK 值，其余字段回传 |

### 6.2 错误应答（如需定义）

| 错误码 | 含义 | 说明 |
|---|---|---|
| `0x00` | 成功 | — |
| `0x01` | 参数错误 | 参数越界或格式不合法 |
| `0x02` | 不支持的功能码 | func 未实现 |
| `0x03` | 设备忙 | 当前状态不允许执行 |
| `0xFF` | 未知错误 | — |

> 错误应答帧格式（扩展定义，待确认）：
> `[HEAD1] [HEAD2] [len] [addrH] [addrL] [type] [STATE_ACK] [func] [errorCode] [crcH] [crcL]`

---

## 七、外部总线协议（如 Modbus RTU）

### 7.1 通信参数

| 参数 | 值 |
|---|-----|
| 串口 | [UARTX] / XXXXbps / 8N1 |
| 接口 | RS485（DE/RE 控制引脚: [GPIO PIN]） |
| 协议 | Modbus RTU |
| DMA | [收发均使用 / 仅发送 / 关闭] |

### 7.2 Modbus CRC 字节序

> ⚠️ 标准 Modbus RTU：CRC **低字节在前，高字节在后**。  
> 与主协议的 CRC 字节序可能**相反**，务必区分。

### 7.3 设备实例

| 实例 | 从站地址 | 用途 | 细分/分辨率 | 默认速度 |
|---|---|---|---|---|
| [设备1] | 0x01 | [用途] | [值] | [值] |
| [设备2] | 0x02 | [用途] | [值] | [值] |

### 7.4 功能码

| 功能码 | 含义 |
|---|---|
| `0x03` | 读保持寄存器 |
| `0x06` | 写单个寄存器 |
| `0x10` | 写多个寄存器 |

### 7.5 寄存器映射

| 寄存器地址 | 功能码 | 数据格式 | 范围 | 说明 |
|---|---|---|---|---|
| `0x0024` | 0x10 | 32bit LE | 0~1000000 | [细分设置] |
| `0x0096` | 0x06 | 16bit BE | 0~200 | [启动速度] |
| `0x00C8` | 0x06 | 16bit BE | — | [运动控制] |
| ... | ... | ... | ... | ... |

### 7.6 位域定义（如有）

**寄存器 [0xXXXX] 位域**:

```
Bit 15~13 : [字段名] (范围)
Bit 12    : [字段名] (0=XXX, 1=YYY)
Bit 11~8  : [字段名] (0~15)
Bit 7~0   : [字段名] (范围)
```

---

## 八、SPI / I2C 外设

### 8.1 [外设名称]（SPI[X]）

| 参数 | 值 |
|---|-----|
| 用途 | [描述] |
| 型号 | [芯片型号] |
| 驱动方式 | [SPI MOSI / 标准SPI] |
| 时钟极性/相位 | CPOL=[0/1], CPHA=[0/1] |
| 通信速率 | [Hz] |
| 关键函数 | `[function_name](args)` — [说明] |

### 8.2 [外设名称]（I2C[X]）

| 参数 | 值 |
|---|-----|
| 用途 | [描述] |
| 型号 | [芯片型号] |
| 从机地址 | `0xXX`（7-bit） |
| 关键函数 | `[function_name](args)` — [说明] |

---

## 九、通信时序

### 9.1 典型操作流程

```
1. 上电初始化
2. [操作1]:  [HEAD1] [HEAD2] 05 [addr] [type] [ASK] 08 [crc]   ← 读取版本
3. [操作2]:  [HEAD1] [HEAD2] 06 [addr] [type] [ASK] 01 [para] [crc]  ← 设置参数
4. [操作3]:  [HEAD1] [HEAD2] 06 [addr] [type] [ASK] 02 [para] [crc]  ← 启动功能
5. [操作4]:  [HEAD1] [HEAD2] 05 [addr] [type] [ASK] 03 [crc]   ← 读取结果
6. [操作5]:  [HEAD1] [HEAD2] 06 [addr] [type] [ASK] 04 [para] [crc]  ← 停止/复位
```

### 9.2 时序约束

| 约束项 | 值 | 说明 |
|---|-----|---|
| 请求-应答超时 | XXX ms | 超过此时间未应答视为失败 |
| 最小发送间隔 | XX ms | 连续两帧之间的最小间隔 |
| 重发次数 | X 次 | 超时后最大重发次数 |
| 设备初始化时间 | XXX ms | 上电后需等待此时间才可通信 |

### 9.3 注意事项

- [注意事项1：如不同总线CRC字节序不同]
- [注意事项2：如某功能有自动延时逻辑]
- [注意事项3：如主动上报机制说明]
- [注意事项4：如多设备地址冲突处理]

---

## 十、代码索引

| 文件路径 | 说明 |
|---|---|
| `applications/BSP/xxx.c` | [主协议解析与应答] |
| `applications/BSP/xxx.h` | [协议宏定义与帧结构] |
| `applications/BSP/xxx.c` | [RS485/CAN 底层驱动] |
| `applications/BSP/xxx.c` | [SPI/I2C 外设驱动] |
| `applications/SYS/xxx.c` | [系统初始化与全局状态] |
| `applications/main.c` | [主循环与初始化入口] |

---

## 附录 A：快速参考卡

### 常用指令速查

| 操作 | 完整帧 | 说明 |
|---|---|---|
| [操作1] | `[HEAD] [len] [addr] [type] [state] [func] [crc]` | [简述] |
| [操作2] | `[HEAD] [len] [addr] [type] [state] [func] [para] [crc]` | [简述] |
| [操作3] | `[HEAD] [len] [addr] [type] [state] [func] [para] [crc]` | [简述] |

### CRC 计算速查

| 协议 | 算法 | 字节序 | 备注 |
|---|---|---|---|
| 主协议(UART) | CRC16-MODBUS | 高字节在前 | Big-Endian |
| Modbus RTU(RS485) | CRC16-MODBUS | 低字节在前 | Little-Endian |

---

## 附录 B：帧结构速查图

```
主协议帧:
┌──────┬──────┬────────┬──────┬───────┬──────┬─────────┬──────────┐
│ 帧头 │ 长度 │  地址  │ 类型 │ 状态  │ 功能 │  参数   │   CRC    │
│ 2B   │ 1B   │  2B    │ 1B   │  1B   │ 1B   │ 0~nB    │   2B     │
└──────┴──────┴────────┴──────┴───────┴──────┴─────────┴──────────┘

len 计算: len = 5 + 参数数量 (addrH+addrL+type+state+func+params)
CRC 范围: len ~ 最后一个参数字节 (共 len+1 字节)

Modbus RTU 帧:
┌──────────┬──────────┬──────────┬──────────┐
│ 从站地址 │  功能码  │  数据域  │   CRC    │
│   1B     │   1B     │  0~nB    │   2B     │
└──────────┴──────────┴──────────┴──────────┘
```

---

> **使用说明**：  
> 1. 将 `[方括号]` 中的占位符替换为项目实际值  
> 2. 删除不适用的接口段落（如无 CAN 则删除 CAN 相关段落）  
> 3. 根据实际功能码数量增删「第五章」的详细定义条目  
> 4. CRC 字节序是最容易出错的地方，务必与实际固件代码验证一致  
> 5. 代码索引表应与项目目录结构保持同步更新  
> 6. **len 字段必须包含地址 2 字节**，即 len = 5 + 参数数量，而非 4 + 参数数量
