young-whites/microcurrent-beauty-device-v10/schematic/主控板-硬件资料.pdf

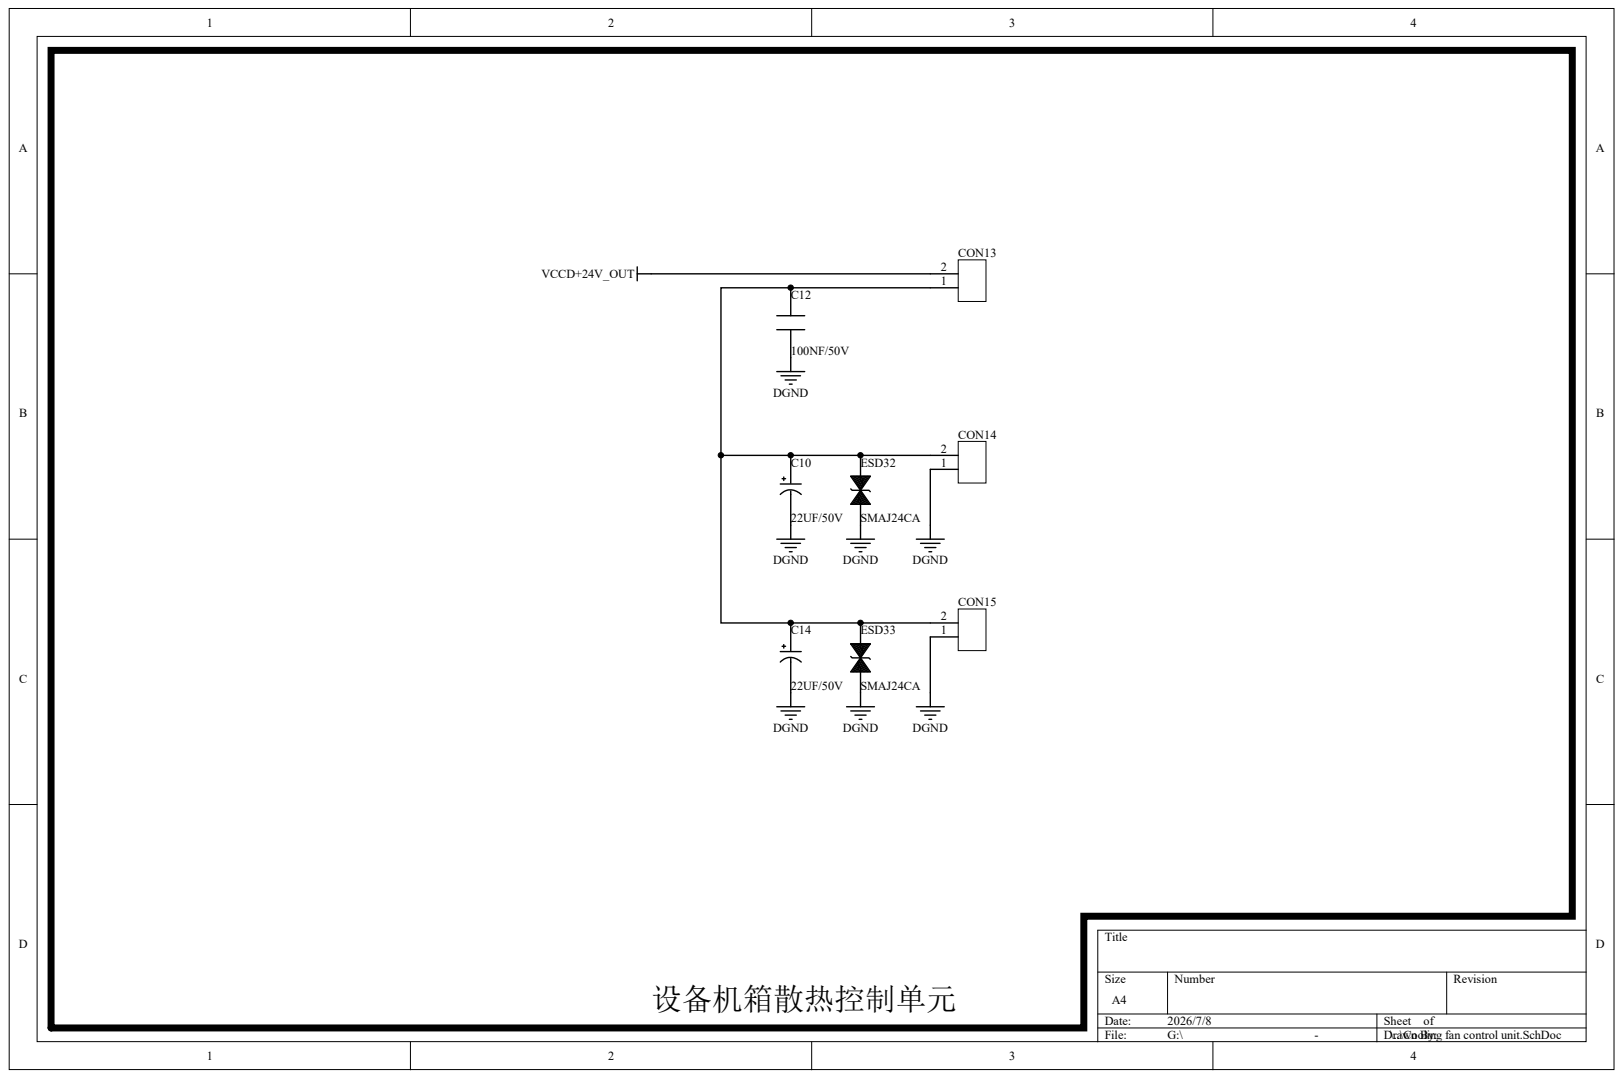
[picture p9: page 1]

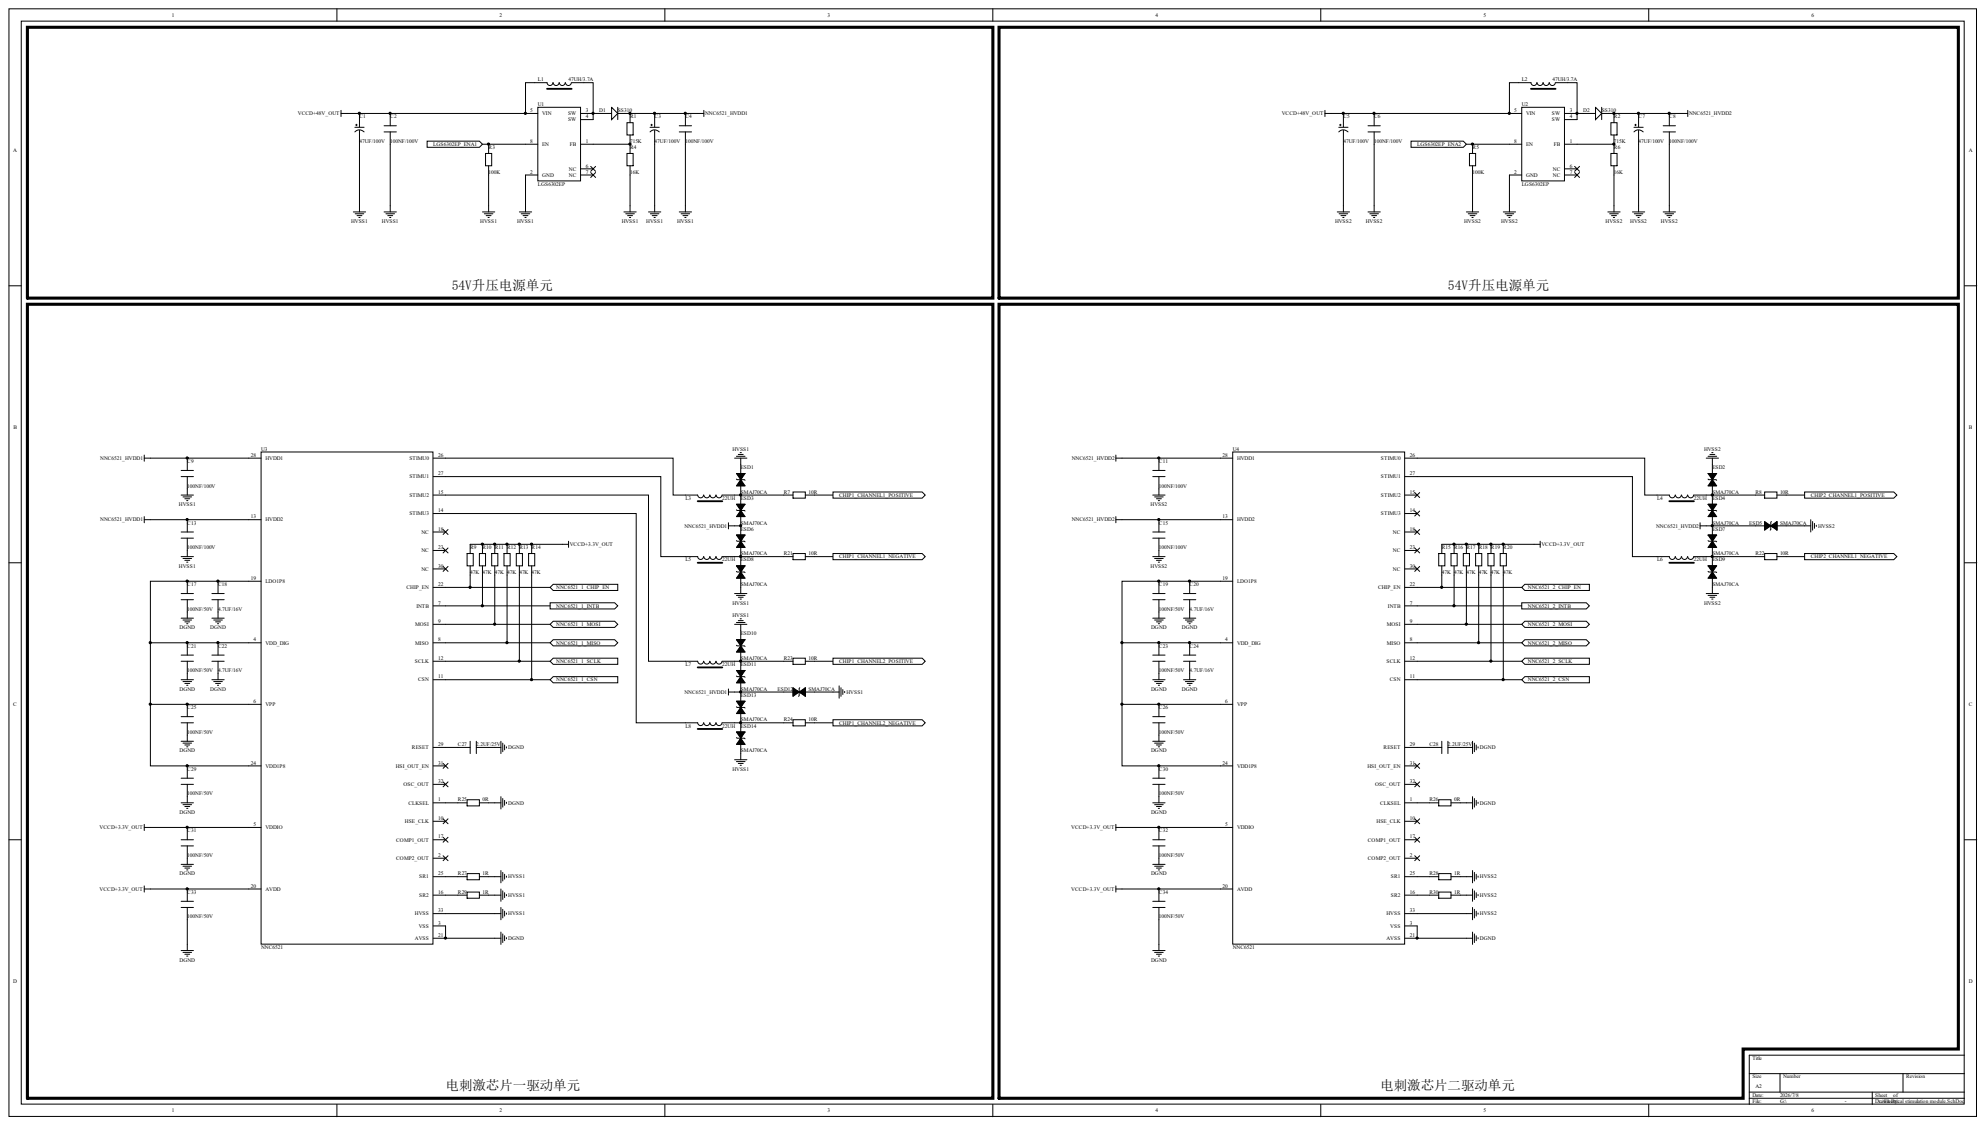
[picture p10: page 2]

Size A2 | Number | Revision

1 2 3 4 5 | File: G:\ -6 | D\.ra.\wEnlecBytri:cal stimulation module.SchDoc

Date: 2026/7/8 | Sheet of

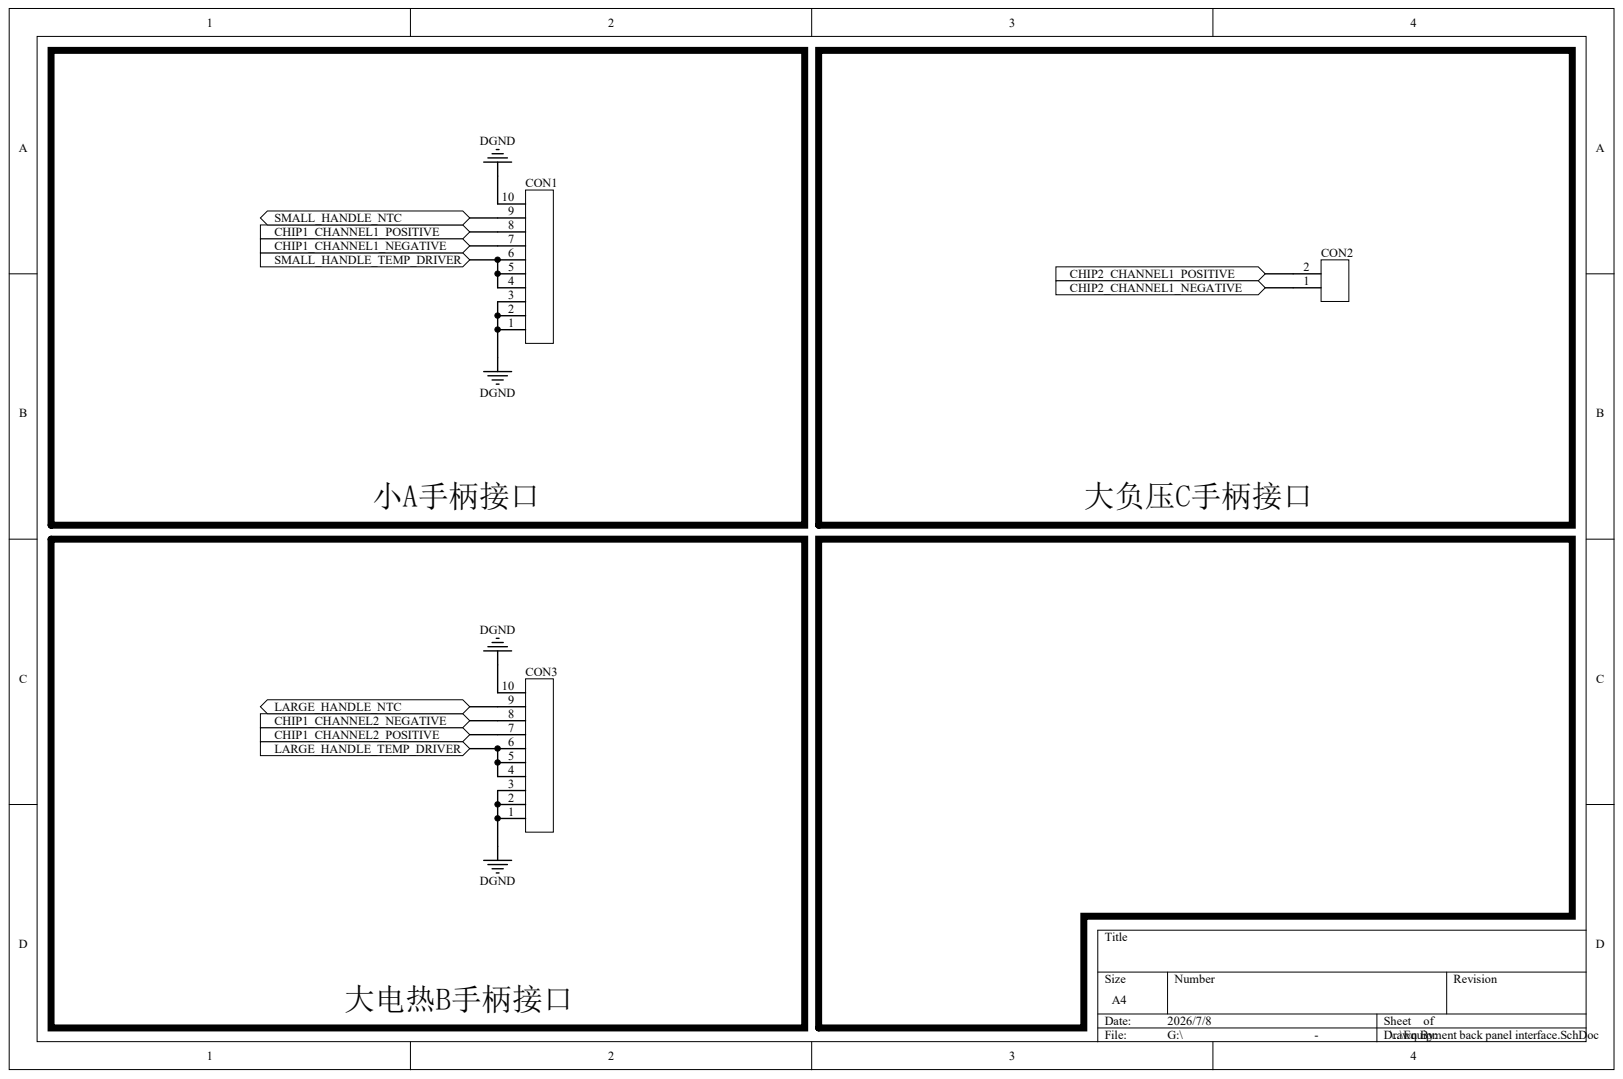
[picture p11: page 3]

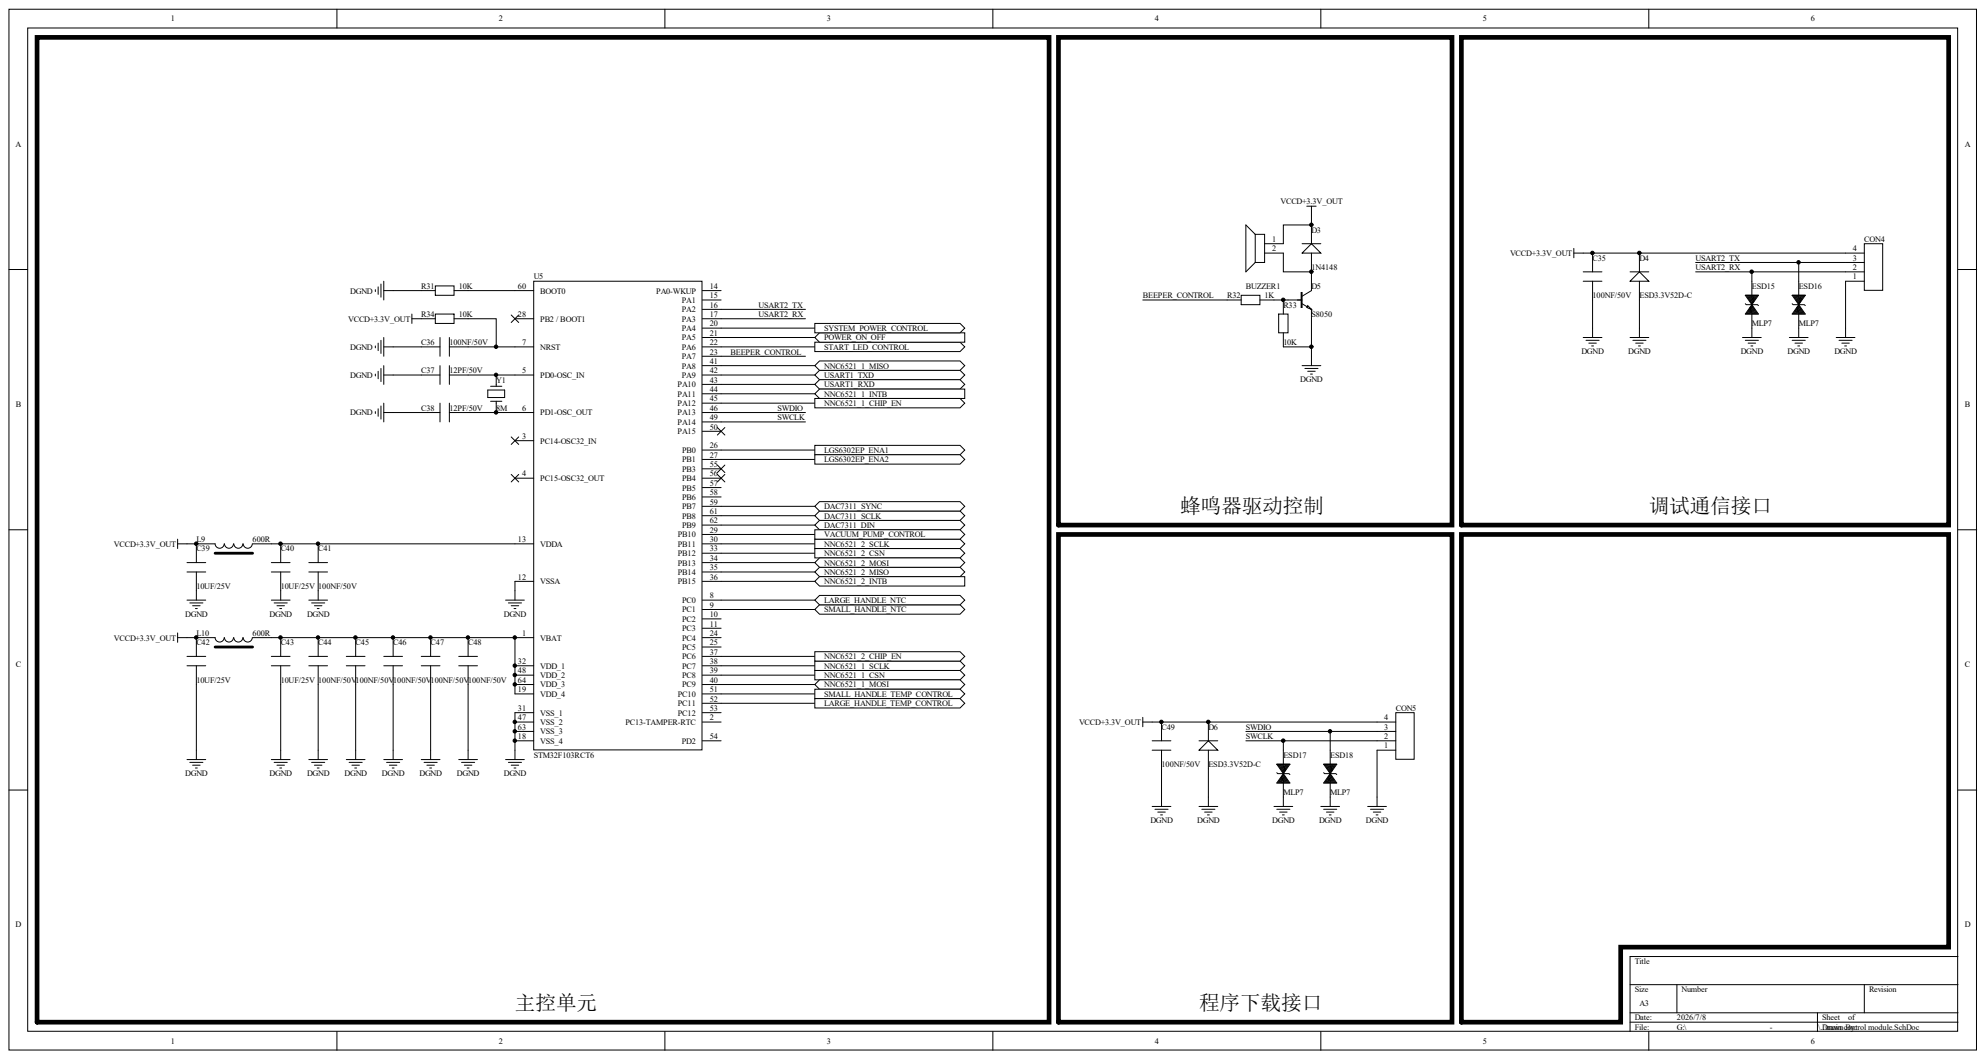
[picture p12: page 4]

S i z e A 3 | Numbe r | Re vi s i o n

D ate : 2026/7/8 | She et of
F ile : G : \ - | \..\Dmraawin cn Boyntr: ol module.S c hDoc

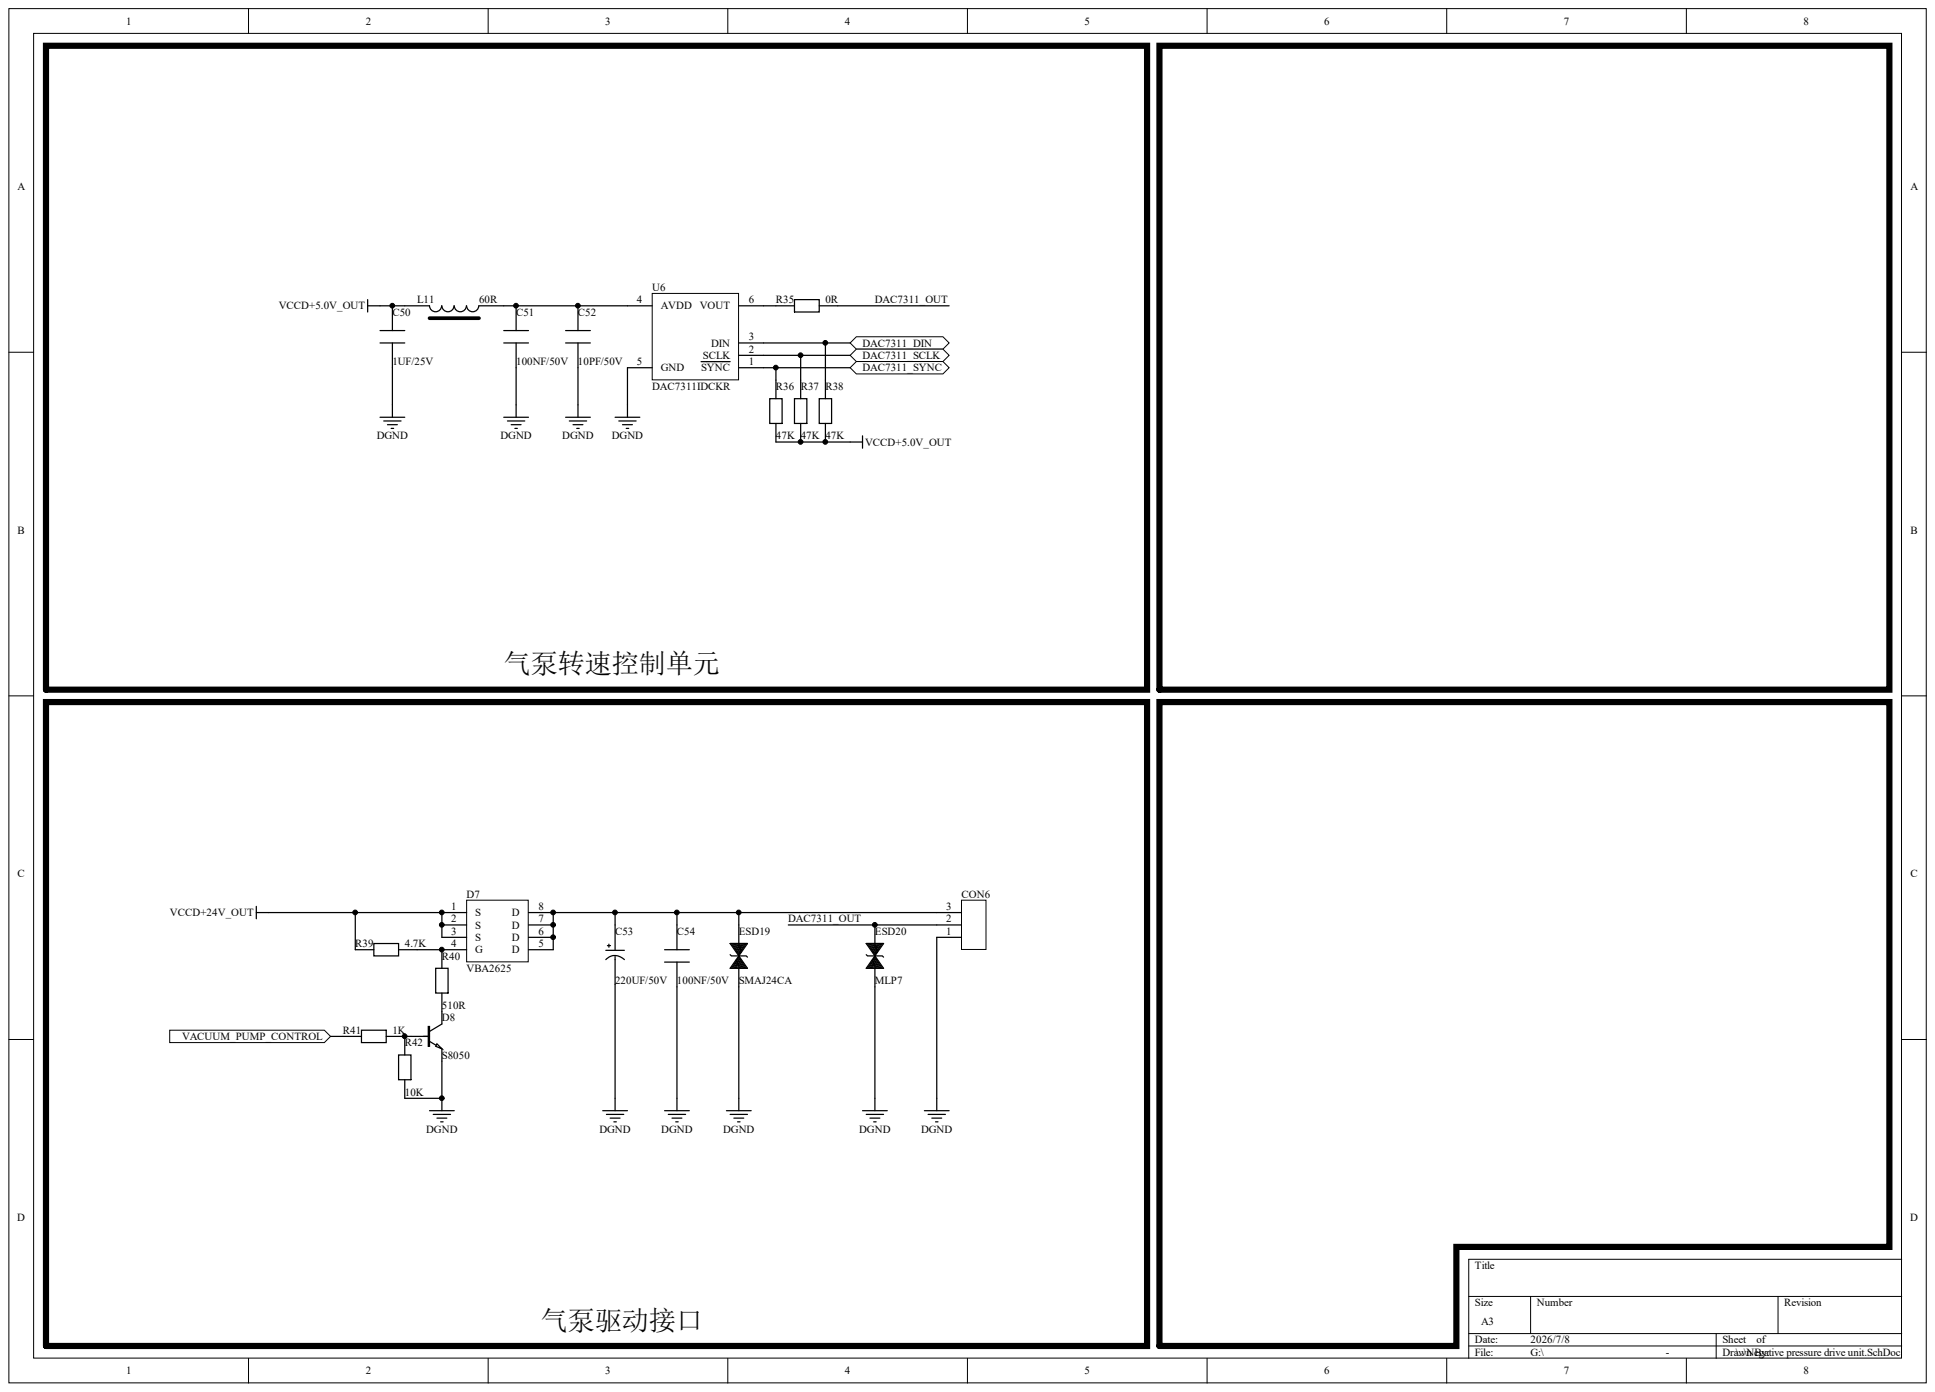
[picture p13: page 5]

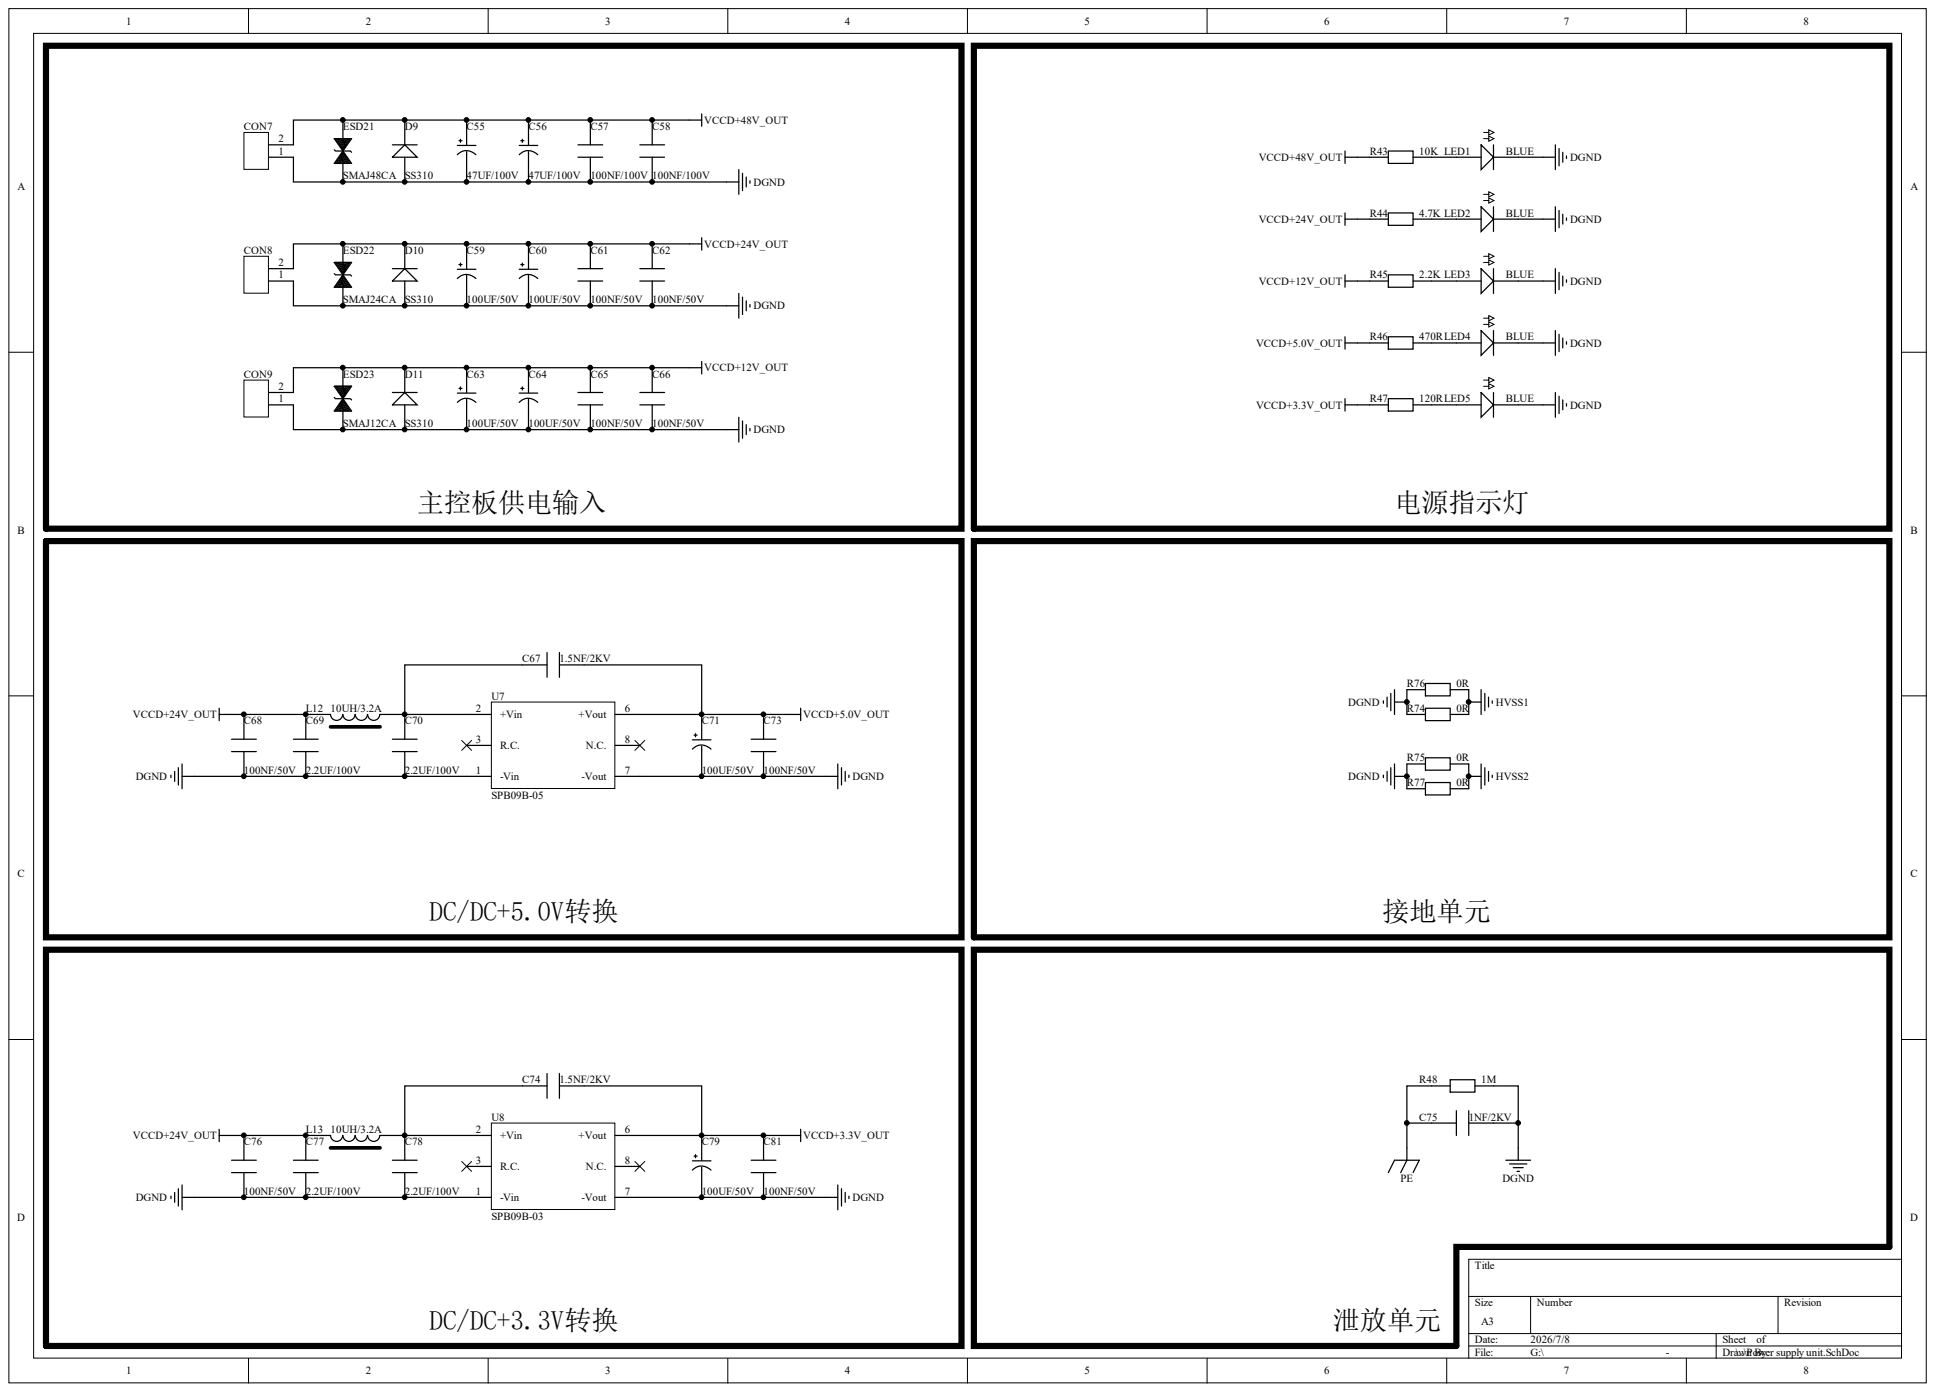
[picture p14: page 6]

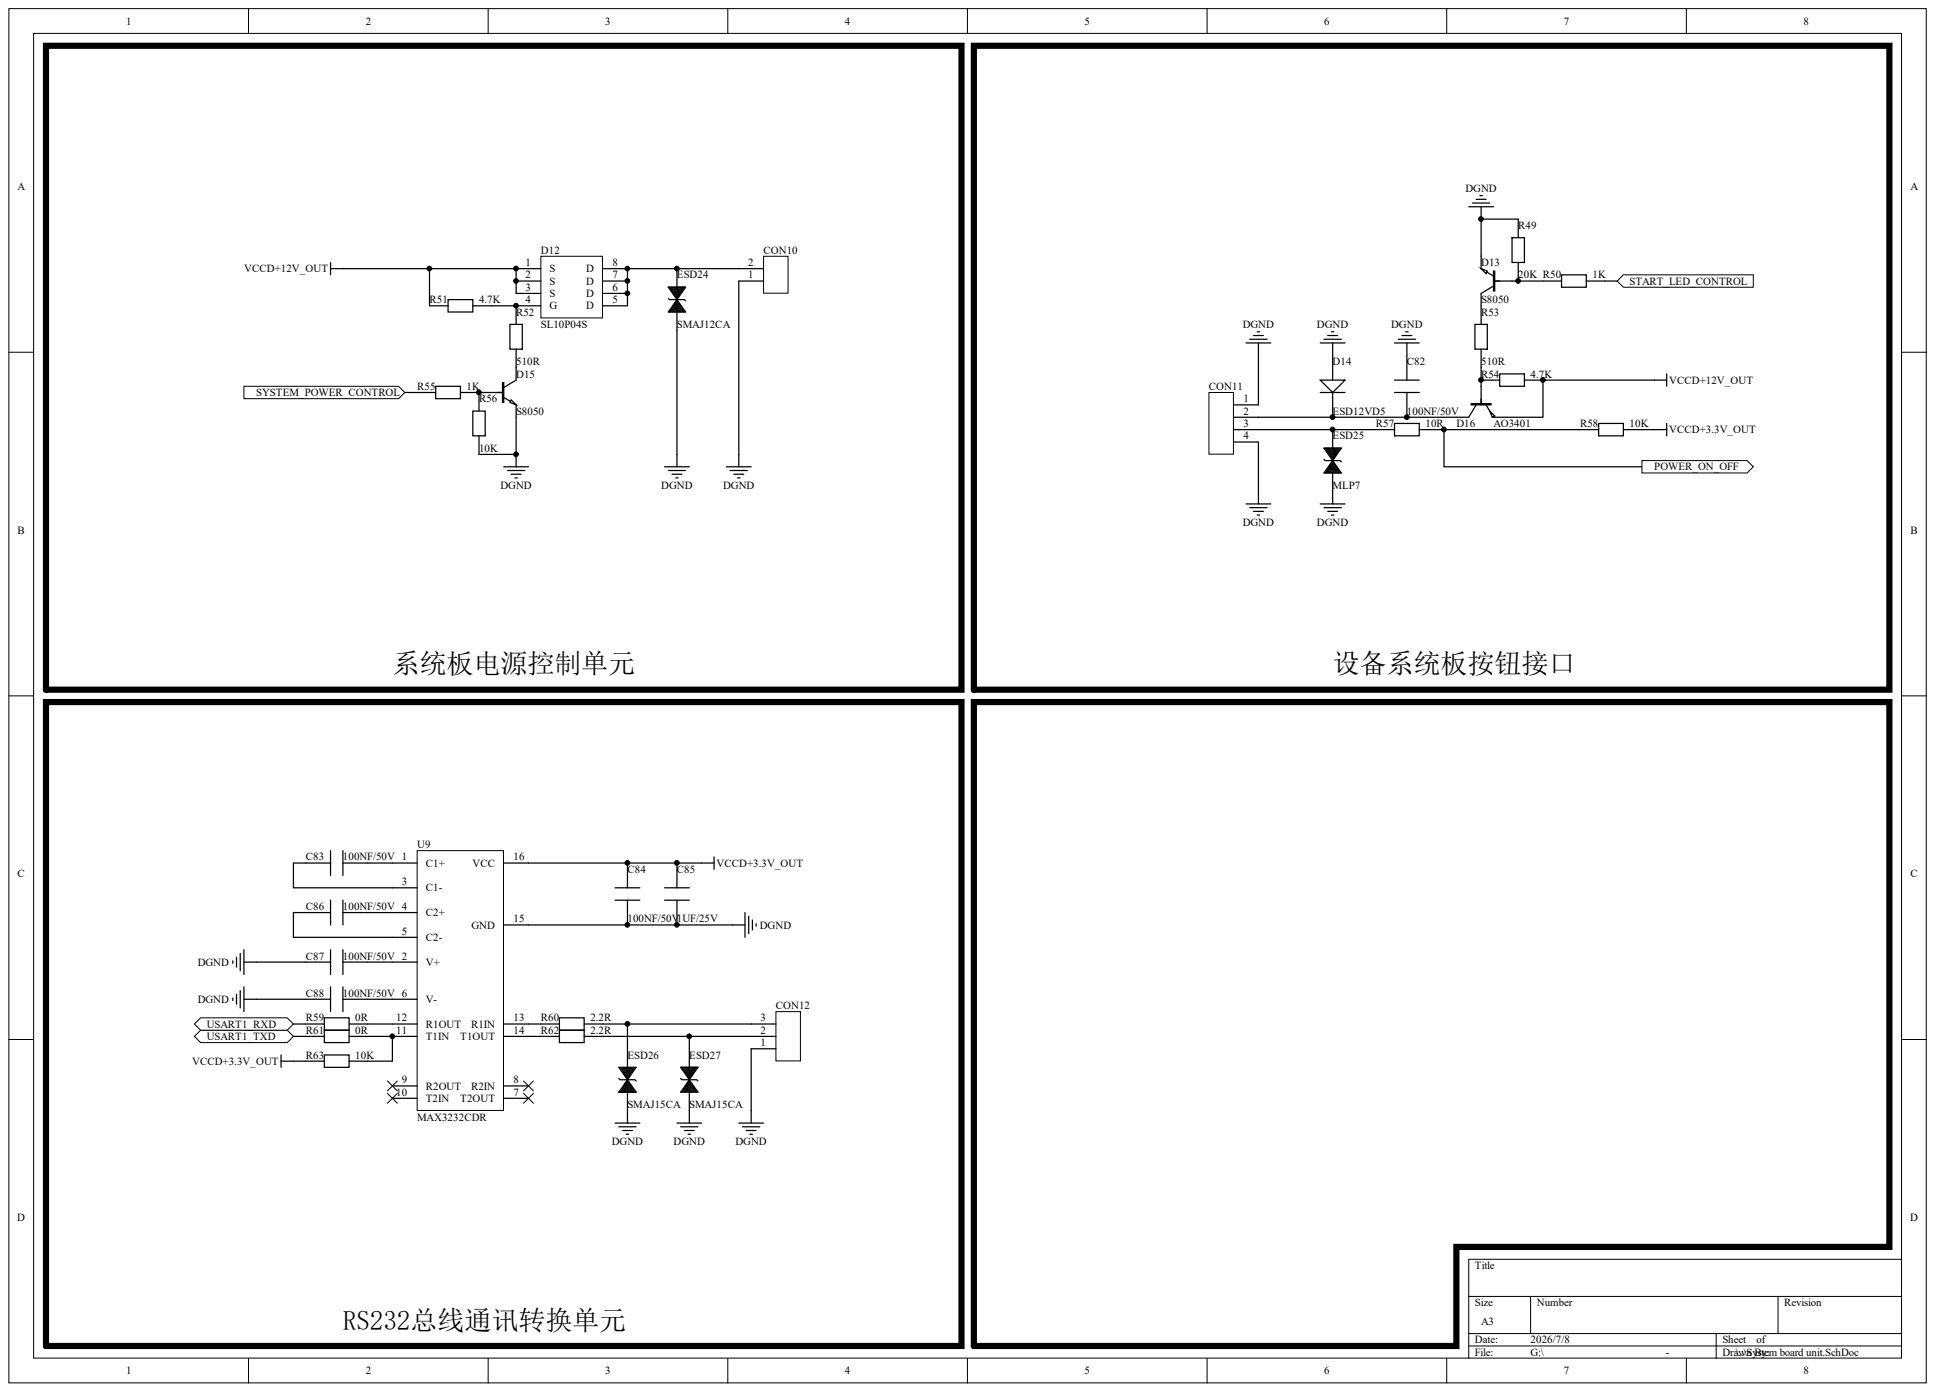
[picture p15: page 7]

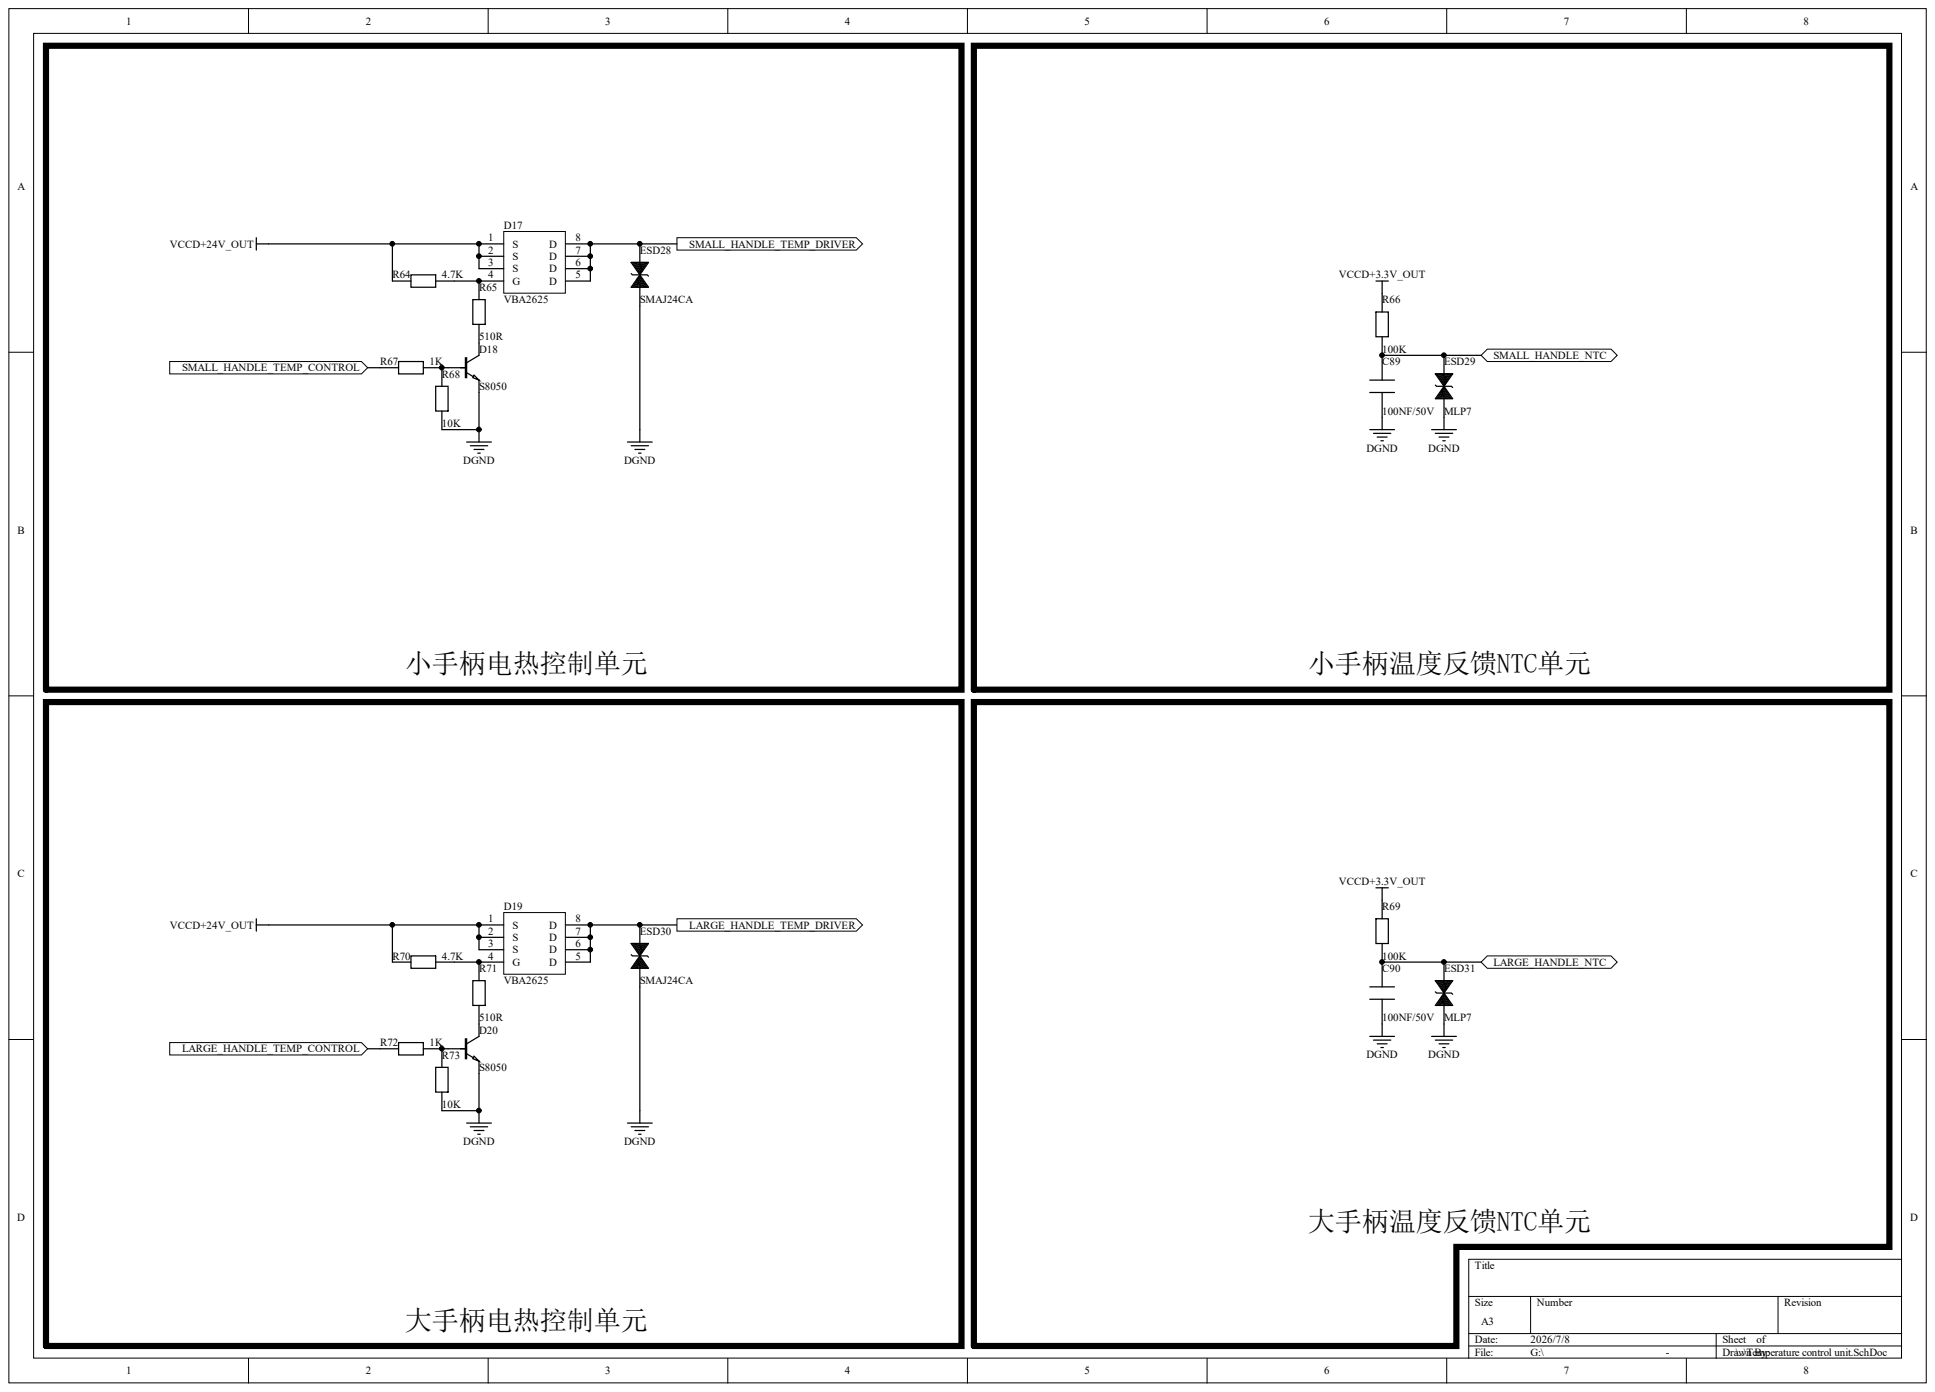
[picture p16: page 8]
