young-whites/microcurrent-beauty-device-v10/docs/通讯协议文档-简洁版.pdf

# 通讯协议简洁版 — 全指令速查

## 版本: V5.0 | 日期: 2026-07-31

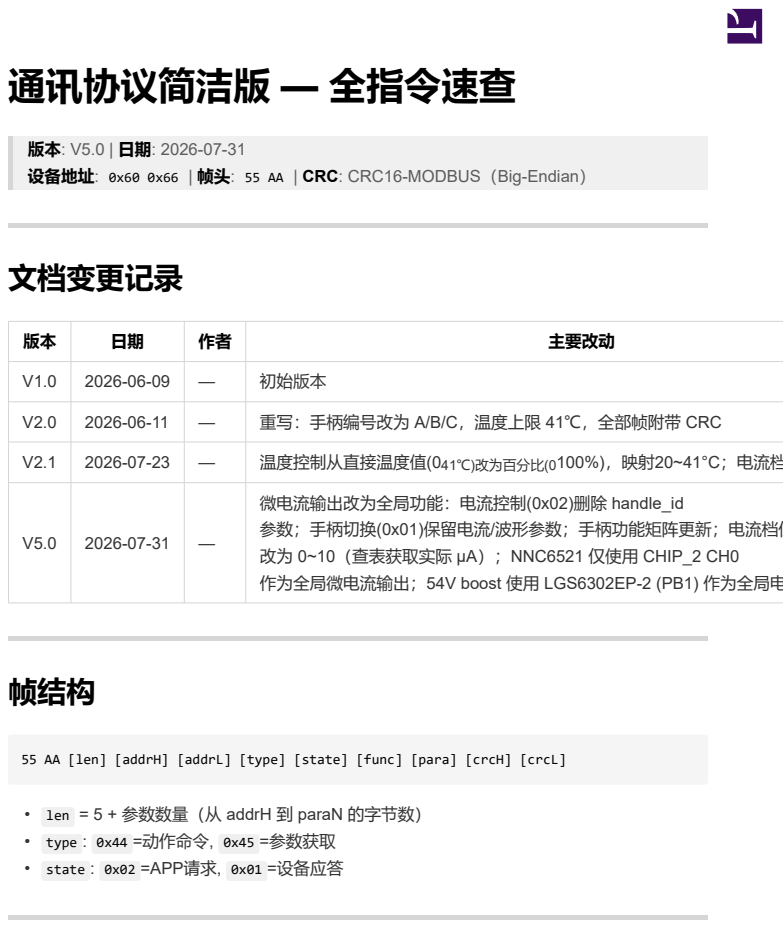
[picture p17: page 1]
文档变更记录; 主要改动; 初始版本; 重写：手柄编号改为 A/B/C，温度上限 41℃，全部帧附带 CRC; 温度控制从直接温度值(041℃)改为百分比(0100%)，映射20~41°C；电流档位映射表线性化; 帧结构

设备地址: 0x60 0x66 | 帧头: 55 AA | CRC: CRC16-MODBUS（Big-Endian）

微电流输出改为全局功能：电流控制(0x02)删除 handle_id
参数；手柄切换(0x01)保留电流/波形参数；手柄功能矩阵更新；电流档位范围从
改为 0~10（查表获取实际 μA）；NNC6521 仅使用 CHIP_2 CH0
作为全局微电流输出；54V boost 使用 LGS6302EP-2 (PB1) 作为全局电流供电

55 AA [len] [addrH] [addrL] [type] [state] [func] [para] [crcH] [crcL]

• len = 5 + 参数数量（从 addrH 到 paraN 的字节数）

• type : 0x44 =动作命令, 0x45 =参数获取

• state : 0x02 =APP请求, 0x01 =设备应答

# 全部指令汇总

# | 功能码 | 功能 | 参数 | 范围 | 适用范围

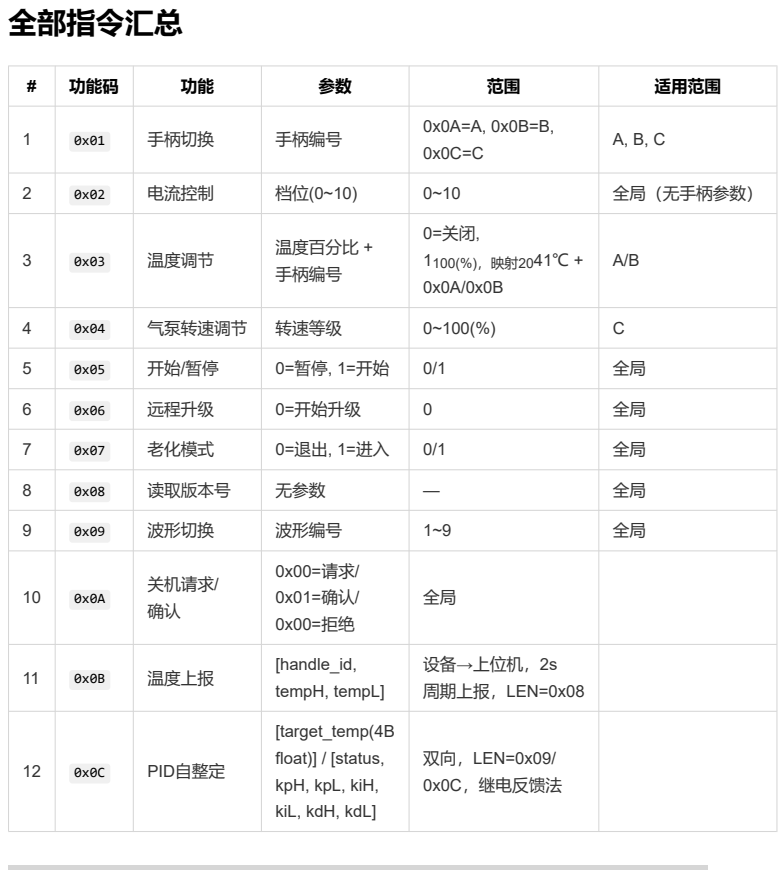
[picture p18: page 2]
手柄切换; 手柄编号; 电流控制; 全局（无手柄参数）; 温度调节; 温度百分比 +; 气泵转速调节; 转速等级; 远程升级; 0=开始升级; 老化模式; 读取版本号; 无参数; 波形切换; 波形编号; 关机请求/ 确认; 温度上报; [handle_id,; tempH, tempL]; 设备→上位机，2s 周期上报，LEN=0x08; PID自整定; 双向，LEN=0x09/ 0x0C，继电反馈法

[target_temp(4B
float)] / [status,
kpH, kpL, kiH,
kiL, kdH, kdL]

# 全部请求帧（APP→设备）

## state=0x02

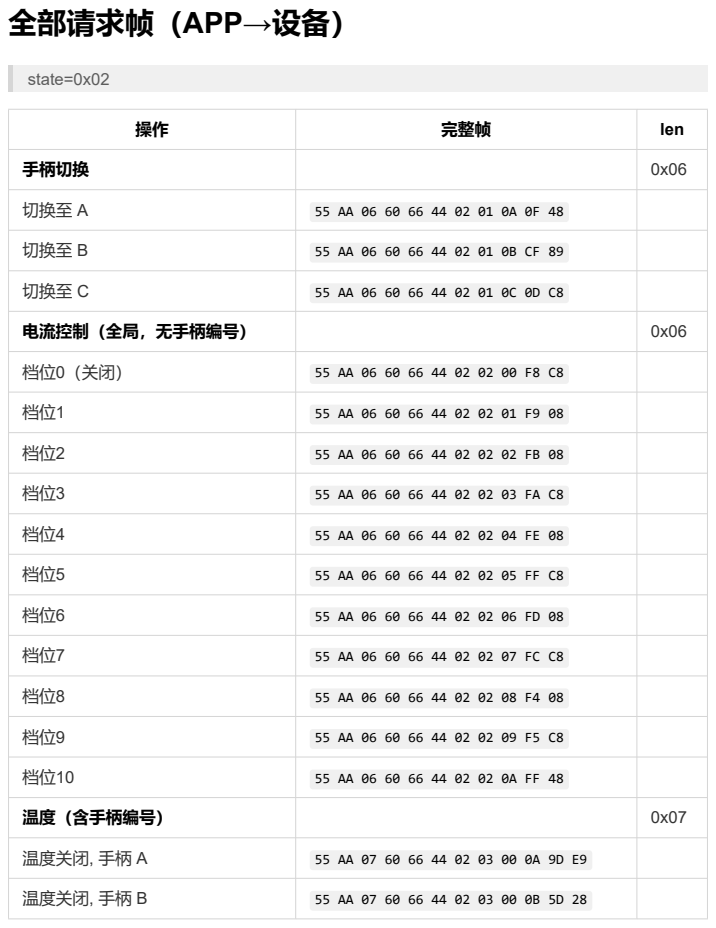
[picture p19: page 3]
完整帧; len; 手柄切换; 切换至 A; 切换至 B; 切换至 C; 电流控制（全局，无手柄编号）; 温度（含手柄编号）; 温度关闭, 手柄 A; 温度关闭, 手柄 B

操作 | 完整帧 | len

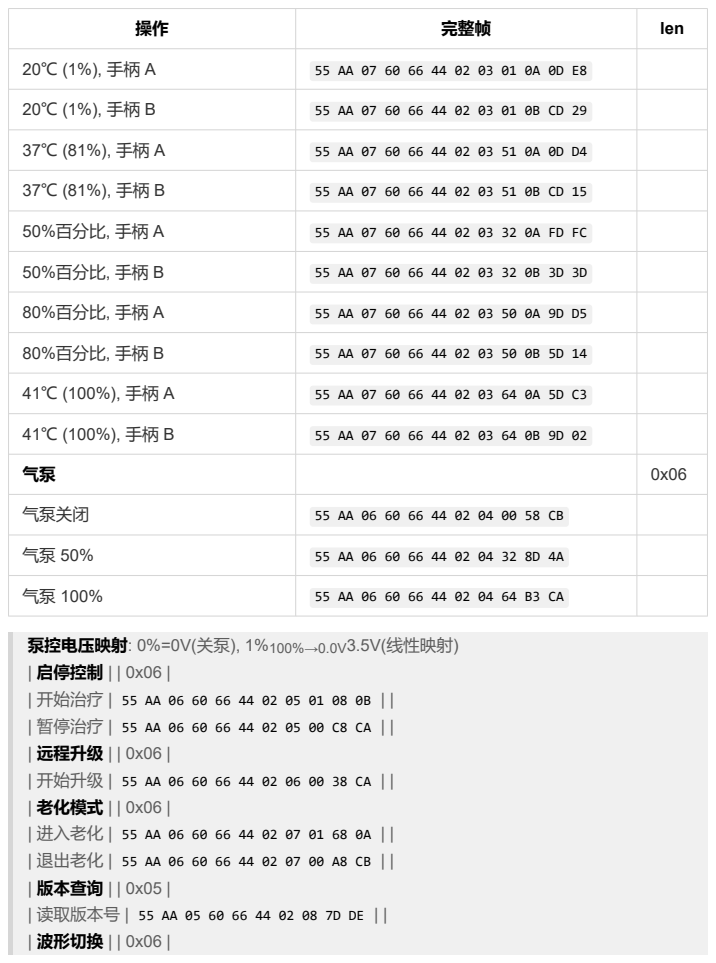
[picture p20: page 4]
50%百分比, 手柄 A; 50%百分比, 手柄 B; 80%百分比, 手柄 A; 80%百分比, 手柄 B; 气泵关闭; | 开始治疗 | 55 AA 06 60 66 44 02 05 01 08 0B | |; | 进入老化 | 55 AA 06 60 66 44 02 07 01 68 0A | |

泵控电压映射: 0%=0V(关泵), 1%100%→0.0V3.5V(线性映射)
启停控制 | | 0x06

暂停治疗 | 55 AA 06 60 66 44 02 05 00 C8 CA
远程升级 | | 0x06

开始升级 | 55 AA 06 60 66 44 02 06 00 38 CA
老化模式 | | 0x06

退出老化 | 55 AA 06 60 66 44 02 07 00 A8 CB
版本查询 | | 0x05

读取版本号 | 55 AA 05 60 66 44 02 08 7D DE
波形切换 | | 0x06

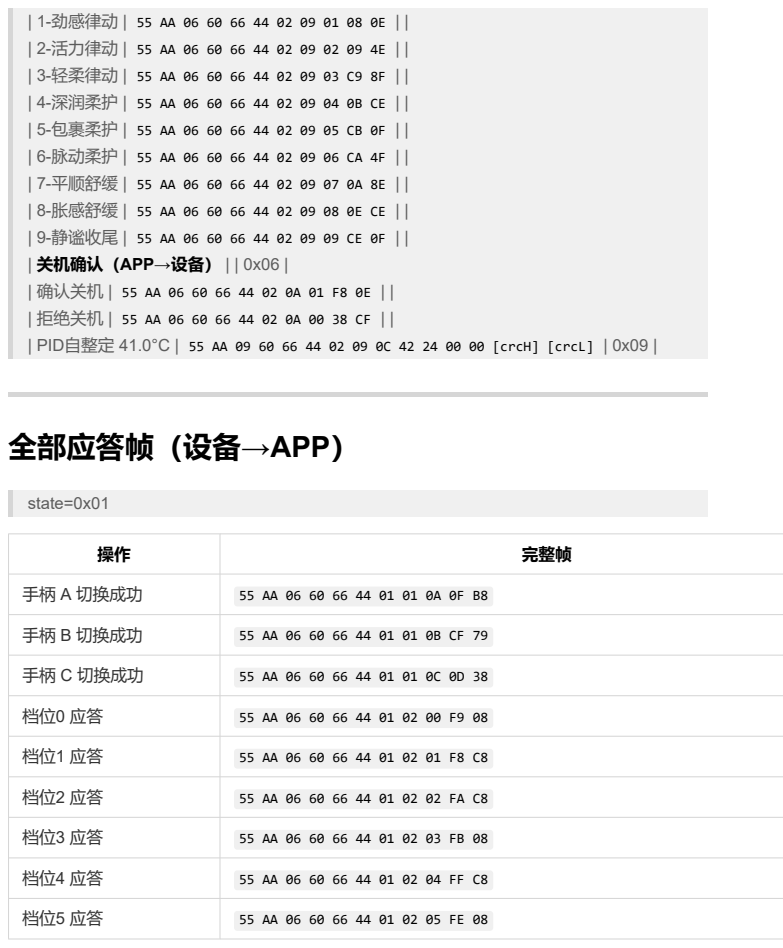
[picture p21: page 5]
| 1-劲感律动 | 55 AA 06 60 66 44 02 09 01 08 0E | |; | 2-活力律动 | 55 AA 06 60 66 44 02 09 02 09 4E | |; | 3-轻柔律动 | 55 AA 06 60 66 44 02 09 03 C9 8F | |; | 7-平顺舒缓 | 55 AA 06 60 66 44 02 09 07 0A 8E | |; | 确认关机 | 55 AA 06 60 66 44 02 0A 01 F8 0E | |; state=0x01; 完整帧; 手柄 A 切换成功; 手柄 B 切换成功; 手柄 C 切换成功

4-深润柔护 | 55 AA 06 60 66 44 02 09 04 0B CE

5-包裹柔护 | 55 AA 06 60 66 44 02 09 05 CB 0F

6-脉动柔护 | 55 AA 06 60 66 44 02 09 06 CA 4F

8-胀感舒缓 | 55 AA 06 60 66 44 02 09 08 0E CE

9-静谧收尾 | 55 AA 06 60 66 44 02 09 09 CE 0F
关机确认（APP→设备） | | 0x06

拒绝关机 | 55 AA 06 60 66 44 02 0A 00 38 CF

PID自整定 41.0°C | 55 AA 09 60 66 44 02 09 0C 42 24 00 00 [crcH] [crcL] | 0x09

全部应答帧（设备→APP）

操作 | 完整帧

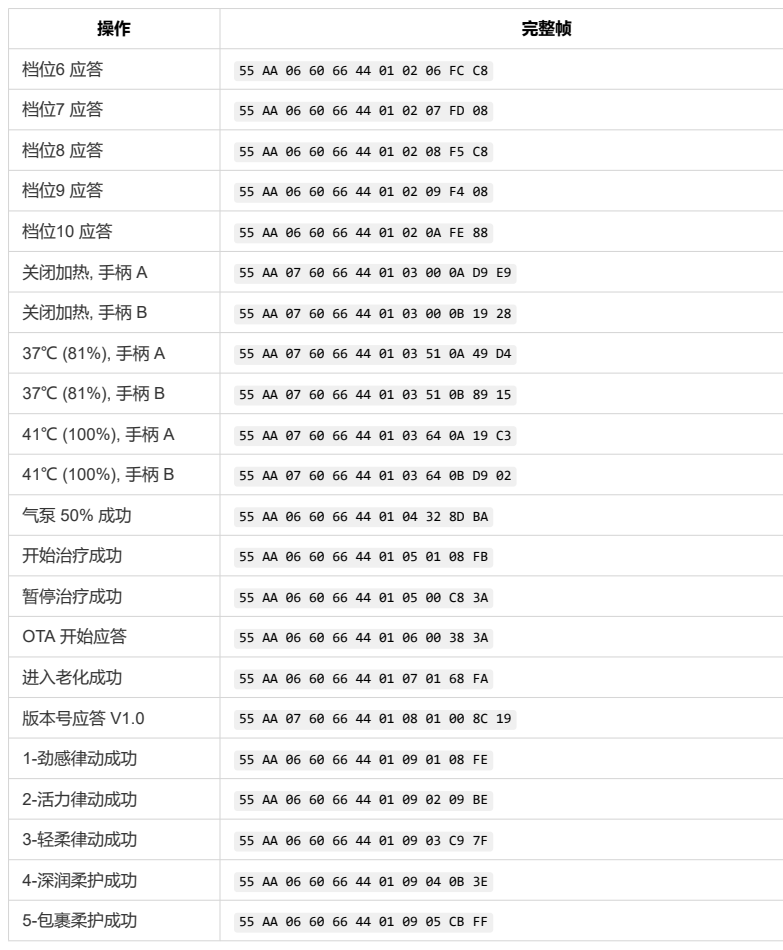
[picture p22: page 6]
关闭加热, 手柄 A; 关闭加热, 手柄 B; 开始治疗成功; 暂停治疗成功; OTA 开始应答; 进入老化成功; 版本号应答 V1.0; 1-劲感律动成功; 2-活力律动成功; 3-轻柔律动成功; 4-深润柔护成功; 5-包裹柔护成功

操作 | 完整帧

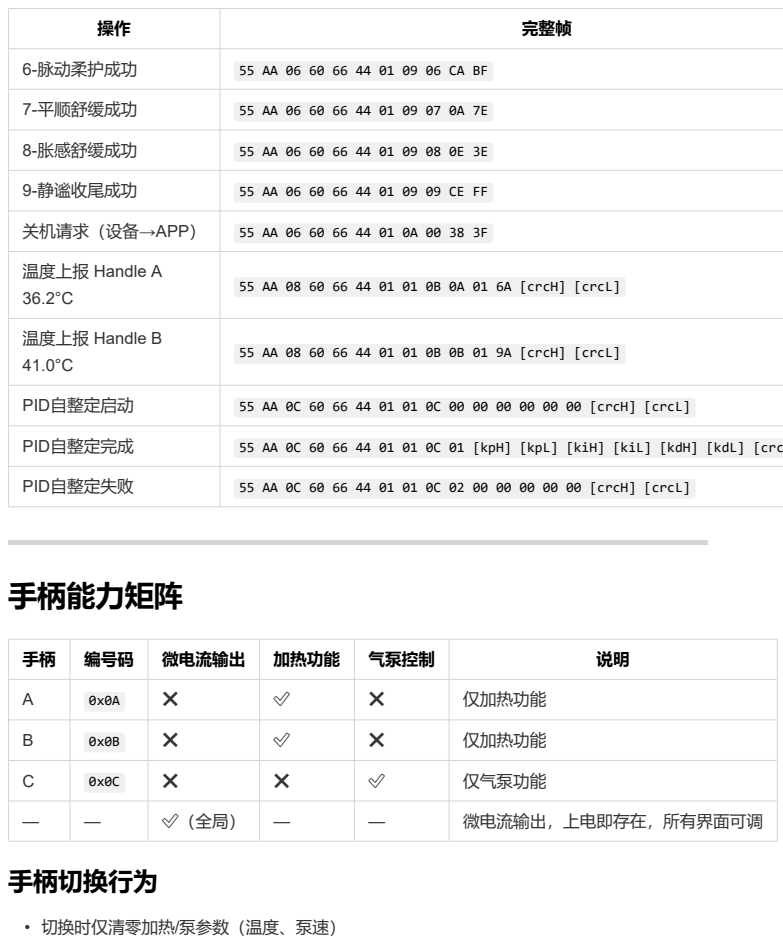
[picture p23: page 7]
6-脉动柔护成功; 7-平顺舒缓成功; 8-胀感舒缓成功; 9-静谧收尾成功; 关机请求（设备→APP）; 温度上报 Handle A; 温度上报 Handle B; PID自整定启动; 55 AA 0C 60 66 44 01 01 0C 00 00 00 00 00 00 [crcH] [crcL]; PID自整定完成; 55 AA 0C 60 66 44 01 01 0C 01 [kpH] [kpL] [kiH] [kiL] [kdH] [kdL] [crcH] [crcL]; PID自整定失败; 55 AA 0C 60 66 44 01 01 0C 02 00 00 00 00 00 [crcH] [crcL]; 手柄能力矩阵; 编号码; 微电流输出; 加热功能; 气泵控制; 仅加热功能; 仅气泵功能; 微电流输出，上电即存在，所有界面可调; 手柄切换行为

55 AA 08 60 66 44 01 01 0B 0A 01 6A [crcH] [crcL]

55 AA 08 60 66 44 01 01 0B 0B 01 9A [crcH] [crcL]

• 切换时仅清零加热/泵参数（温度、泵速）

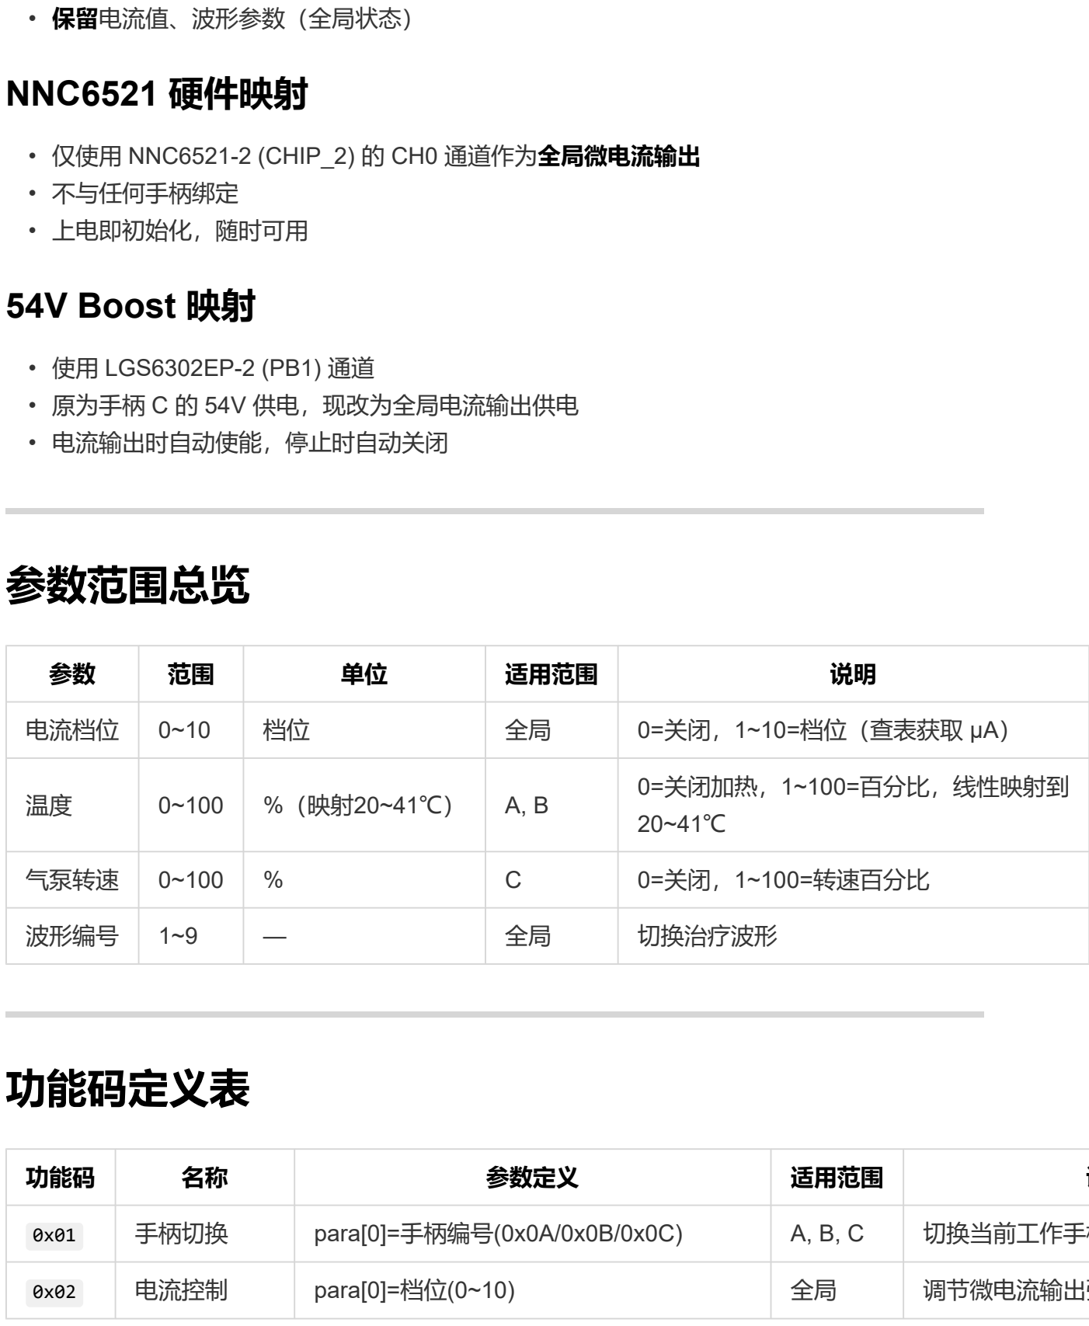
[picture p24: figure]
• 保留电流值、波形参数（全局状态）; NNC6521 硬件映射; • 不与任何手柄绑定 • 上电即初始化，随时可用; 54V Boost 映射; • 使用 LGS6302EP-2 (PB1) 通道 • 原为手柄 C 的 54V 供电，现改为全局电流输出供电 • 电流输出时自动使能，停止时自动关闭; 参数范围总览; 适用范围; 电流档位; 0=关闭，1~10=档位（查表获取 μA）; 0=关闭加热，1~100=百分比，线性映射到 20~41℃; 气泵转速; 0=关闭，1~100=转速百分比; 波形编号; 切换治疗波形; 功能码定义表; 功能码; 参数定义

## - 仅使用 NNC6521-2 (CHIP_2) 的 CH0 通道作为全局微电流输出

0x01 | 手柄切换 | para[0]=手柄编号(0x0A/0x0B/0x0C) | A, B, C | 切换当前工作手柄
0x02 | 电流控制 | para[0]=档位(0~10) | 全局 | 调节微电流输出强度，无手柄参数

功能码 | 名称 | 参数定义 | 适用范围 | 说明
0x03 | 温度调节 | para[0]=温度百分比(0~100),

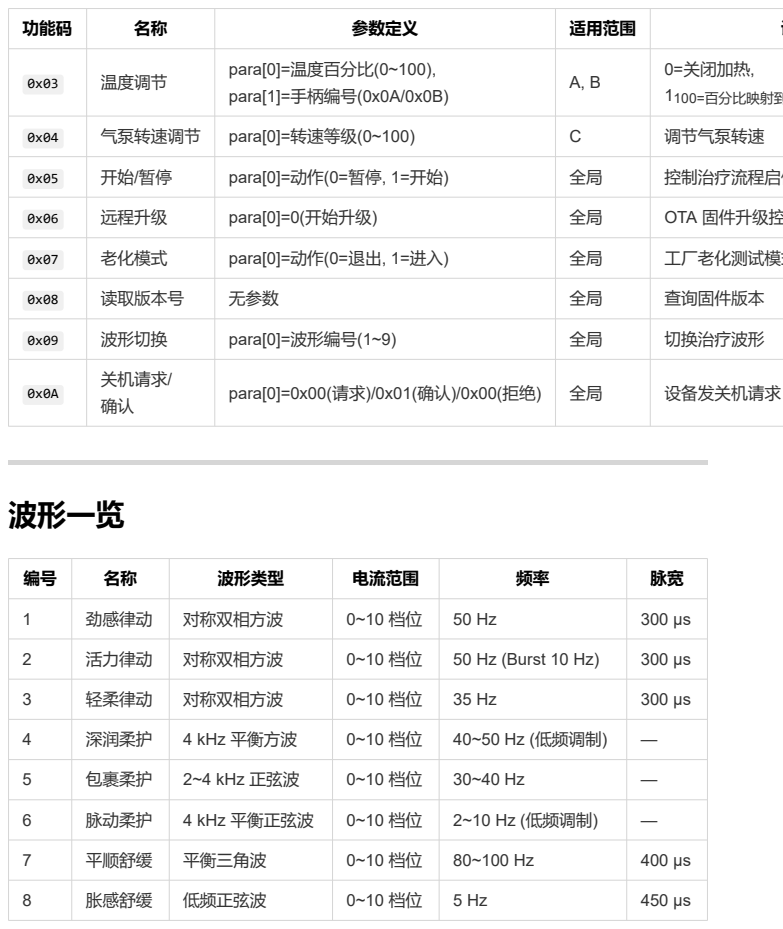
[picture p25: page 9]
para[1]=手柄编号(0x0A/0x0B); 0=关闭加热,; 1100=百分比映射到20; 气泵转速调节; para[0]=转速等级(0~100); 调节气泵转速; para[0]=动作(0=暂停, 1=开始); 控制治疗流程启停; 远程升级; para[0]=0(开始升级); OTA 固件升级控制; 老化模式; para[0]=动作(0=退出, 1=进入); 工厂老化测试模式; 读取版本号; 无参数; 查询固件版本; 波形切换; para[0]=波形编号(1~9); 切换治疗波形; 关机请求/; para[0]=0x00(请求)/0x01(确认)/0x00(拒绝); 设备发关机请求，上位机确认或拒绝; 波形一览; 波形类型; 电流范围; 劲感律动; 对称双相方波; 活力律动; 50 Hz (Burst 10 Hz); 轻柔律动; 深润柔护; 4 kHz 平衡方波; 40~50 Hz (低频调制); 包裹柔护; 2~4 kHz 正弦波; 脉动柔护; 4 kHz 平衡正弦波; 2~10 Hz (低频调制); 平顺舒缓; 平衡三角波; 胀感舒缓; 低频正弦波

编号 | 名称 | 波形类型 | 电流范围 | 频率 | 脉宽
9 | 静谧收尾 | 低频正弦波 | 0~10 档位 | 10 Hz | —

# 时序约束

约束项 | 值
请求-应答超时 | 500 ms
最小发送间隔 | 50 ms
最大重发次数 | 3 次
设备初始化时间 | 1000 ms

# 错误码

| 错误码 | | | 含义
0x00 | | 成功
0x01 | | 参数错误
0x02 | 不支持的功能码
0x03 | | 设备忙
0xFF | | 未知错误

# CRC 验证记录（设备地址 0x6066）

# | 帧描述 | len | CRC 结果 | 验证状态

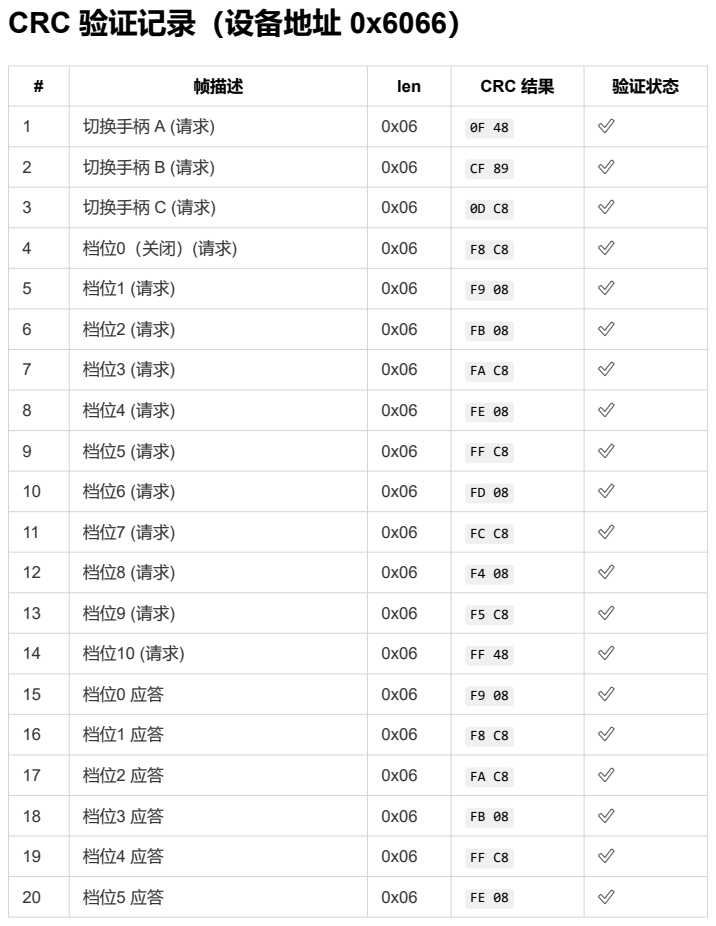
[picture p26: page 11]
切换手柄 A (请求); 切换手柄 B (请求); 切换手柄 C (请求)

# | 帧描述 | len | CRC 结果 | 验证状态

21 | 档位6 应答 | 0x06 | FC C8 | ✅

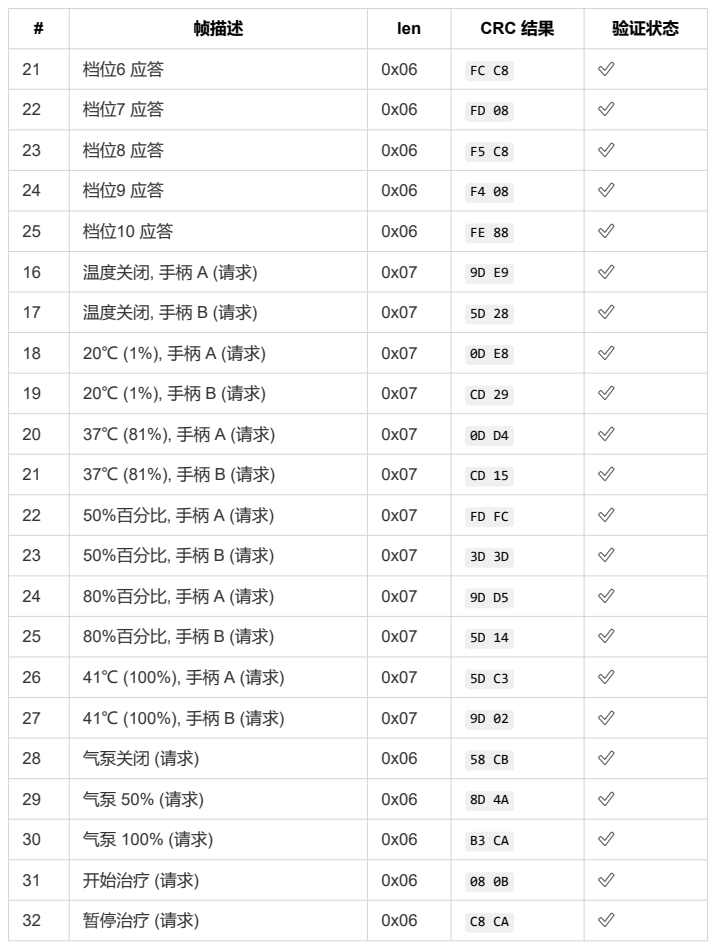
[picture p27: page 12]
温度关闭, 手柄 A (请求); 温度关闭, 手柄 B (请求); 50%百分比, 手柄 A (请求); 50%百分比, 手柄 B (请求); 80%百分比, 手柄 A (请求); 80%百分比, 手柄 B (请求); 气泵关闭 (请求); 开始治疗 (请求); 暂停治疗 (请求)

# | 帧描述 | len | CRC 结果 | 验证状态

33 | OTA 开始 (请求) | 0x06 | 38 CA | ✅

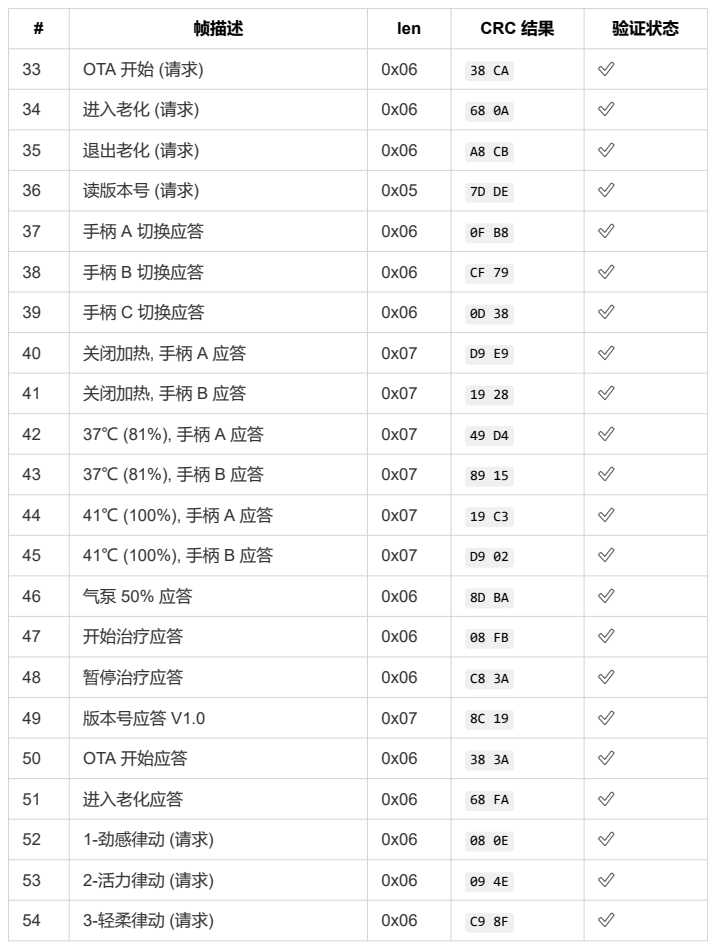
[picture p28: page 13]
进入老化 (请求); 退出老化 (请求); 读版本号 (请求); 手柄 A 切换应答; 手柄 B 切换应答; 手柄 C 切换应答; 关闭加热, 手柄 A 应答; 关闭加热, 手柄 B 应答; 开始治疗应答; 暂停治疗应答; 版本号应答 V1.0; OTA 开始应答; 进入老化应答; 1-劲感律动 (请求); 2-活力律动 (请求); 3-轻柔律动 (请求)

# | 帧描述 | len | CRC 结果 | 验证状态

55 | 4-深润柔护 (请求) | 0x06 | 0B CE | ✅

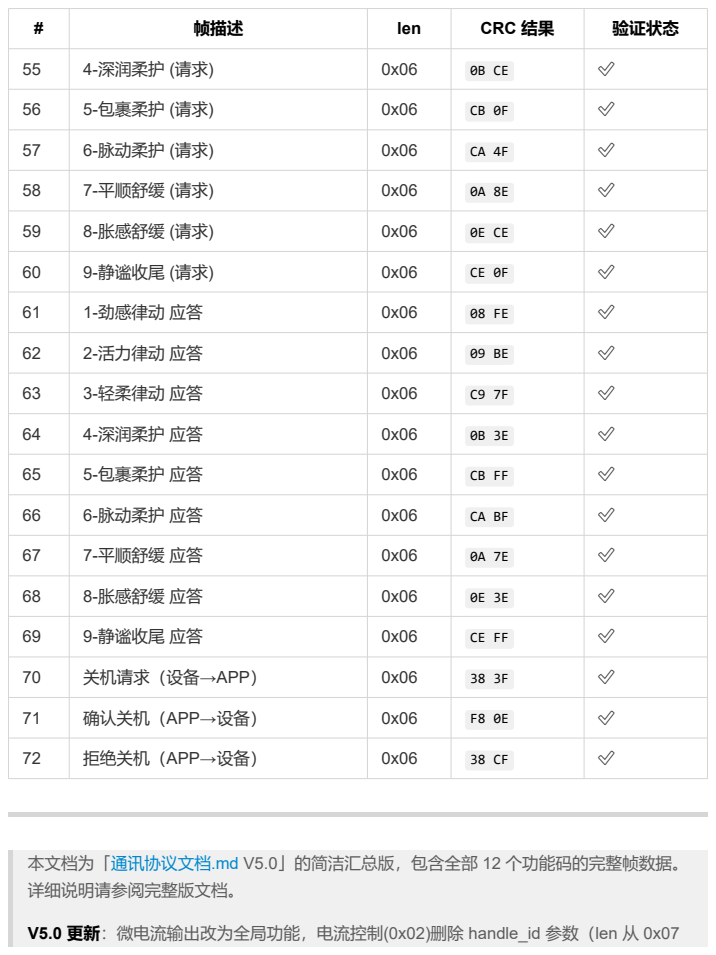
[picture p29: page 14]
5-包裹柔护 (请求); 6-脉动柔护 (请求); 7-平顺舒缓 (请求); 8-胀感舒缓 (请求); 9-静谧收尾 (请求); 1-劲感律动 应答; 2-活力律动 应答; 3-轻柔律动 应答; 4-深润柔护 应答; 5-包裹柔护 应答; 6-脉动柔护 应答; 7-平顺舒缓 应答; 8-胀感舒缓 应答; 9-静谧收尾 应答; 关机请求（设备→APP）; 确认关机（APP→设备）; 拒绝关机（APP→设备）

本文档为「通讯协议文档.md (http://xn--ykrw73b06bsy0dda998d.md/) V5.0」的简洁汇总版，包含全部 12 个功能码的完整帧数据。
详细说明请参阅完整版文档。

V5.0 更新：微电流输出改为全局功能，电流控制(0x02)删除 handle_id 参数（len 从 0x07

## 改为 0x06），手柄切换(0x01)保留电流/波形参数，手柄功能矩阵更新。电流档位范围从

## 0~80 改为 0~10（查表获取实际 μA）。NNC6521 仅使用 CHIP_2 CH0 作为全局微电流输 出，54V boost 使用 LGS6302EP-2 (PB1) 作为全局电流供电。

CRC 算法：CRC16-MODBUS（poly=0x8005, init=0xFFFF, RefIn=True, RefOut=True,

## XorOut=0x0000），高字节在前。
