young-whites/microcurrent-beauty-device-v10/workItem-djm-v10-LTS/applications/macBSP/Src/nnc6521_waveform.c

/**
  ******************************************************************************
  * @file    nnc6521_waveform.c
  * @brief   NNC6521 preloaded waveform data arrays.
  *          Sine, triangle, pulse, and custom user waveforms.
  *          All comments in English.
  ******************************************************************************
  */

#include "nnc6521.h"

/* 16-point sine waveform ----------------------------------------------------*/
float normalized_sine_waveform_16[16] =
{
    0.000000, 0.195090, 0.382683, 0.555570, 0.707107, 0.831470, 0.923880, 0.980785,
    1.000000, 0.980785, 0.923880, 0.831470, 0.707107, 0.555570, 0.382683, 0.000000
};

/* 64-point sine waveform (full + split halves) -----------------------------*/
float normalized_sine_waveform_64[64] =
{
     0.000000, 0.049068, 0.098017, 0.146730, 0.195090, 0.242980, 0.290285, 0.336890,
    0.382683, 0.427555, 0.471397, 0.514103, 0.555570, 0.595699, 0.634393, 0.671559,
    0.707107, 0.740951, 0.773010, 0.803208, 0.831470, 0.857729, 0.881921, 0.903989,
    0.923880, 0.941544, 0.956940, 0.970031, 0.980785, 0.989177, 0.995185, 0.998795,
    1.000000, 0.998795, 0.995185, 0.989177, 0.980785, 0.970031, 0.956940, 0.941544,
    0.923880, 0.903989, 0.881921, 0.857729, 0.831470, 0.803208, 0.773010, 0.740951,
    0.707107, 0.671559, 0.634393, 0.595699, 0.555570, 0.514103, 0.471397, 0.427555,
    0.382683, 0.336890, 0.290285, 0.242980, 0.195090, 0.146730, 0.098017, 0.049068
};
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
    0.750000f, 0.718750f, 0.687500f, 0.656250f, 0.625000f, 0.593750f, 0.562500f, 0.531250f,
    0.500000f, 0.468750f, 0.437500f, 0.406250f, 0.375000f, 0.343750f, 0.312500f, 0.281250f,
    0.250000f, 0.218750f, 0.187500f, 0.156250f, 0.125000f, 0.087891f, 0.039062f, 0.009766f
};
