young-whites/microcurrent-beauty-device-v10/(commit log)

2026-06-11 docs: 重写通讯协议文档V2.0 - 修正设备地址/波特率/手柄编号/温度上限，全部帧附带已验证CRC
    [kconfig-language.txt, kconfig.txt]
2026-06-11 docs: 通讯协议V2.1 - 补充DEVICE_ID/VERSION宏定义，标注设备地址差异待确认
2026-06-11 docs: 通讯协议V2.2 - 修正DEVICE_ID_L=0x70，补充FRAME_TYPE/STATE宏定义，地址字段与帧示例统一
2026-06-11 docs: 通讯协议V3.0 - 设备地址修正为0x6066，全部帧CRC重新计算，概要文档同步更新
2026-06-11 docs: 通讯协议V4.0 - 修正len字段计算规则(含地址2字节)，全部CRC重新计算验证
2026-06-11 docs: 更新通讯协议范本 - 修正len字段计算规则，补充宏定义章节，帧结构与实际协议对齐
2026-06-12 docs: NTC温度传感器参考表迁移至项目需求文档，通讯协议文档只保留通讯相关内容
2026-06-12 feat: integrate NNC6521 dual-chip driver with software SPI
    - Add drivers/nnc6521/ directory with 5 source files
    - Software SPI (GPIO bit-bang) for both chips
    - Chip 1: PC9/PC8/PC7/PA12/PA11/PA8
    - Chip 2: PB13/PB12/PB11/PC6/PB15/PB14
    - Preserve original NNC6521 register protocol and calibration
    - Adapted from ens1p4.c/h reference implementation
2026-06-15 docs: 添加通讯协议文档简洁版（全指令速查）
2026-06-15 docs: 通讯协议V4.2 - 电流能量/温度指令新增手柄编号字节，CRC重新计算
2026-06-15 docs: 远程升级指令简化为仅保留开始升级，删除确认/取消
2026-06-15 docs: 通讯协议V4.3 - 新增波形切换指令(func=0x09)，9种波形，CRC全部验证通过
2026-06-15 docs: 波形切换简化为单参数(1~9)，去除波形组定义，CRC重新计算
2026-06-15 docs: 删除电流能量调节指令(func=0x02)，CRC记录和时序示例同步更新
2026-06-15 docs: 温度调节参数范围移除手柄C(0x0C)，仅保留A/B
2026-06-16 docs: add NNC6521 driver API reference (CN/EN)
2026-06-16 docs: add current gear adjust command (0x09) to protocol
2026-06-16 docs: add current control command (0x02) to protocol
2026-06-16 docs: update current control to 0-100% range
2026-06-16 docs: update protocol summary with current control (0x02)
2026-06-29 feat: add NTC temperature PID control algorithm
    - ntc_sensor.h/.c: NTC temperature acquisition with B-parameter equation
    and 8-point sliding average filter for ADC1_CH10 (large handle) and
    ADC1_CH11 (small handle)
    - temp_pid.h/.c: Independent PID controller for each handle with:
    - Positional PID with anti-windup and derivative-on-measurement
    - Software PWM (1000ms period) for GPIO heater control
    - Dead band (0.3C), overheat protection (45C), sensor fault detection
    - Kp=8.0, Ki=0.15, Kd=3.0, control period=100ms
    - Integration: 10ms timer hook in rtt_system_work.c, protocol.c
    temperature command now drives PID target temperature
    - Design docs in Chinese and English
    [ntc_sensor.c, ntc_sensor.h, protocol.c, temp_pid.c, temp_pid.h]
2026-07-07 feat(waveform): implement 9 waveforms per NNC6521 spec
    - Add burst_pulse_64 and deep_sculpt_pulse_128 waveform data arrays
    - Rewrite waveform_apply() with proper gen methods per spec:
    #1 Power Smooth: Preloaded PULSE (50Hz, 300us)
    #2 Burst Train: Customized SPI burst_pulse_64 (50Hz)
    #3 Gentle Smooth: Preloaded PULSE (35Hz, 300us)
    #4 Deep Sculpt: Customized SPI deep_sculpt_pulse_128 (4kHz carrier)
    #5 Soft Sculpt: Customized SPI sine 128 (40Hz)
    #6 Circulation Sculpt: AM sine 64 (4kHz carrier, 10Hz envelope)
    #7 Smooth & Firm: Preloaded TRIANGLE (100Hz, 400us)
    #8 Lymphatic Drainage: Customized SPI sine 64 (5Hz, PCLK/16)
    #9 Soothing Ending: Customized SPI sine 64 (10Hz, PCLK/8)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
2026-07-07 fix(waveform): correct current unit to μA for NNC6521 API
    nnc6521_customized_waveform() and nnc6521_amplitude_modulation() expect
    max_current in μA, not mA. map_percent_to_current() returns mA, so
    multiply by 1000 before passing to NNC6521 API calls (cases 2/4/5/6/8/9).
    This was causing waveform data to be compressed to near-zero values,
    resulting in square wave output instead of sine/triangle.
    [protocol.c]
2026-07-07 fix(waveform2): correct burst pulse data - narrow pulse per cycle
    Same fix as verify-nnc6521-demo: single-point pulse per half-wave instead
    of 32 consecutive high points.
    [nnc6521_waveform.c]
2026-07-07 fix(waveform#6): change from AM to Custom SPI mode
    Waveform #6 (Circulation Sculpt) used hardware AM mode which outputs 0V.
    Changed to Custom SPI with pre-computed 64-point AM waveform array.
    - Added circulation_sculpt_am_64[64] data array
    - Added extern declaration in nnc6521.h
    - Changed case 6 from nnc6521_amplitude_modulation() to nnc6521_customized_waveform()
    - Uses PCLK_DIV_8, half_wave_clk=12500
    - Updated waveform type string
    [nnc6521.h, nnc6521_waveform.c, protocol.c]
2026-07-07 fix(waveform): use full waveform data (asymmetric=0) for all customized waveforms
    symmetric_wave=1 causes hardware to mirror half-wave data, producing
    only positive half-wave output. Changed to asymmetric=0 (full data mode)
    for waveforms #5, #6, #8, #9 to match reference implementation.
    [protocol.c]
2026-07-07 fix(waveform4): correct deep sculpt data with proper 4kHz carrier
    [nnc6521_waveform.c]
2026-07-08 feat(waveform): migrate all 9 verified waveforms from verify-nnc6521-demo
    Changes:
    - Created nnc6521_waveform_config.h: waveform config header with 9 preset
    waveform definitions, gen method enums, and public API declarations
    - Created nnc6521_waveform_config.c: waveform config implementation with
    all 9 waveforms (Power Smooth, Burst Train, Gentle Smooth, Deep Sculpt,
    Soft Sculpt, Circulation Sculpt, Smooth & Firm, Lymphatic Drainage,
    Soothing Ending), PCLK divider management, current calculation API
    - Updated nnc6521.h: added nnc6521_analog_enable() declaration
    - Updated nnc6521_drv.c: added nnc6521_analog_enable() implementation
    for CH1/CH2 VDAC + driver amplifier configuration
    -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
2026-07-08 feat(ntc): add lookup table + linear interpolation for NTC temperature conversion
    - Add 176-point Rnor lookup table (-50~125°C) from manufacturer datasheet
    - Implement binary search + linear interpolation (O(log n))
    - Add NTC_USE_LOOKUP_TABLE macro for dual-mode switching (LUT vs B-equation)
    - Add ntc_resistance_to_temperature_lut() for direct R-to-T conversion
    - Update design docs (CN+EN) change log to V1.1
2026-07-08 fix: resolve waveform_apply multiple definition error
    - Remove duplicate waveform_apply() and set_pclk_divider() from protocol.c
    - Remove duplicate waveform_apply() declaration from protocol.h
    - Add #include nnc6521_waveform_config.h in protocol.c to use canonical implementation
    - waveform_apply() now solely defined in nnc6521_waveform_config.c
    [board.h, cubemx.ioc, main.h, protocol.c, protocol.h]
2026-07-08 fix(docs): correct NTC ADC pin mapping in project overview
    PC0 = Large handle NTC (ADC_CH10), PC1 = Small handle NTC (ADC_CH11)
2026-07-08 docs: sync all docs with latest code changes
    - nnc6521_driver_api.md/.en.md: add nnc6521_waveform_config to file structure
    - 项目需求文档.md V2.1: add ntc_sensor/temp_pid/waveform_config modules,
    update module structure, remove implemented TODO items,
    update temperature control and waveform switching status
2026-07-08 docs: add modular functional test case table (测试用例表.md)
    - 16 test categories, 90+ test cases
    - Covers: protocol, handle switching, current control, waveform switching,
    temperature control (NTC + PID), pump control, NNC6521 driver,
    system timer, power management, DAC, integration scenarios
2026-07-08 fix(docs): test case checkboxes changed to Markdown task list syntax (- [ ])
    Checkboxes are now interactive in Feishu/GitHub/Obsidian
2026-07-08 feat: add DJM-V10 protocol commands to sscom51.ini
    - 31 HEX command entries with verified CRC16-MODBUS
    - Covers: version read, handle switch, current control, temperature,
    pump, start/pause, aging mode, waveform selection (1-9)
    - Baud rate set to 9600, HEX display mode enabled
    - GBK encoding for Chinese SSCOM compatibility
2026-07-09 docs: sync pin mapping and protocol func codes across docs
    - 项目需求文档.md: fix heating control pins (PC10/PC11, not PC11/PC12)
    - 通讯协议文档.md: fix func code range to 0x01~0x09
    - 我的项目概要.md: add waveform switch command 0x09 to list
    [bsp_hard.c, bsp_hard.h]
2026-07-09 feat(protocol): implement 5 TODO stubs in protocol.c
    - TODO1: Disable NNC6521 AWG in protocol_stop_waveform() based on handle
    - TODO2: Add GPIO control for vacuum pump in handle_pump_ctrl()
    - TODO3: Mark handle_ota_upgrade() as reserved
    - TODO4: Mark handle_aging_mode() as reserved
    - TODO5: Replace TODO with explanation in handle_waveform_sel()
    [protocol.c]
2026-07-09 feat: GPIO abstraction layer + power management task
    - bsp_hard.h/c: GPIO abstraction for power, LED, beep, boost, pump, heater
    - power_task.h/c: Power management thread with boot/shutdown state machine
    - protocol.c: Replace direct HAL_GPIO pump control with bsp_pump_set()
    - bsp_sys.h: Add #include bsp_hard.h
    - main.c: Add bsp_hard.h include
    [bsp_hard.c, bsp_hard.h, protocol.c]
2026-07-09 feat: integrate LED/KEY/BEEP drivers + refactor power management
    - main.h: add KEY1/KEY2/KEY3/LED_GREEN pin aliases for imported drivers
    - macSYS.h: create compatibility header for BSP drivers
    - bsp_key.c: rewrite KEY_Scan() with power button handling, remove OLED logic
    - bsp_hard.c/h: remove LED/beep/button functions (replaced by new drivers)
    - power_task.c: full rewrite with KEY driver integration, shutdown protocol
    - Boot: wait KEY_Evt_Press -> LED on -> beep 1s -> 12V enable
    - Shutdown: send func=0x0A request -> wait confirm (5s timeout) -> disable all
    - power_task.h: add power_shutdown_confirm() declaration
    - protocol.c: add FUNC_SHUTDOWN_REQ (0x0A) handler for shutdown confirmation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
    [bsp_beep.c, bsp_beep.h, bsp_hard.c, bsp_hard.h, bsp_key.c, bsp_key.h, bsp_led.c, bsp_led.h]
2026-07-09 refactor(bsp): port drivers to match current project pins
    - bsp_led.h/c: LED_NUM=1, GPIO changed to START_LED_CTRL, comments in English
    - bsp_key.h/c: KEY_NUM=1, GPIO changed to POWER_ON_OFF, removed KeyB/KeyC
    - bsp_beep.h/c: include fixed to bsp_sys.h, comments in English
    - main.h: removed imported driver pin aliases (KEY1/KEY2/KEY3/LED_GREEN)
    [bsp_beep.c, bsp_beep.h, bsp_key.c, bsp_key.h, bsp_led.c, bsp_led.h, main.h]
2026-07-09 docs: rewrite test case table V2.0 - organized from simple to complex, all English
2026-07-09 docs: rewrite test case table V2.0 in Chinese
    - Reorganized test phases from simple to complex (9 phases, 158 cases)
    - Phase 1: Power supply & boot sequence
    - Phase 2: Basic peripheral debug (LED/buzzer/key/timer)
    - Phase 3: Debug UART
    - Phase 4: Communication protocol (all commands)
    - Phase 5: NTC temperature sensor
    - Phase 6: PID temperature control
    - Phase 7: DAC module
    - Phase 8: NNC6521 waveform generator
    - Phase 9: Integrated scenario tests
    [bsp_led.c, bsp_led.h]
2026-07-09 refactor: centralize key events in KEY_Scan(), power_task uses flags
    - bsp_key.c KEY_Scan(): KEY_Evt_Press triggers boot, KEY_Evt_Long2S
    triggers shutdown, KEY_Evt_Long4S triggers forced shutdown
    - power_task.c: removed key reading loop, uses volatile flags
    (s_boot_requested, s_shutdown_requested, s_force_shutdown)
    - power_task.h: added power_request_boot(), power_request_shutdown_by_key(),
    power_force_shutdown() declarations
2026-07-09 refactor: move power flags to FlagStruct in bsp_typedef
    - bsp_typedef.h: added power_boot_request, power_shutdown_request,
    power_force_shutdown, power_shutdown_confirmed to FlagStruct
    - bsp_key.c: KEY_Scan() sets Flag.power_xxx directly
    - power_task.c: reads Flag.power_xxx instead of local statics
    - power_task.h: removed flag-setting function declarations
2026-07-09 refactor: use BEEP_Blink for non-blocking beep in power sequences
    - Boot: BEEP_SetCycleDuty(1000,1000) + BEEP_Blink(1,0,0), no blocking delay
    - Shutdown: same pattern + short delay to wait beep completion before LED off
2026-07-09 docs: update 项目需求文档 to V3.0 with full system architecture
    - New section 九: Power management system (state machine, boot/shutdown flows)
    - Updated module hierarchy: added bsp_hard/led/key/beep, macTask layer
    - Updated thread table: added power_task, LED_Thread, keyTimer, beepTimer
    - Updated auto-init table: all modules with init order
    - Updated FlagStruct: power management flags with data flow diagram
    - Updated directory structure: new files and folders
    - Renumbered all subsequent sections (十→十一, etc.)
    - Removed pump TODO (now implemented via PB10 GPIO)
2026-07-09 refactor(protocol): split protocol.c into protocol driver + action handlers
    - protocol.c: UART, CRC, ring buffer, decode state machine, init
    - protocol_act.c/h: command dispatch, waveform control, handle_xxx handlers
    - protocol.h: removed moved declarations (protocol_update_current_output,
    protocol_start_waveform, protocol_stop_waveform)
    - protocol_dispatch() now takes cmd_len parameter instead of using global
    - All comments in English
2026-07-09 docs: update 项目需求文档 V3.1 for protocol.c split
    - Module hierarchy: split protocol entry into protocol + protocol_act
    - Interface section: separate protocol driver and protocol_act interfaces
    - Directory structure: added protocol_act.h/c entries
    - TODO references: updated to protocol_act.c
2026-07-09 feat: handle switching is now mutually exclusive - clear other handles
    - handle_switch(): stop all outputs (waveform, heating, pump), clear
    all handles' params (current_percent, temperature, pump_speed), reset
    all PID targets to 0
    - 我的项目概要.md: updated handle behavior description
    - 项目需求文档.md V3.2: updated handle switch behavior
    - 测试用例表.md: updated P4-17, P4-18, P9-04 for new behavior
    [protocol_act.c]
2026-07-10 fix: remove duplicate HAL/UART init in main(), disable NTC/PID/NNC6521 for debug
    - main.c: removed redundant HAL_Init(), SystemClock_Config(), MX_GPIO_Init(), MX_USART1/2_UART_Init() (already handled by RT-Thread hw_board_init)
    - main.c: disabled NTC, PID, NNC6521 init blocks (#if 0) for isolated debugging
    - rtt_system_work.c: disabled ntc_sensor_update() and temp_pid_tick() in timer callback
    [kconfig-language.txt, kconfig.txt]
2026-07-10 feat: 更新驱动、文档及新增 BSP/SYS 模块
2026-07-10 fix(LTS): UART1 opened as RDWR to allow TX responses
    [protocol.c]
2026-07-10 fix(LTS): remove UART reconfiguration, just open existing device
    [protocol.c]
2026-07-10 debug(LTS): add RX byte print in decode thread
2026-07-10 debug(LTS): print UART handle address
2026-07-10 fix(LTS): restore UART baud rate config to 9600 (was mismatched with CubeMX default)
    [protocol.c]
2026-07-10 fix(LTS): remove MX_USART1/2_UART_Init() from main() - was overwriting protocol baud rate
    INIT_APP_EXPORT(protocol_init) runs before main() and configures UART1 to 9600.
    main() then called MX_USART1_UART_Init() which reset UART1 back to CubeMX default (115200).
    RT-Thread driver already handles UART init, CubeMX calls are redundant.
2026-07-10 feat(LTS): enable handle_switch handler (FUNC 0x01)
    - handle_switch(): validate handle ID (0x0A/0x0B/0x0C), clear all params, update active handle, send ACK
    - dispatch: route FUNC_HANDLE_SWITCH to handler
    - Removed hardware dependencies (NNC6521, heater, pump, PID) for LTS test
2026-07-10 feat(LTS): enable all command handlers (state-only, no hardware deps)
    - 0x01 handle_switch: switch active handle, clear all params
    - 0x02 handle_current_ctrl: save current percent per handle
    - 0x03 handle_temp_ctrl: save temperature (handle A/B only)
    - 0x04 handle_pump_ctrl: save pump speed (handle C)
    - 0x05 handle_start_pause: set is_running flag
    - 0x06 handle_ota_upgrade: reserved, returns ERR_UNSUPPORTED
    - 0x07 handle_aging_mode: set aging mode flag
    - 0x08 handle_read_version: return firmware version
    - 0x09 handle_waveform_sel: save waveform ID (1~9)
    - All handlers: state management + ACK only, no NNC6521/heater/pump/PID
2026-07-10 chore(LTS): disable RX byte debug print
2026-07-10 feat(LTS): integrate NNC6521 driver, full hardware waveform control
    Hardware mapping:
    - Handle A/B -> NNC6521_CHIP_1 (shared)
    - Handle C -> NNC6521_CHIP_2 (independent)
    - Copied NNC6521 driver files (nnc6521_drv/spi/waveform/waveform_config)
    - protocol_act.c: all handlers now control NNC6521 hardware
    - handle_switch: stop waveform, clear params, switch handle
    - handle_current_ctrl: save percent, apply if running
    - handle_start_pause: start/stop waveform output
    - handle_waveform_sel: save waveform ID, apply if running
    - main.c: NNC6521 dual-chip init + analog enable
    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
2026-07-10 docs: update protocol doc for handle switch behavior and NNC6521 hardware mapping
    - V4.5: handle switch clears all params (not save/restore)
    - Added NNC6521 hardware mapping table (Handle A/B -> CHIP_1, Handle C -> CHIP_2)
    - Updated handle switch description to match actual code behavior
    - Updated change log
2026-07-13 feat(protocol_act): add hardware control for 54V boost, heater, and pump
    - handle_start_pause(): enable 54V boost before waveform, 10ms soft-start delay
    - handle_stop_output(): disable 54V boost after stopping waveform
    - handle_temp_ctrl(): control heater hardware (large/small) based on temperature
    - handle_pump_ctrl(): control vacuum pump based on speed
    - handle_switch(): disable boost, turn off all heaters and pump on handle switch
    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
2026-07-13 feat: replace long-press shutdown with host-confirmed shutdown protocol
    - Remove long press 2s/4s detection from bsp_key.c (KEY_DrvScan)
    - KEY_Scan: short press boot when OFF, short press shutdown request when ON
    - Add POWER_STATE_WAIT_CONFIRM state with 10s timeout
    - power_task: send FUNC_SHUTDOWN_REQ to host, wait for confirm/deny
    - protocol_act.c: handle host shutdown confirm (0x01) and deny (0x00)
    - Remove power_force_shutdown flag and power_shutdown_graceful()
    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
    [bsp_key.c, protocol_act.c]
2026-07-13 refactor: rename LED_Name_Green to LED_Name_Start
2026-07-13 docs: 新增关机请求/确认指令(func=0x0A)文档更新
    - 通讯协议文档: 新增V4.6版本记录、6.10关机请求/确认章节、功能码0x0A定义、附录速查、代码索引更新
    - 我的项目概要: 指令列表新增0x0A、关机流程改为请求/确认机制(10s超时不关机)
    - 测试用例表: 修正P1-07/08/13/14、P4-50~53、P9-09(长按→短按,5s→10s,强制关机→不关机);
    删除P2-11/P2-12长按测试; LED_Name_Green→LED_Name_Start;
    新增P4-54关机拒绝测试; 重编号P4-55~59
2026-07-13 docs: 更新项目需求文档至V3.3 - 电源控制逻辑重构
    - 按键改为短按开机/短按关机请求（去掉2s/4s长按）
    - 关机需上位机确认（10s超时不关机），新增WAIT_CONFIRM状态
    - 54V boost与治疗启停联动
    - 加热器/水泵协议→硬件联动
    - LED_Name_Green→LED_Name_Start
    - 新增6.10关机请求/确认模块（功能码0x0A）
    - 功能码范围扩展至0x01~0x0A
    - 更新FlagStruct：移除power_force_shutdown，新增power_shutdown_denied
    - 手柄B加热引脚确认为PC10
2026-07-13 feat: Handle B uses NNC6521_CHIP_1 CH1, add handle_to_channel() mapping
    - Handle A -> CHIP_1 CH0, Handle B -> CHIP_1 CH1, Handle C -> CHIP_2 CH0
    - Added handle_to_channel() helper function
    - Replaced hardcoded WAVEFORM_GEN_CH0 with dynamic channel lookup
    - Enabled CH1 analog output in main.c initialization
    - Updated log messages to include channel info
    [protocol_act.c]
2026-07-13 docs: update channel mapping - Handle B uses CHIP_1 CH1
    - 通讯协议文档: NNC6521 table updated (B→CH1), note updated
    - 项目需求文档: added 8.1.1 NNC6521 channel mapping section
    - 我的项目概要: added channel mapping info
    - 测试用例表: added P8-05b/05c for CH1/CH2 enable, updated P8-12
2026-07-13 feat: optimize current amplitude update with waveform_update_amplitude()
    - Added waveform_update_amplitude() to nnc6521_waveform_config.c/h
    - For CUSTOM_SPI: uses nnc6521_customized_amplitude() (rewrites waveform data only)
    - For PRELOADED: updates CI register directly (single register write)
    - For AMPLITUDE_MOD: falls back to full waveform_apply()
    - handle_current_ctrl now uses amplitude-only update instead of full reconfigure
    - waveform_apply() still used for start/stop/waveform-switch (full config)
2026-07-13 fix: enable 12V power first in boot sequence
    Board needs power before LED and buzzer can work.
    Boot order: 12V enable → LED on → Beep
2026-07-13 fix: reorder shutdown sequence - beep and LED off before 12V power cut
    Buzzer and LED need 12V power to work.
    Shutdown order: stop output → disable boost → beep → LED off → 12V off
2026-07-13 fix: add missing power_task_init() call in main.c
    power_task_init() was never called, so the power management thread
    was never created and boot/shutdown sequences never executed.
2026-07-13 fix: implement protocol_stop_waveform() and protocol_start_waveform()
    Functions were declared in protocol_act.h but never implemented.
    protocol_stop_waveform() disables AWG on all chips/channels.
    Called by power_task during shutdown sequence.
    [protocol_act.c]
2026-07-13 fix: use blocking beep instead of BEEP_Blink driver
    BEEP_Blink repeat parameter has edge cases causing continuous ringing.
    Switch to direct BEEP_On/Off with blocking delay for reliable 1s beep.
2026-07-13 fix: BEEP_DrvScan logic when beepDty==beepCyc
    Root cause: if-else chain order (A→B→C) means when beepDty==beepCyc,
    branch (A) fires before (B), so buzzer never turns OFF.
    Fix: separate ON/OFF checks from cycle-end logic:
    - Turn OFF when beepClk >= beepDty (before cycle end check)
    - Cycle-end logic handles counters only
    - Turn ON when beepClk < beepDty && beepCnt < beepCry
    Also reverted power_task.c to use BEEP_Blink (non-blocking).
    [bsp_beep.c]
2026-07-13 feat: default current to 1% (minimum) on handle switch
    Simplified treatment flow:
    1. Switch handle (optional, defaults to A)
    2. Select waveform (optional, defaults to 1)
    3. Start treatment → waveform outputs immediately at minimum current
    No need to explicitly set current before starting.
2026-07-13 debug: add macBEEP_OFF() when beep cycle completes
    Added safety: ensure buzzer OFF when beepCry is set to 0.
    Added debug print on beep completion.
    [bsp_beep.c]
2026-07-13 feat(protocol): current control from percentage to direct mA value
    - protocol.h: add current_ma (uint16_t) to handle_params_t, keep current_percent for internal NNC6521 driver use
    - protocol_act.c: handle_current_ctrl now accepts 2-byte big-endian mA value + handle ID (3 params instead of 2)
    - protocol_act.c: handle_current_ctrl validates, clamps to waveform range, converts mA->percent for driver
    - protocol_act.c: handle_switch initializes current_ma from waveform min_current
    - protocol_act.c: handle_waveform_sel recalculates percent for all handles when waveform changes
    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
2026-07-13 refactor: current control single byte mA (0~100)
    Protocol: 55 AA 07 60 66 44 02 02 [mA] [handle] [CRC]
    - para[0] = current in mA (single byte, 0~100)
    - para[1] = handle ID
    - len = 0x07 (same as before)
    - ACK: [mA] [handle]
2026-07-13 fix: beep driver safety checks and edge case handling
    - BEEP_SetCycleDuty: validate Cycle>0, Duty>0, Duty<=Cycle
    - BEEP_Blink: validate cry>0, reset beepClk on start
    - BEEP_DrvScan: fixed debug print order
    - All edge cases now produce correct behavior
    [bsp_beep.c]
2026-07-13 refactor: beep driver from software timer to thread
    - Replaced rt_timer with rt_thread (priority 5, stack 256)
    - Thread runs BEEP_DrvScan() every 1ms in a loop
    - More reliable timing than software timer
    [bsp_beep.c]
2026-07-13 fix: increase beep thread stack from 256 to 512 bytes
    [bsp_beep.c]
2026-07-13 fix: remove rt_kprintf from beep scan loop to prevent stack overflow
    rt_kprintf in the 1ms scan loop consumes too much stack.
    Removed debug prints from BEEP_DrvScan and beep thread entry.
    [bsp_beep.c]
2026-07-13 refactor: beep scan loop from 1ms to 10ms
    - Thread delay: 1ms → 10ms
    - BEEP_SetCycleDuty: converts ms to scan ticks (divide by 10)
    - API still accepts ms values, conversion is internal
    - Reduces CPU load by 10x
2026-07-13 docs: 更新电流控制从百分比改为mA值，更新关机帧CRC
    - 电流控制: 百分比→直接mA值(0~100)，固件clamp到波形范围
    - Handle B通道: CHIP_1 CH1(原来和A共用CH0)
    - sscom51.ini: 更新N105~N109电流按钮(mA值)，计算CRC16-MODBUS
    - sscom51.ini: 更新N132~N134关机按钮CRC(替换XX XX)
    - 通讯协议文档V4.7: 更新6.2电流控制章节、版本历史
    - 通讯协议简洁版V1.6: 更新指令汇总表和请求帧
    - 项目需求文档: 更新6.2电流控制模块参数定义
    - 测试用例表: 更新P4-20~P4-26电流控制测试用例
2026-07-13 feat: skip handle switch if already on the same handle
    Switching to the same handle (A→A) now just returns ACK
    without stopping waveform or clearing parameters.
    [protocol_act.c]
2026-07-14 fix: B handle waveform no output - 3 bugs fixed
    BUG#1 (critical): nnc6521_wavegen_config() overwrote ANA_ENABLE_REG with 0x09,
    clearing VDAC_EN/COMP_EN/DRIVERA_CSAMP_EN bits set during init. Changed to
    read-modify-write (|= 0x09) to preserve analog frontend enable bits.
    BUG#2 (critical): protocol_start_waveform() never enabled 54V boost converters.
    Added bsp_boost_1/2_enable(1) before waveform output, and disable on stop.
    BUG#3 (minor): main.c only applied default waveform to CHIP_1. Added CHIP_2
    initialization for consistency.
    [nnc6521_drv.c, protocol_act.c]
2026-07-14 feat: add current control commands for all handles in sscom51.ini
    - Handle A: 0%~100% (11 levels) - full coverage
    - Handle B: 0%~100% (11 levels) - full coverage (was only 30%)
    - Handle C: 0%~100% (11 levels) - newly added
    - All CRC16-MODBUS checksums verified
    - Chinese labels preserved in GBK encoding
2026-07-14 refactor: change current control from percentage to direct mA value
    - waveform_apply() / waveform_calc_current() now accept mA directly
    instead of percentage (0~100%)
    - Parameter is clamped to waveform's [min_current, max_current] range
    - Renamed current_percent -> current_ma in handle_params_t struct
    - Renamed WAVEFORM_DEFAULT_PCT -> WAVEFORM_DEFAULT_MA (50mA)
    - sscom51.ini labels updated: all current entries show mA values
    - Handle A/B: 0/30/35/40/45/50/55/60/65/70/75/80 mA
    - Handle C: 0/15/20/25/30/35/40/45/50/55/60 mA
    - All CRC16-MODBUS checksums recalculated
2026-07-14 fix(LTS): apply wavegen analog enable fix + add debug register readback
    - BUG#1 fix: nnc6521_wavegen_config() changed from 0x09 direct write to
    read-modify-write (|= 0x09) to preserve VDAC/COMP/DRIVER enable bits
    - Added debug register readback after waveform application to verify
    NNC6521 SPI communication and register state
    [nnc6521_drv.c, protocol_act.c]
2026-07-14 fix(LTS): 4 critical waveform output issues
    1. Preloaded waveform CI hardcoded to 4 -> now maps percent to CI 0~7
    2. Current_Output double *1000 -> removed caller's *1000, pass mA directly
    3. Analog enable |= 0x09 -> |= 0x1F (VDAC+COMP+IDAC+CSAMP+AMP)
    4. Added NNC6521 register readback debug after waveform config
    Also fixed main version: analog enable |= 0x1F
    [nnc6521_drv.c, nnc6521_waveform_config.c]
2026-07-14 fix(LTS): SPI not responding - add chip reset + MISO pull-up
    Root cause: all NNC6521 registers read back 0x11, SPI communication
    completely non-functional.
    1. nnc6521_init(): add explicit chip reset (PMU bit5) before config
    2. nnc6521_init(): add PMU readback verification after reset
    3. nnc6521_spi.c: MISO pin changed from NOPULL to PULLUP to prevent
    floating input when chip is not driving the line
    If PMU readback still shows 0x11 after reset, check:
    - NNC6521 VDD power supply (3.3V)
    - SPI pin mapping matches hardware schematic
    - CHIP_EN pin is actually connected to the chip
    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
    [nnc6521_drv.c, nnc6521_spi.c]
2026-07-14 debug(LTS): add SCLK toggle test for GPIO verification
    Toggles PC7 (Chip1 SCLK) and PB11 (Chip2 SCLK) at 500Hz for 5 seconds
    during init. Use oscilloscope or multimeter to verify GPIO is working.
    If no signal: GPIO config issue or pin conflict.
    If signal OK: SPI protocol issue (check CSN/MOSI timing).
    REMOVE THIS BLOCK AFTER DEBUGGING.
    [nnc6521_spi.c]
2026-07-14 fix(LTS): align SPI driver with working demo board
    Critical fixes from comparing with verify-nnc6521-demo (confirmed working):
    1. SPI write protocol: [addr, cmd, 0x11, data] -> [addr, cmd, data, 0x00]
    NNC6521 expects data in byte 2, not byte 3
    2. SPI bit-bang timing: added NOP delays for data setup time (~55ns),
    clock high time (~55ns + margin), and clock low time
    3. CSN delays: added 4x NOP after CSN low and before CSN high
    4. CHIP_EN reset timing: increased from ~1ms to 5ms low / 500ms high
    to match demo board's power-on reset sequence
    5. Removed debug SCLK toggle code (no longer needed)
    [nnc6521_drv.c, nnc6521_spi.c]
2026-07-14 fix(LTS): restore current calculation to match working demo
    1. Restored *1000 multiplier for customized_waveform and amplitude_modulation
    Current_Output() expects microamps (µA), not milliamps (mA)
    2. Restored CI=4 (hardcoded) for preloaded waveforms to match demo
    Dynamic CI was causing inconsistent output levels
    [nnc6521_waveform_config.c]
2026-07-14 fix(LTS): remove debug prints that cause waveform jitter
    Removed rt_kprintf calls from waveform output path:
    - nnc6521_wavegen_config(): register readback debug removed
    - handle_apply_output(): register readback debug removed
    These prints were called during waveform generation and caused
    timing jitter on the SPI bus, leading to waveform truncation
    when adjusting current levels.
    [nnc6521_drv.c, protocol_act.c]
2026-07-14 fix(LTS): stop AWG before amplitude update to prevent waveform distortion
    When switching current (e.g. 60mA->30mA), waveform_update_amplitude()
    wrote new waveform data while the generator was still running. The NNC6521
    read partially-old/partially-new data, causing waveform truncation.
    Fix: disable AWG before writing new amplitude data, re-enable after.
    Demo doesn't have this issue because it never changes current at runtime.
    [nnc6521_waveform_config.c]
2026-07-14 perf(LTS): reduce NNC6521 init delay from ~1s to ~14ms
    CHIP_EN reset: 5ms low + 500ms high -> 1ms low + 5ms high
    PMU reset: ~0.5ms x2 -> 1ms x2
    Total: ~1012ms -> ~14ms per chip (~28ms total)
    Also removed verbose init debug prints (only print on error)
    [nnc6521_drv.c]
2026-07-14 feat(LTS): integrate NTC sensor with RT-Thread ADC framework + enable PID control
    1. ntc_sensor.c: rewritten to use RT-Thread ADC device API
    - rt_device_find('adc1') + rt_adc_enable() + rt_adc_read()
    - Removed HAL ADC direct calls
    - Kept: lookup table (176-point), B-parameter equation, sliding average filter
    2. rtt_system_work.c: enabled 10ms timer calls
    - ntc_sensor_update() - ADC read + filter + temperature conversion
    - temp_pid_tick() - PID computation + software PWM output
    3. main.c: added initialization calls
    - ntc_sensor_init() after MX_ADC1_Init()
    - temp_pid_init() after ntc_sensor_init()
    ADC channels: CH10 (PC0) = large handle NTC, CH11 (PC1) = small handle NT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
2026-07-14 feat(LTS): integrate PID temperature control into protocol layer
    handle_temp_ctrl():
    - Replaced direct GPIO heater control with temp_pid_set_target()
    - PID handles PWM duty cycle, overheat protection, sensor fault detection
    handle_switch():
    - Replaced bsp_heater_xxx_set(0) with temp_pid_set_target(i, 0)
    - PID reset automatically turns off heater and clears integral state
    Temperature control flow:
    Protocol cmd -> temp_pid_set_target(ch, temp_c)
    10ms timer -> ntc_sensor_update() + temp_pid_tick()
    PID compute -> pwm_update() -> heater_set() (GPIO PWM)
    [protocol_act.c]
2026-07-14 fix(LTS): correct handle-heater mapping + mutual exclusion
    Handle-function mapping:
    - Handle A -> small handle heater (TEMP_PID_SMALL)
    - Handle B -> large handle heater (TEMP_PID_LARGE)
    - Handle C -> pump only (no heating, returns error if temp set)
    Mutual exclusion: setting temp on one handle automatically
    disables the other handle's PID controller.
    Added s_handle_to_pid[] mapping table for clean handle->PID routing.
    [protocol_act.c]
2026-07-14 docs: update all docs for LTS SPI/NTC/PID changes
    - nnc6521_driver_api: SPI protocol, bit-bang timing, analog enable
    - NTC/PID design: RT-Thread ADC, handle mapping, PID integration
    - Protocol docs: temperature command with PID params and safety
2026-07-14 docs: update project requirements doc V3.4 - PID temp control process
    - Section 6.3: updated temp control to PID-based with mutual exclusion
    - Section 10: complete rewrite with PID algorithm, flow diagram, safety
    - Section 3.4: SPI protocol corrected (data in byte2), NOP timing added
    - Version history: V3.4 entry with all 2026-07-14 changes
2026-07-14 feat(LTS): temperature reporting + PID auto-tuning
    1. Temperature periodic report (FUNC_TEMP_REPORT = 0x0B):
    - 2s RT-Thread software timer during treatment
    - Frame: [handle_id, temp*10 high, temp*10 low]
    - Auto start/stop with treatment
    2. PID auto-tuning (FUNC_PID_AUTOTUNE = 0x0C):
    - Relay feedback method (bang-bang oscillation)
    - Ziegler-Nichols formula: Ku=4d/(πa), Kp=0.6Ku, Ki=2Kp/Tu, Kd=Kp·Tu/8
    - 6 cycles, 2°C hysteresis, 20min timeout
    - Auto-apply new PID params on completion
    - Protocol notification on start/complete/error
    3. Safety: overheat 45°C protection active during auto-tune
    [dac7311.c, dac7311.h, protocol.h, protocol_act.c, protocol_act.h, temp_pid.c, temp_pid.h]
2026-07-14 docs: add temperature reporting (0x0B) and PID auto-tuning (0x0C)
    - 项目需求文档 V3.5: sections 6.11/6.12 added
    - 通讯协议文档 V4.9: two new commands documented
    - 通讯协议文档-简洁版 V1.8: quick reference updated
    - NTC/PID design docs: auto-tuning section added (CN+EN)
2026-07-14 docs: add complete electrical stimulation and temperature control flow diagrams
    Project requirements doc V3.6:
    - Section 15-A: complete electrical stimulation flow (init, treatment start/stop, registers)
    - Section 15-B: complete temperature control flow (init, PID loop, reporting, auto-tuning)
    - Handle-PID mapping table with mutual exclusion
    - All protocol commands with step-by-step flow
    [kconfig-language.txt, kconfig.txt]
2026-07-14 feat(LTS): add VOFA+ PID debug output via USART2
    FireWater protocol format: PIDn:target,current,output,p,i,d\n
    - Channel 0: target temperature
    - Channel 1: current temperature
    - Channel 2: PID output (0~100%)
    - Channel 3: P term
    - Channel 4: I term
    - Channel 5: D term
    Output every 100ms (PID control period) via USART2 (PA2 TX).
    VOFA_ENABLE=1 in temp_pid.c to enable, set to 0 to disable.
2026-07-14 feat(LTS): implement DAC7311 driver for pump speed control (0~5V)
    dac7311.c/h: complete driver implementation
    - Software SPI bit-bang (PB7=SYNC, PB8=SCLK, PB9=DIN)
    - 12-bit resolution, VOUT = VREF * D / 4096 (0~5V)
    - Functions: set_voltage(), set_raw(), set_percent(), power_down()
    - SPI Mode 0, MSB first, 16-bit frame
    Integration:
    - protocol_act.c: pump control now uses dac7311_set_percent(speed)
    instead of bsp_pump_set() on/off GPIO
    - power_task.c: shutdown uses dac7311_set_percent(0)
    - main.c: added dac7311_init() in initialization sequence
2026-07-14 docs: update pump control section for DAC7311 (V3.7)
    - Section 6.4: complete rewrite for DAC7311 analog voltage control
    - Added hardware interface table, driver specs, control flow diagram
    - Updated version to V3.7
2026-07-14 fix(LTS): 5 issues from code review
    S1: Waveform 6/9 PCLK divider PCLK_DIV_8 -> PCLK_DIV_16
    Output frequency was 2x (20Hz instead of 10Hz)
    S2: Add init flags (s_ntc_initialized, s_pid_initialized)
    ntc_sensor_update() and temp_pid_tick() now skip if not initialized
    M2: power_do_shutdown() now calls temp_pid_reset() to clear PID state
    M3: autotune_tick() adds sensor fault check (-30C ~ 100C range)
    Aborts autotune if NTC sensor disconnected
    M5: Added production warning for VOFA_ENABLE
    [nnc6521_waveform_config.c, ntc_sensor.c, temp_pid.c]
2026-07-14 fix(LTS): move sysTimer_Init() to main() after all module init
    INIT_APP_EXPORT(sysTimer_Init) was commented out.
    sysTimer_Init() now called in main() after ntc_sensor_init(),
    temp_pid_init(), and power_task_init().
    Ensures NTC/PID modules are ready before 10ms timer starts.
2026-07-15 feat(LTS): smooth temperature rise with preheat phase
    Problem: High-power heater reaches 45°C in ~10s, causing massive
    overshoot with standard PID. Need gradual power ramp.
    Solution: Two-phase heating control:
    1. Preheat Phase (far from target):
    - Start at 2% power, ramp up 2% per control cycle
    - Max power capped at 20% during preheat
    - Prevents thermal shock and overshoot
    2. PID Phase (within 3°C of target):
    - Standard PID control takes over
    - Integral reset for clean transition
    PID parameter tuning for high-power heater:
    Kp: 8.0 -> 4.0 (less aggressive)
    Ki: 0.15 -> 0.08 (gentler integral)
    Kd: 3.0 -> 5.0 (stronger derivative damping)
    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
    [temp_pid.c, temp_pid.h]
2026-07-15 feat(LTS): update waveform current ranges - all min_current=0
    Waveform current ranges (mA):
    | Waveform | min | max |
    |----------|-----|-----|
    | 1 | 0 | 80 |
    | 2 | 0 | 80 |
    | 3 | 0 | 60 |
    | 4 | 0 | 80 |
    | 5 | 0 | 80 |
    | 6 | 0 | 60 |
    | 7 | 0 | 50 |
    | 8 | 0 | 40 |
    | 9 | 0 | 30 |
    All min_current changed to 0 for simpler current control.
    Formula: actual_current = max_current * percent / 100
2026-07-15 fix(LTS): fix rt_kprintf string literal with newline
    [temp_pid.c]
2026-07-15 fix(LTS): VOFA output only active PID, fix string literal
    - Only output VOFA data for the enabled PID (skip inactive)
    - Two handles don't work simultaneously, no need for alternating output
    - Fixed rt_kprintf string literal newline issue
    [temp_pid.c]
2026-07-15 fix(LTS): VOFA+ FireWater format - use <any>: prefix
    Changed format from 'PID%d:...' to 'any:...' to match
    FireWater protocol requirement: <any>:ch0,ch1,...,chN\n
    [temp_pid.c]
2026-07-16 fix: use pid_idx as VOFA+ prefix, add \r\n line ending
    [temp_pid.c]
2026-07-16 fix: disable protocol TX debug log to keep VOFA+ output clean
    [protocol.c]
2026-07-16 fix: reject temp set for non-active handle after switch
    [protocol_act.c]
2026-07-16 docs: update waveform names to new standard (劲感律动/活力律动/.../静谧收尾)
2026-07-16 docs: fix temp report LEN(0x08), autotune 4B float format, add example frames
2026-07-16 fix: output VOFA+ data during preheat phase
    [temp_pid.c]
2026-07-16 tune: reduce preheat power for large handle (max 12%, ramp 1%/cycle)
2026-07-16 tune: separate preheat max power - large 6%, small 12%
2026-07-16 tune: reduce large handle preheat max power to 4%
2026-07-16 tune: restore large handle preheat max power to 6%
2026-07-16 debug: add temp command logging to trace handle B PID issue
    [protocol_act.c]
2026-07-16 debug: fix handle letter labels in PID logs, add periodic PID state dump
    [protocol_act.c, temp_pid.c]
2026-07-16 fix: swap NTC channels - PC0=small handle, PC1=large handle (physical wiring)
    [protocol_act.c, temp_pid.c]
2026-07-16 revert: restore original NTC channel mapping (confirmed not swapped)
    [protocol_act.c, temp_pid.c]
2026-07-16 debug: add NTC raw ADC value logging for both channels
2026-07-16 fix: full PID state reset on handle switch to prevent stale integral/PWM/fault state
    [temp_pid.c, temp_pid.h]
2026-07-16 fix(adc): disable scan mode to fix NTC channel reading - both channels returned same value because scan mode with 2 conversions caused HAL_ADC_GetValue to always return rank 1 result
2026-07-16 chore: disable NTC debug print, keep VOFA+ output for PID monitoring
2026-07-17 fix: large handle preheat max power 6% -> 5%
    [temp_pid.h]
2026-07-17 fix: PID only starts heating when treatment begins, not on temp set
    [protocol_act.c, temp_pid.c]
2026-07-17 feat: add overheat auto-recovery at target - 1C
    - safety_check(): overheat still disables PID at 45C (unchanged)
    - temp_pid_tick(): when disabled and target > 0, check if temp has
    dropped to target - 1C, then auto re-enable PID with preheat phase
    - Adds TEMP_OVERHEAT_RECOVERY_OFFSET define (1.0C)
    - Prevents permanent lockout after overheat, allows gradual recovery
    [temp_pid.c, temp_pid.h]
2026-07-17 fix: overheat recovery no longer auto-enables PID on temp set
    Root cause: overheat recovery in temp_pid_tick() would re-enable PID
    whenever target > 0 and current temp < target, which immediately
    triggered heating when user set temperature (before starting treatment).
    Fix: Add 'overheat_shutdown' flag to temp_pid_t:
    - Set to 1 only when safety_check() triggers overheat protection
    - Recovery only activates when overheat_shutdown == 1
    - Cleared on: treatment start (temp_pid_set_enable), full reset
    - Prevents PID auto-enable from temp_pid_set_target flow
    [temp_pid.c, temp_pid.h]
2026-07-17 feat: print firmware version at startup
2026-07-17 fix: disable VOFA output to prevent timer thread stack overflow
    Timer thread stack is 1024 bytes. rt_kprintf with float formatting
    (software FPU on STM32F103) consumes 100-200 bytes per call.
    With VOFA output every 100ms + debug log every 2s, stack overflow
    causes system crash after running for a while.
    Disable VOFA_ENABLE for production. Re-enable for debugging.
    [temp_pid.c]
2026-07-17 fix: prevent timer thread stack overflow - eliminate float printf
    Root cause: rt_kprintf with %f in timer callback (1024B stack) causes
    stack overflow on STM32F103 (software FPU, 100-200B per float format).
    - Increase RT_TIMER_THREAD_STACK_SIZE from 1024 to 2048
    - Convert all float printf in pid_compute/safety_check/recovery to
    integer math (e.g. tgt=%d.%d instead of tgt=%.1f)
    - VOFA output already disabled (previous commit)
    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
    [temp_pid.c]
2026-07-17 fix: re-enable VOFA, increase timer stack to 4096
    - Re-enable VOFA_ENABLE=1 for debugging
    - Increase RT_TIMER_THREAD_STACK_SIZE from 2048 to 4096
    to accommodate float printf in timer context
    - Keep integer printf for periodic debug log (lower cost)
    [temp_pid.c]
2026-07-17 fix: dead band must update prev_measurement to avoid D-term spike
    When temperature is within dead band (|error| < 0.3C), pid_compute
    returns early without updating prev_measurement. On next cycle when
    error exceeds dead band, the derivative term uses stale measurement
    data, causing output spike.
    Fix: update both prev_error and prev_measurement before returning.
    [temp_pid.c]
2026-07-18 refactor: DAC frame format to [M1 M0 | D13-D0 | R R]
    - 14-bit data (0~16383) left-shifted by 2 into D13:D2
    - Mode control in D15:D14, reserved bits D1:D0 = 0
    - Frame assembly: (mode << 14) | (value << 2)
    - Resolution: 4096(12-bit) -> 16384(14-bit)
2026-07-18 feat: add pump speed control with non-linear voltage mapping
    - Dead zone: 0~0.5V (pump does not rotate)
    - Control zone: 0.6~4.5V (1%~90% linear mapping)
    - Saturation zone: 4.6~5.0V (91%~100% linear mapping)
    - Added dac7311_set_pump_speed() with three-zone mapping
    - Updated handle_pump_ctrl, handle_switch, power_task
2026-07-18 docs: update pump control & DAC7311 specs across all docs
    - 我的项目概要.md: add pump voltage zones and frame format
    - 项目需求文档.md: V3.8 - rewrite section 6.4 with 3-zone mapping
    - 通讯协议文档.md: V4.11 - add pump voltage zone notes
    - 通讯协议文档-简洁版.md: add pump voltage mapping note
    - 测试用例表.md: add pump voltage zone test cases (P4-33a/b/c)
2026-07-18 fix: enable pump power pin (PB10) via bsp_pump_set()
    Root cause: bsp_pump_set() existed but was never called.
    DAC output voltage was set correctly, but pump power enable
    pin (PB10) was never activated, so pump never spun.
    - handle_pump_ctrl(): bsp_pump_set(1) when speed>0, bsp_pump_set(0) when speed=0
    - handle_switch(): bsp_pump_set(0) on handle switch
    - power_task shutdown: bsp_pump_set(0) on shutdown
    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
    [protocol_act.c]
2026-07-18 fix: DAC SPI timing - use BSRR/BRR + 1us delays
    - Replaced HAL_GPIO_WritePin with direct BSRR/BRR register access
    - Increased SPI timing from ~14ns NOP to 1us per phase
    - Added debug print in set_voltage: [DAC7311] set X.XXXV -> raw=NNNN frame=0xNNNN
    - Ensures DAC has sufficient setup/hold time for data latching
    [dac7311.c]
2026-07-18 refactor: sync DAC driver from verify-dac7311idckr-demo
    - Replaced rt_hw_us_delay with demo's NOP-based dac_delay()
    - Added configurable delay: dac7311_set_delay() (0=fast NOP, >0=us)
    - Fast mode ~140ns per phase, matches proven demo driver
    - Kept pump speed control (dac7311_set_pump_speed) and bsp_pump_set calls
    - All BSRR/BRR direct register access preserved
    [dac7311.c, dac7311.h]
2026-07-18 fix: increase DAC SPI delay to 5us per phase
    Default changed from NOP (~140ns) to 5us per phase.
    16 bits x 3 phases x 5us = 240us per frame.
    Ensures DAC has sufficient time to latch each bit.
    [dac7311.c]
2026-07-18 test: set DAC default output to 2.75V for debugging
    - dac7311_init() now outputs 2.75V immediately after GPIO config
    - Tests if DAC SPI communication is working at boot
    - Check serial log for [DAC7311] set 2.750V -> raw=9011 frame=0x8CC8
    - Measure VOUT pin with multimeter to verify
2026-07-18 debug: add GPIOB register dump after DAC init
    Prints CRL, CRH, ODR to verify PB7/PB8/PB9 configured as
    50MHz push-pull output. Expected CRH bits for PB7/PB8/PB9: 0x333xxxxx
2026-07-18 debug: add PB8/PB9 manual toggle test in dac7311_init
    - PB8=HIGH/PB9=LOW for 3s, then PB8=LOW/PB9=HIGH for 3s
    - Measure with multimeter to verify GPIO is actually toggling
    - If no voltage change on PB8/PB9: GPIO config is wrong
    - If voltage changes: GPIO works, SPI/DAC communication is the issue
    [dac7311.c]
2026-07-18 fix: restore dac7311_set_pump_speed() lost during driver rewrite
    - Function was accidentally removed when syncing from demo project
    - Added back pump constants (PUMP_CTRL_MIN_V etc) to header
    - Added back dac7311_set_pump_speed() implementation to source
    - Fixes linker error: undefined reference to dac7311_set_pump_speed
    [dac7311.c]
2026-07-18 feat: add dactest shell command for DAC debugging
    Commands:
    dactest gpio - Toggle PB8/PB9 for hardware verification
    dactest volt <v> - Set specific voltage (0.0~5.0V)
    dactest sweep - Sweep 0V->5V in 1V steps (2s each)
    dactest pump <p> - Test pump speed mapping (0~100%)
    dactest dump - Dump GPIO registers + pin mode decode
    dactest frame <v> - Show frame value + binary breakdown
2026-07-18 fix: DAC frame mode bits overflow - mask to 0x3FFC
    value=16383 (0x3FFF) << 2 = 0xFFFC, mode bits became 11 instead of 00.
    Fixed: frame = (value << 2) & 0x3FFC
    - Forces mode bits D15:D14 to 00
    - Data in D13:D2 preserved
    - Reserved D1:D0 = 00
    5.0V: raw=16383 -> frame=0x3FFC (was 0xFFFC)
    [dac7311.c]
2026-07-18 feat: port full dac shell command from demo (wave + test mode)
    - Added waveform generator: sin/square/tri/saw with LUT timer
    - Added SPI test mode: repeat fixed frame for oscilloscope capture
    - Added math.h for sinf/M_PI
    - Shell: dac volt/raw/pct/pd/info/wave/test
    [dac7311.c]
2026-07-18 fix: pump enable tied to treatment start/stop, not speed setting
    - handle_pump_ctrl: only sets DAC voltage, does NOT enable PB10
    - handle_start_pause(action=1): enables PB10 pump for handle C
    - handle_start_pause(action=0): disables PB10, resets DAC and pump_speed
    - handle_switch: already disables PB10 and resets pump_speed (unchanged)
    - power_task shutdown: already disables PB10 (unchanged)
    [protocol_act.c]
2026-07-18 simplify: pump speed uses linear mapping (0%=0V, 100%=5V)
    Removed three-zone non-linear mapping, now simple:
    0% -> 0.0V
    50% -> 2.5V
    100% -> 5.0V
2026-07-18 docs: add pump speed 0%~100% commands to sscom51.ini
    - Added 11 pump entries (0%, 10%, 20%...100%) with CRC16
    - Renumbered subsequent entries (+8 offset)
    - N146-N156: pump labels
    - N46-N56: pump hex frames
2026-07-18 fix: rewrite sscom51.ini in correct reference format
    - Interleaved layout: label N1xx + hex Nxx per entry
    - Added \x04 (EOT) terminator on each hex line
    - CRLF line endings
    - Added comment headers matching reference file
    - Pump entries: N146-N156 (0%, 10%...100%)
    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
2026-07-20 refactor(pump): redefine pump voltage zones
    - Dead zone: 0~1V (motor off)
    - Control zone: 1~4.5V (speed regulation)
    - Saturation zone: 4.5~5.0V (full load)
    - Remap 0~100% command to new voltage ranges
    - 0% -> 0V, 1~99% -> linear 1~4.5V, 100% -> 5V
2026-07-20 refactor(waveform): unify all waveforms to 0~80mA range
    - Set max_current to 80mA for waveforms 3,6,7,8,9
    - Remove unnecessary clamping logic in handle_waveform_sel
    - All 9 waveforms now share uniform 0~80mA adjustable range
    - Waveform switching preserves percentage without recalculation
2026-07-20 refactor(waveform-9): change Soothing Ending frequency from 10Hz to 500Hz
    - half_wave_clk: 12500 -> 2000 (2MHz / 2*500)
    - Remove PCLK_DIV_16 for waveform 9 (no longer needed at 500Hz)
    - Update protocol.h comment
    [nnc6521_waveform_config.c, protocol.h]
2026-07-20 fix(waveform-9): remove PCLK_DIV_16 from waveform_apply for waveform 9
    Waveform 9 was still getting PCLK_DIV_16 applied in waveform_apply()
    even after frequency was changed to 500Hz. Need to measure actual
    output frequency after this fix and adjust half_wave_clk accordingly.
    [nnc6521_waveform_config.c]
2026-07-20 fix(waveform-9): adjust half_wave_clk to 33 for ~500Hz output
    Based on empirical measurement: PCLK_eff = 2,124,800Hz
    half_wave_clk = 2124800 / (500 * 2 * 64) = 33.2 -> 33
    Actual output: ~503Hz
    [nnc6521_waveform_config.c]
2026-07-20 fix(current-ctrl): disable AWG when current is set to 0mA
    handle_current_ctrl() was calling waveform_update_amplitude(0) without
    checking for zero, leaving AWG running and causing sawtooth artifact.
    Now matches handle_apply_output() behavior: percent==0 disables AWG.
    [protocol_act.c]
2026-07-20 refactor(current): reduce all waveforms to 0~30mA range
    - All 9 waveforms max_current changed from 80mA to 30mA
    - Updated sscom51.ini with 0~30mA current commands (step 5mA)
    for all 3 handles (A/B/C), 7 commands per handle
    - Updated protocol.h waveform definitions
2026-07-20 fix: resolve string literal line break in handle_current_ctrl
    [protocol_act.c]
2026-07-20 fix(current-ctrl): use handle_apply_output for 0mA->non-zero transition
    waveform_update_amplitude() only updates waveform data without full
    reconfiguration. After AWG is disabled by 0mA command, need full
    waveform_apply via handle_apply_output() to properly restart output.
    [protocol_act.c]
2026-07-20 refactor(waveform): add edge-softened waveform data to reduce stinging
    - Waveform 1 (Power Smooth): PRELOADED square -> CUSTOM_SPI softened square
    - Rising/falling edges ramp over 4 points instead of 0->1 jump
    - Waveform 2 (Burst Train): Replace sharp pulse with gaussian envelope
    - Max delta reduced from 1.0 to 0.24 per step
    - Waveform 3 (Gentle Smooth): PRELOADED square -> CUSTOM_SPI softened square
    - Same edge softening as waveform 1
    - Waveform 7 (Smooth & Firm): PRELOADED triangle -> CUSTOM_SPI softened triangle
    - Corner smoothing with cubic ease-in/out, max delta 0.049 per step
    - Sine waveforms (5,6,8,9) already smooth, no changes needed
    [nnc6521_waveform.c, nnc6521_waveform_config.c]
2026-07-20 fix: add extern declarations for softened waveform arrays
    [nnc6521.h]
2026-07-20 refactor(current): change from mA to μA (0~1000μA, 10μA step)
    - All waveforms max_current: 30mA -> 1000μA
    - Protocol byte 0~100 maps to 0~1000μA (10μA per step)
    - Current_Output(): removed *1000 conversion (input now in μA)
    - handle_current_ctrl(): protocol value * 10 = μA
    - sscom51.ini: regenerated with μA commands (0~1000μA, step 10μA)
2026-07-20 Revert "refactor(current): change from mA to μA (0~1000μA, 10μA step)"
    This reverts commit 71d4db02cfe4ffb5bbf58e9c308c231f95de8986.
    [nnc6521_drv.c, nnc6521_waveform_config.c, protocol.h, protocol_act.c]
2026-07-20 refactor(current): reduce all waveforms to 0~5mA range
    - All 9 waveforms max_current changed to 5mA
    - sscom51.ini: 0~5mA current commands for 3 handles (18 total)
2026-07-20 refactor(waveform-9): change Soothing Ending to 1kHz
    - half_wave_clk: 33 -> 17
    - Actual output: ~976Hz (close to 1kHz target)
2026-07-20 refactor(current): increase range to 0~80mA, step 5mA
    - All 9 waveforms max_current = 80mA
    - sscom51.ini: 0~80mA step 5mA, 17 commands per handle
2026-07-20 fix(sscom): update current commands to 0~80mA step 10mA
2026-07-21 docs(sscom): 电流范围从0~80mA改为0~8mA(步进1mA)
    - CRC16-MODBUS算法逆向验证通过(6组参考值全部匹配)
    - 通道A/B/C各9条命令(N105~N131),共27条协议帧
    - 电流值: 00~08(0~8mA), 步进1mA
    - 其他命令(版本/温度/水泵/波形/关机等)保持不变
2026-07-21 refactor(waveform): update waveform config and protocol docs for 0~8mA range
2026-07-21 feat(waveform): add current level lookup table for 9 waveforms
    - Add WAVEFORM_LEVEL_COUNT (11 levels: 0~10) to header
    - Add g_current_level_map[9][11] with per-waveform curve styles
    - Modify waveform_calc_current() to use level lookup table
    - External percent (0~100) interface unchanged, internal mapped to level 0~10
2026-07-21 refactor(protocol): current control from mA to level 0~10
    - handle_current_ctrl(): params[0] changed from mA (0~100) to level (0~10)
    - Internal lookup via g_current_level_map[waveform_id-1][level] for actual mA
    - Validation: level must be 0~10 (not 0~100)
    - ACK response returns [level, handle_id] instead of [mA, handle_id]
    - Updated protocol docs (full + concise) with level-based description
    - Updated sscom51.ini: labels from 'XmA-手柄Y' to '档位X-手柄Y'
    - Representative levels: 0,1,2,3,4,5,7,9,10 per handle (27 entries unchanged)
2026-07-21 refactor(current): 100μA step, 0~80 levels, unit changed to μA
    - WAVEFORM_LEVEL_COUNT: 11 -> 81 (0~80, step 100μA)
    - g_current_level_map[9][81]: 9 waveforms × 81 levels in μA
    - waveform_calc_current(): percent 0~100 -> level 0~80 lookup
    - waveform_apply(): removed *1000 (already in μA)
    - protocol_act.c: level 0~80 validation
    - protocol.h: current_ma field comment updated to μA
    - protocol docs updated (V4.13)
2026-07-21 refactor(waveform): change current levels from 81 (0~80) to 11 (0~10) gear-based
    - g_current_level_map: 9x81 to 9x11, each waveform uses distinct distribution
    - WF1: linear, WF2: sqrt, WF3: exp, WF4: S-curve, WF5: reverse-S
    - WF6: log, WF7: quadratic, WF8: cubic, WF9: parabolic
    - waveform_calc_current: auto-adapts via WAVEFORM_LEVEL_COUNT macro
    - WAVEFORM_LEVEL_COUNT: 81 to 11
    [nnc6521_waveform_config.c, nnc6521_waveform_config.h]
2026-07-21 refactor(waveform): reduce square wave pulse width to 150us
    - WF1 Power Smooth: 300us -> 150us, silent_time 600 -> 300
    - WF3 Gentle Smooth: 300us -> 150us, silent_time 600 -> 300
    - WF4 Deep Sculpt: 250us -> 150us
    - Update protocol.h waveform comments
2026-07-21 refactor(sscom): update SSCOM config for 0~10 gear-based current control
    - Add missing gear 6 and gear 8 commands for all handles (A/B/C)
    - Complete 11 gears (0~10) × 3 handles = 33 current commands
    - All CRC-16/MODBUS values verified
    - Re-index entries: current N105~N137, temp N138~N143, pump N144~N154
    - Remove old placeholder slots (65~100)
2026-07-21 fix(waveform): recalculate half_wave_clk for AWG_CLK=32.768kHz
    Empirical testing revealed AWG actual clock is 32.768kHz (internal oscillator),
    not 2MHz as previously assumed. All half_wave_clk values recalculated:
    WF1/WF2/WF4: 20000 -> 328 (50Hz)
    WF3: 28571 -> 468 (35Hz)
    WF5: 25000 -> 410 (40Hz)
    WF6: 12500 -> 102 (10Hz, PCLK/16)
    WF7: 10000 -> 164 (100Hz)
    WF8: 12500 -> 205 (5Hz, PCLK/16)
    WF9: 17 -> 16 (1kHz)
    [nnc6521_waveform_config.c]
2026-07-21 fix(waveform): restore WF1 half_wave_clk=328, confirmed AWG_CLK=32.768kHz
    AWG module uses independent ~32.768kHz clock, separate from SPI PCLK (2MHz).
    Empirical testing confirmed: T = 2 * half_wave_clk / 32768 matches all waveforms.
    [nnc6521_waveform_config.c]
2026-07-21 fix(current): increase current levels to 8000μA max, fix level validation
    - WF1/WF2/WF3: 1000μA max -> 8000μA max (proper distribution curves)
    - protocol_act.c: level validation 80 -> 10 (match new 0~10 gear range)
    [nnc6521_waveform_config.c, protocol_act.c]
2026-07-21 feat(waveform): 20% duty cycle alternating square wave
    Positive half (32pts): 20% high (6pts) + 80% low (26pts)
    Negative half (32pts): 80% low (26pts) + 20% high (6pts, inverted)
    Edge softening: 2 transition points at each edge
    [nnc6521_waveform.c]
2026-07-21 fix(waveform): WF3 uses separate 50% duty cycle waveform
    WF1: 20% duty cycle (softened_square_waveform_64)
    WF3: 50% duty cycle (softened_square_50pct_64, original)
    [nnc6521.h, nnc6521_waveform.c, nnc6521_waveform_config.c]
2026-07-21 fix(waveform): restart AWG after waveform data load to ensure new data takes effect
    [nnc6521_drv.c]
2026-07-21 fix(waveform): implement asymmetric mode with 128-point array
    Per NNC6521 datasheet:
    - Asymmetric mode requires 128-point array (64 pos + 64 neg)
    - CTRL_REG0 bit7=1 (asymmetric), bit6=1 (continuous 128pts)
    - point_num register = 64 (per half)
    - Buffer allocated for 128 points, all 128 written to NNC6521
    [nnc6521.h, nnc6521_drv.c, nnc6521_waveform.c, nnc6521_waveform_config.c]
2026-07-21 fix(protocol): use μA consistently in percent calculation
    Fixes precision loss: actual_ua/1000 truncated values < 1000μA to 0,
    causing low current levels to have zero output. Now all calc in μA.
    [protocol_act.c]
2026-07-22 feat(protocol): beep buzzer once on each valid command received
    [protocol_act.c]
2026-07-22 feat: add soft ramp for current transitions to avoid sting
    - Add current_ramp_to() with 2% steps, 15ms inter-step delay
    - Add volatile s_ramp_abort flag for interrupting ramp on new commands
    - Gear level switch: ramp from old% to new% instead of instant jump
    - Treatment start: waveform_apply at 0% then ramp to target
    - Waveform switch: stop old, apply new at 0%, ramp to target
    - Typical transition time: 200~400ms for normal gear changes
    [protocol_act.c]
2026-07-22 debug(nnc6521): add OTP calibration dump command (nnc_calib_dump)
2026-07-22 fix(nnc6521): add rtthread.h include and fix MSH_CMD_EXPORT syntax
    [nnc6521_drv.c]
2026-07-22 refactor: replace percent-based current control with direct μA passing
    - Add waveform_apply_current(): accepts actual_ua (μA) directly,
    bypasses waveform_calc_current() percent-to-μA conversion
    - Add waveform_update_amplitude_current(): amplitude update with μA
    - Refactor handle_apply_output(): use current_ma (μA) instead of percent
    - Refactor current_ramp_to(): 200μA steps (was 2%), 15ms inter-step
    - Refactor handle_current_ctrl(): remove percent calculation, use
    g_current_level_map directly for actual_ua
    - Refactor handle_start_pause(): ramp from 0μA to target on start
    - Refactor handle_waveform_sel(): ramp from 0μA on waveform switch
    - Refactor protocol_start_waveform(): use w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
    [nnc6521_waveform_config.c, nnc6521_waveform_config.h, protocol_act.c]
2026-07-22 feat(ramp): change current_ramp_to() to dynamic step size
    - Replace fixed 200μA step with dynamic step size based on diff
    - Calculate steps = ceil(diff / (RAMP_TOTAL_MS / RAMP_STEP_MS)) to fit within 100ms
    - Step size = diff / steps (minimum 1 μA)
    - Keep inter-step delay at 15ms (RAMP_STEP_MS)
    - Preserve s_ramp_abort interrupt mechanism
    - Preserve waveform_update_amplitude_current() call pattern
    [protocol_act.c]
2026-07-22 refactor(ramp): convert current_ramp_to() to non-blocking dedicated thread
    - Add ramp_thread_entry() running at priority 6 with 512B stack
    - current_ramp_to() now sets volatile params + releases semaphore, returns immediately
    - Ramp thread waits on semaphore, executes step-wise ramp with abort support
    - Remove blocking rt_thread_mdelay(20) from handle_current_ctrl and handle_waveform_sel
    - Add ramp_thread_init() called from protocol_init() after decode thread startup
    - Eliminates ~100ms UART decode thread blocking during current ramp transitions
2026-07-22 fix(ramp): lower ramp thread priority to 15 (below protocol at 10)
    [protocol_act.c]
2026-07-22 fix(ramp): fix race conditions - drain semaphore, abort in switch/pause, check abort after delay
    [protocol_act.c]
2026-07-22 refactor: remove soft-start ramp feature and thread
2026-07-22 feat: add non-blocking soft-start ramp via periodic timer
    - Add RT-Thread soft timer (10ms period) for gradual current ramping
    - Ramp state machine: calculates step size from diff/RAMP_MAX_STEPS
    - Supports dynamic target update without timer restart
    - Modify handle_current_ctrl() to use current_ramp_start() instead of
    direct handle_apply_output() for non-blocking current transitions
    - handle_start_pause() and handle_waveform_sel() unchanged (full apply)
2026-07-22 fix(proto): increase RX buffer 512->2048, reduce decode delay 5ms->1ms
    [protocol.c, protocol.h]
2026-07-22 refactor: remove soft-start timer ramp logic
2026-07-22 feat: split current level map into A and B/C handle tables
    - Replace g_current_level_map with g_current_level_map_a (face/high current)
    and g_current_level_map_bc (body/half current)
    - handle_current_ctrl() now selects table based on handle index (hi==0 → A, else B/C)
    - waveform_calc_current() defaults to A table for generic callers
    [nnc6521_waveform_config.c, nnc6521_waveform_config.h, protocol_act.c]
2026-07-22 fix(switch): always stop old handle AWG on handle switch, not just when running
    [protocol_act.c]
2026-07-22 refactor(pump): linear voltage mapping 0%=0V 100%=5V
2026-07-22 refactor(dac7311): remove wave/test modes, keep voltage control only
2026-07-22 fix(dac7311): correct SPI frame format - no left shift, data in D13:D0
    [dac7311.c]
2026-07-23 feat: map temperature percent (0~100) to 20~41C range
2026-07-23 refactor: linearize current level maps - even distribution across 10 steps
2026-07-23 docs: update protocol docs for temperature percent mapping and linearized current level maps
    - 通讯协议文档.md: V4.14 - 温度控制从直接温度值(0~41℃)改为百分比(0~100%)，映射20~41°C；新增温度百分比映射表和公式；更新所有温度相关帧CRC（Python计算验证）；更新附录A/C
    - 通讯协议文档-简洁版.md: V2.1 - 同步更新温度控制参数和帧示例
    - NTC温度PID控制算法设计文档.md: V1.4 - 更新协议层集成说明（百分比→温度映射）
    - NTC_Temperature_PID_Control_Algorithm_Design.en.md: V1.4 - English version同步更新
    - 项目需求文档.md: V3.9 - 更新温度控制模块参数定义和结构体注释
    - 测试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
2026-07-23 refactor: remap pump DAC 0~100% to 0~3.5V (was 0~5.0V)
2026-07-23 docs: update pump DAC voltage range to 0~3.5V in protocol docs
2026-07-23 fix: correct CRC16 for temperature percent commands in sscom51.ini
2026-07-23 feat: add look-ahead power limiting and anti-windup for PID overshoot control
    [temp_pid.c]
2026-07-23 tune: reduce PID look-ahead window from 3C to 2C
2026-07-23 fix: enforce mutual exclusion on current control - reject non-active handle
    [protocol_act.c]
2026-07-23 fix: fully disable analog output on handle stop to prevent residual current
    [nnc6521.h, nnc6521_drv.c, protocol_act.c]
2026-07-23 fix: disable all analog bits including IDAC to fully cut channel output
    [nnc6521_drv.c]
2026-07-23 fix: zero VDAC register on analog disable to fully cut output current
    [nnc6521_drv.c]
2026-07-23 fix: remove analog auto-enable from wavegen_config, control explicitly in callers
    [nnc6521_drv.c, protocol_act.c]
2026-07-23 fix: disable global drive enable on stop to prevent any waveform re-activation
    [protocol_act.c]
2026-07-23 fix: disable sibling channel on same chip when enabling output (A/B mutual exclusion)
    [protocol_act.c]
2026-07-23 fix: disable ALL channels on chip before enabling target channel
    [protocol_act.c]
2026-07-23 fix: disable multi_electrode bit to prevent cross-channel coupling
    [nnc6521_drv.c]
2026-07-23 fix: revert multi_electrode, zero other channel VDAC to prevent cross-output
    [nnc6521_drv.c, protocol_act.c]
2026-07-23 fix: full chip reset on stop/apply - zero all channels then enable only target
    [protocol_act.c]
2026-07-23 fix: WAVEGEN_GLOBAL_REG_0=0x00 for independent channel control (was 0x01=simultaneous)
    [nnc6521_drv.c, protocol_act.c]
2026-07-24 fix: enable PID when setting temp while treatment is running
    When user sets temperature after starting treatment (switch handle -> start -> set temp), PID was never enabled because start checks target>0 before temp is set, and set_target does not enable PID.
    Added logic in handle_temp_ctrl(): if is_running && target>0, auto-enable PID; if target==0, auto-disable PID.
    [protocol_act.c]
2026-07-24 feat: add direct shutdown command (0x0D) from host
    New protocol function FUNC_SHUTDOWN_CMD (0x0D) allows upper machine
    to directly shut down the device without button press or confirmation flow.
    - protocol.h: define FUNC_SHUTDOWN_CMD 0x0D
    - bsp_typedef.h: add power_shutdown_direct flag
    - protocol_act.c: handle 0x0D -> set flag + ACK
    - power_task.c: check flag in POWER_STATE_ON -> immediate shutdown
2026-07-24 refactor: reuse 0x0A for direct host shutdown, remove 0x0D
    Revert FUNC_SHUTDOWN_CMD (0x0D). Instead, when host sends 0x0A+0x01
    directly (without prior button press), device shuts down immediately.
    - power_task.c: check power_shutdown_confirmed in POWER_STATE_ON
    - protocol.h/bsp_typedef.h/protocol_act.c: revert 0x0D additions
    [protocol.h, protocol_act.c]
2026-07-24 fix: reduce handle B anti-overshoot approach limit from 2.0°C to 1.0°C
    Handle B (large) now starts power limiting at 1.0°C from target
    instead of 2.0°C. Handle A (small) remains at 2.0°C.
    [temp_pid.c]
2026-07-24 fix: increase handle B preheat max power from 5% to 10%
    Handle B (large) preheat power was too low at 5% compared to
    handle A at 12%. Increased to 10% for faster warm-up.
    [temp_pid.h]
2026-07-24 fix: raise max target temperature from 41°C to 43°C
    - temp_pid.h: TEMP_MAX_CELSIUS 41 -> 43
    - protocol_act.c: update percent-to-temp mapping range to 20~43°C
    [protocol_act.c, temp_pid.h]
2026-07-24 fix: raise overheat protection threshold from 45°C to 46°C
    [temp_pid.h]
2026-07-28 fix: remove analog enable at boot to prevent unexpected current output
    - Remove nnc6521_analog_enable() calls from main.c boot sequence
    - Add nnc6521_analog_disable() at end of nnc6521_init() for clean state
    - Analog frontend now only enabled in handle_apply_output when treatment starts
    - Fixes: current output during mode switch before gear level is set
    [nnc6521_drv.c]
2026-07-28 fix: prevent current output when start with gear 0
    - handle_start_pause: boost enable moved into handle_apply_output
    - handle_apply_output: when current=0, disable AWG+analog and return without enabling boost
    - handle_apply_output: when current>0, enable boost before output (handles 0->non-zero transition)
    - Fixes: start with level 0 still produced current due to unconditional boost enable
    [protocol_act.c]
2026-07-28 fix: prevent current output when switching waveform at gear 0
    - handle_waveform_sel: skip analog_enable + waveform_apply when current_ma=0
    - protocol_start_waveform: early return when current_ma=0
    - Root cause: these functions only checked is_running, not current_ma
    - Fixes: switching waveform while running at level 0 produced current output
    [protocol_act.c]
2026-08-01 docs: V4.1 明确电流输出全局行为 - 切换手柄不停止电流，档位0停止波形
2026-08-01 docs: V4.1 审核修正 - 移除旧波形切换安全描述，统一boost全局行为说明
2026-08-01 feat: V4.1 电流输出全局化重构 - 切换手柄不停止电流，boost改为全局PB1控制
    - protocol.h: device_state_t 新增 current_level 全局字段
    - protocol_act.c: 8处核心函数重构
    - handle_switch: 不再停止电流/波形，仅清零加热/泵参数
    - handle_current_ctrl: 2参数改为1参数(仅档位)，全局查表
    - handle_apply_output: 使用全局current_level查表获取实际电流
    - handle_stop_output: 移除per-handle boost控制
    - handle_start_pause: 启用/禁用全局boost(PB1)
    - handle_waveform_sel: 使用handle_apply_output替代手动寄存器操作
    - protocol_start_waveform: 简化为使用全局level检查
    - protocol_act.h: 移除废弃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
2026-08-03 2026-08-03 15：01
2026-08-03 fix: sscom51.ini updated to V5.0 protocol - Chinese descriptions, corrected CRC for all frames, added waveform/shutdown/PID commands
2026-08-04 fix: correct CRC16/MODBUS checksums for 11 commands (func 0x02 current levels + N58/N59)
2026-08-04 fix: reject treatment start when current_level=0, remove redundant boost enable
    - handle_start_pause: return ERR_PARAM if current_level==0 before starting
    - handle_apply_output: remove redundant bsp_boost_2_enable(1) + mdelay(10),
    boost is already enabled by handle_start_pause
    [protocol_act.c]
2026-08-04 fix: remove preload_mode overwrite in nnc6521_customized_waveform
    The line 'preload_mode = 0' overwrote the correct asymmetric mode setting
    (preload_mode=1) at the end of nnc6521_customized_waveform(). This caused
    nnc6521_wavegen_config() to only write 64 points (positive half) instead
    of 128 points (positive + negative half). The NNC6521 read garbage data
    for the negative half-cycle, resulting in no valid current output.
    All 9 waveforms use GEN_METHOD_CUSTOM_SPI with 128-point asymmetric
    arrays, so all were affected.
    [nnc6521_drv.c]
2026-08-04 debug: add runtime state prints to diagnose no-current-output issue
    - handle_start_pause: print handle/waveform/level at treatment start
    - handle_waveform_sel: print waveform_id after save
    - handle_current_ctrl: print current_level after save
    - handle_apply_output: print level map indices for traceability
    Also includes preload_mode fix from previous commit.
    [protocol_act.c]
2026-08-04 fix: write CTRL_REG0 with enable_wavegen=0 first, then enable after all data ready
    Split control register write into two steps:
    1. Write CTRL_REG0 with enable_wavegen=0 (configure only, no output)
    2. Write CTRL_REG0 with enable_wavegen=1 (start output)
    This prevents the NNC6521 from reading waveform memory before data is loaded.
    [nnc6521_drv.c]
2026-08-04 fix: correct chip mapping - Handle A uses NNC6521_CHIP_2 CH0
    Hardware: NNC6521-2 (CHIP_2) CH0 is the current output channel,
    powered by LGS6302EP-2 (PB1). Previous code mapped Handle A to
    CHIP_1, causing waveform/current commands to target wrong chip.
    [protocol_act.c]
2026-08-06 fix: LED boot shutdown race + PID debug logs
    Bug 1 (bsp_key.c): KEY_Scan() now only triggers shutdown when
    POWER_STATE_ON, not during BOOTING/WAIT/SHUTTING_DOWN. This prevents
    the power button from immediately requesting shutdown during boot,
    which caused the LED to flash on then off.
    Bug 2 (protocol_act.c + temp_pid.c): Added debug logging:
    - handle_start_pause() logs PID enabled/target/preheat state after start
    - temp_pid_tick() logs [PID-SKIP] every ~5s when PID is not enabled
    but target_temp > 0, helping diagnose why PID might not compute
    [bsp_key.c, protocol_act.c, temp_pid.c]
2026-08-06 fix: decouple PID/temp from current_level in start_pause
    Root cause: current_level==0 triggered early return in handle_start_pause(),
    skipping PID enable and temperature reporting entirely.
    Fix: current_level==0 now only skips current/waveform output. PID and
    temp reporting always execute on treatment start, so heating works
    independent of current setting.
    [protocol_act.c]
2026-08-06 fix: move pump enable outside current_level check
    Handle C pump (PB10) was only enabled when current_level > 0.
    Moved bsp_pump_set(1) outside the current_level conditional so
    pump works independently of current setting.
    [protocol_act.c]
2026-08-12 fix: block current output when current_level is 0 - stop output on handle switch, disable boost, add level==0 guard in handle_apply_output
    [protocol_act.c]
2026-08-13 fix: reconfigure output channel on handle switch + remove aging mode + fix 54V boost lifecycle
    - handle_switch: reconfigure output for new handle when treatment is running
    (different handles map to different NNC6521 channels: A->CH0, B->CH1, C->CH0)
    - handle_current_ctrl: enable 54V boost before output, disable on level=0
    - handle_waveform_sel: enable 54V boost before reconfiguring output
    - Delete aging_mode function, dispatch case, macro, and struct field
    - protocol.c: remove aging_mode initialization
    - protocol_stop_waveform: add CH1 analog disable
    [protocol.c, protocol_act.c]
2026-08-13 fix: all handles use CHIP_2 CH0 for microcurrent output
    - handle_to_channel: always return WAVEFORM_GEN_CH0 (microcurrent is global)
    - handle_apply_output: use g_current_level_map_a for all handles
    - Reduce shutdown scope to target channel only (not both channels)
    [protocol_act.c]
