young-whites/microcurrent-beauty-device-v10/(notices)

Notices in the files:
workItem-djm-v10-LTS/cubemx/Inc/main.h:
Copyright (c) 2026 STMicroelectronics.
All rights reserved.
This software is licensed under terms that can be found in the LICENSE file
